airball-aero/airball-embedded/arduino/README.md

<!--
 The MIT License (MIT)

 Copyright (c) 2018, Jeremy Cole

 Permission is hereby granted, free of charge, to any person obtaining a copy
 of this software and associated documentation files (the "Software"), to deal
 in the Software without restriction, including without limitation the rights
 to use, copy, modify, merge, publish, distribute, sublicense, and/or sell
 copies of the Software, and to permit persons to whom the Software is
 furnished to do so, subject to the following conditions:

 The above copyright notice and this permission notice shall be included in
 all copies or substantial portions of the Software.

 THE SOFTWARE IS PROVIDED "AS IS", WITHOUT WARRANTY OF ANY KIND, EXPRESS OR
 IMPLIED, INCLUDING BUT NOT LIMITED TO THE WARRANTIES OF MERCHANTABILITY,
 FITNESS FOR A PARTICULAR PURPOSE AND NONINFRINGEMENT. IN NO EVENT SHALL THE
 AUTHORS OR COPYRIGHT HOLDERS BE LIABLE FOR ANY CLAIM, DAMAGES OR OTHER
 LIABILITY, WHETHER IN AN ACTION OF CONTRACT, TORT OR OTHERWISE, ARISING FROM,
 OUT OF OR IN CONNECTION WITH THE SOFTWARE OR THE USE OR OTHER DEALINGS IN
 THE SOFTWARE.
-->

Support for the SparkFun Fio v3 must be added to the Arduino IDE, by following the [installation instructions](https://github.com/sparkfun/Arduino_Boards#installation-instructions) to add the SparkFun Arduino Boards repository as an additional board manager URL. Once the SparkFun Arduino Boards are installed, "SparkFun Fio v3" should be available as a board choice (Tools → Board → Arduino AVR Boards → SparkFun Fio v3).

Additionally, the following Arduino libraries must also be installed:

* [TI\_TCA9548A](https://github.com/jeremycole/TI_TCA9548A) – Used for the TI TCA9548A I²C multiplexer.
* [AllSensors\_DLHR](https://github.com/jeremycole/AllSensors_DLHR) – Used for the AllSensors DLHR differential pressure sensors.
* [AllSensors\_DLV](https://github.com/jeremycole/AllSensors_DLV) – Used for the AllSensors DLV absolute pressure sensor.
* [Temperature\_LM75\_Derived](https://github.com/jeremycole/Temperature_LM75_Derived) – Used for the on-board TI TMP275 temperature sensor.
* [OneWire](https://github.com/PaulStoffregen/OneWire) – Used by the DallasTemperature library.
* [DallasTemperature](https://github.com/milesburton/Arduino-Temperature-Control-Library) – Used for the external Maxim DS18B20 1-Wire temperature sensor for measuring outside air temperature.
* [Maxim_DS2782](https://github.com/jeremycole/Maxim_DS2782) – Used for the on-board battery management IC.
* [TimerOne](http://playground.arduino.cc/Code/Timer1) – Used to set up an interrupt to trigger measurement at a specific interval.

The above libraries may be installed using one of the following methods:

1. Using the Arduino IDE's library manager (Sketch → Include Library → Manage Libraries...) to download the most current version and allow automatic updates with new releases.
2. Downloading a specific release (or the "master" branch) from Github as a .ZIP file and installing it using the Arduino IDE's library manager (Sketch → Include Library → Add .ZIP Library...).
3. Manually installing either the .ZIP file as above or cloning the Git repository itself into the `libraries` subdirectory in the Arduino Sketchbook directory (Settings → Sketchbook location) – or doing so here and re-setting the sketchbook directory to this directory.
