airball-aero/airball-embedded/data/2018-02-10-01/README.md

Test flight in Cessna 172 N2021L, probe mounted on strut. Two flights,
KPAO KHAF and return KHAF KPAO.

Plots discussed in the following article:
http://www.airball.aero/2018/02/yaw-bias-due-to-asymmetric-mounting.html
