airball-aero/airball-embedded/data/2018-02-02-01/README.md

This is *Airball Sensor Board V3 (2018-01-18)* with no baro sensor, in
a road test on the car mast. Traffic was busy so the peak speed,
observed near the start of the dataset, was 59mph, and the remainder
of the test was during slow-and-go traffic.
