airball-aero/airball-embedded/data/2017-12-22-01/README

Probe with possibly damaged board sitting on the desk, sending data. The
two files are for on-battery and on-USB-power operation. Lots of spikes
in the readings which are as of yet unexplained.
