airball-aero/airball-embedded/data/2017-12-10-01/README

Test run on Highway 280 with the probe on top of the car mast. Pitot
sensor only since only one pressure gage (plus temperature) installed
on the board.
