airball-aero/airball-embedded/data/2017-12-26-01/all.png

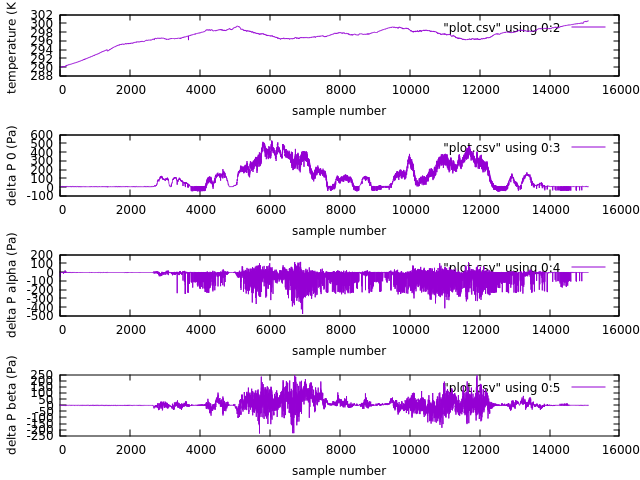
data/2017-12-26-01/all.png
