airball-aero/airball-embedded/data/2017-12-26-01/subset-showing-spikes.png

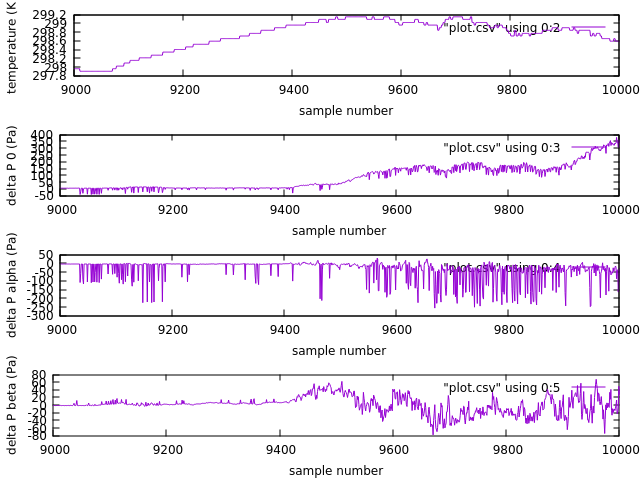
data/2017-12-26-01/subset-showing-spikes.png
