airball-aero/airball-embedded/data/2017-12-30-01/data.png

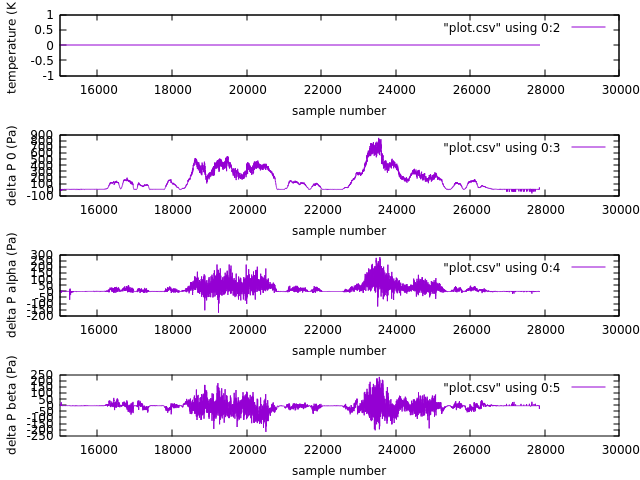
data/2017-12-30-01/data.png
