airball-aero/airball-embedded/data/2017-12-30-01/delta_p_0_75mph.png

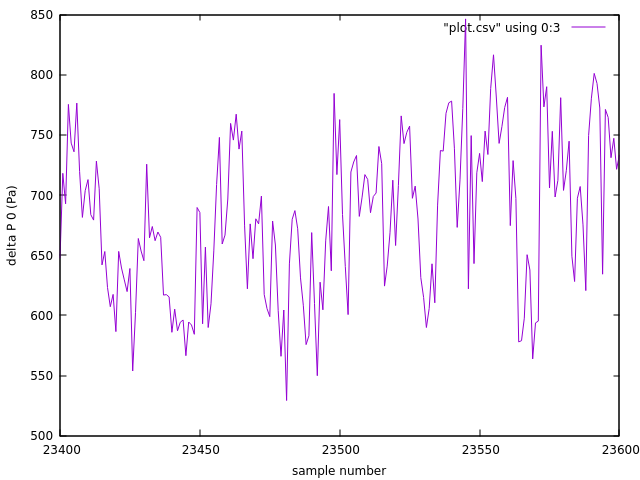
data/2017-12-30-01/delta_p_0_75mph.png
