airball-aero/airball-embedded/data/2017-12-30-01/delta_p_0_spikes.png

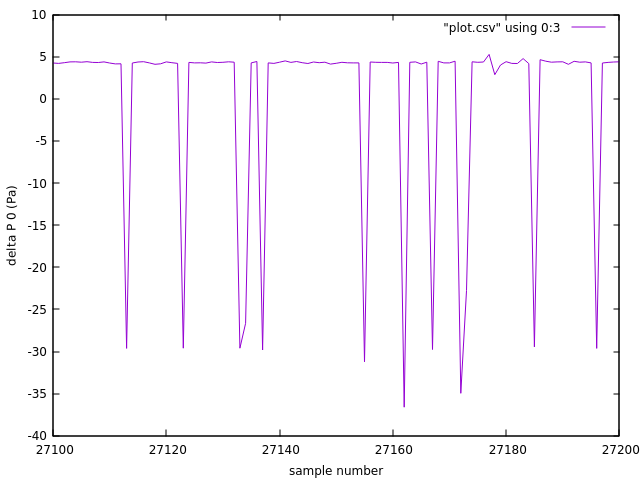
data/2017-12-30-01/delta_p_0_spikes.png
