airball-aero/airball-embedded/data/2017-12-30-01/fir-filter-airdata.png

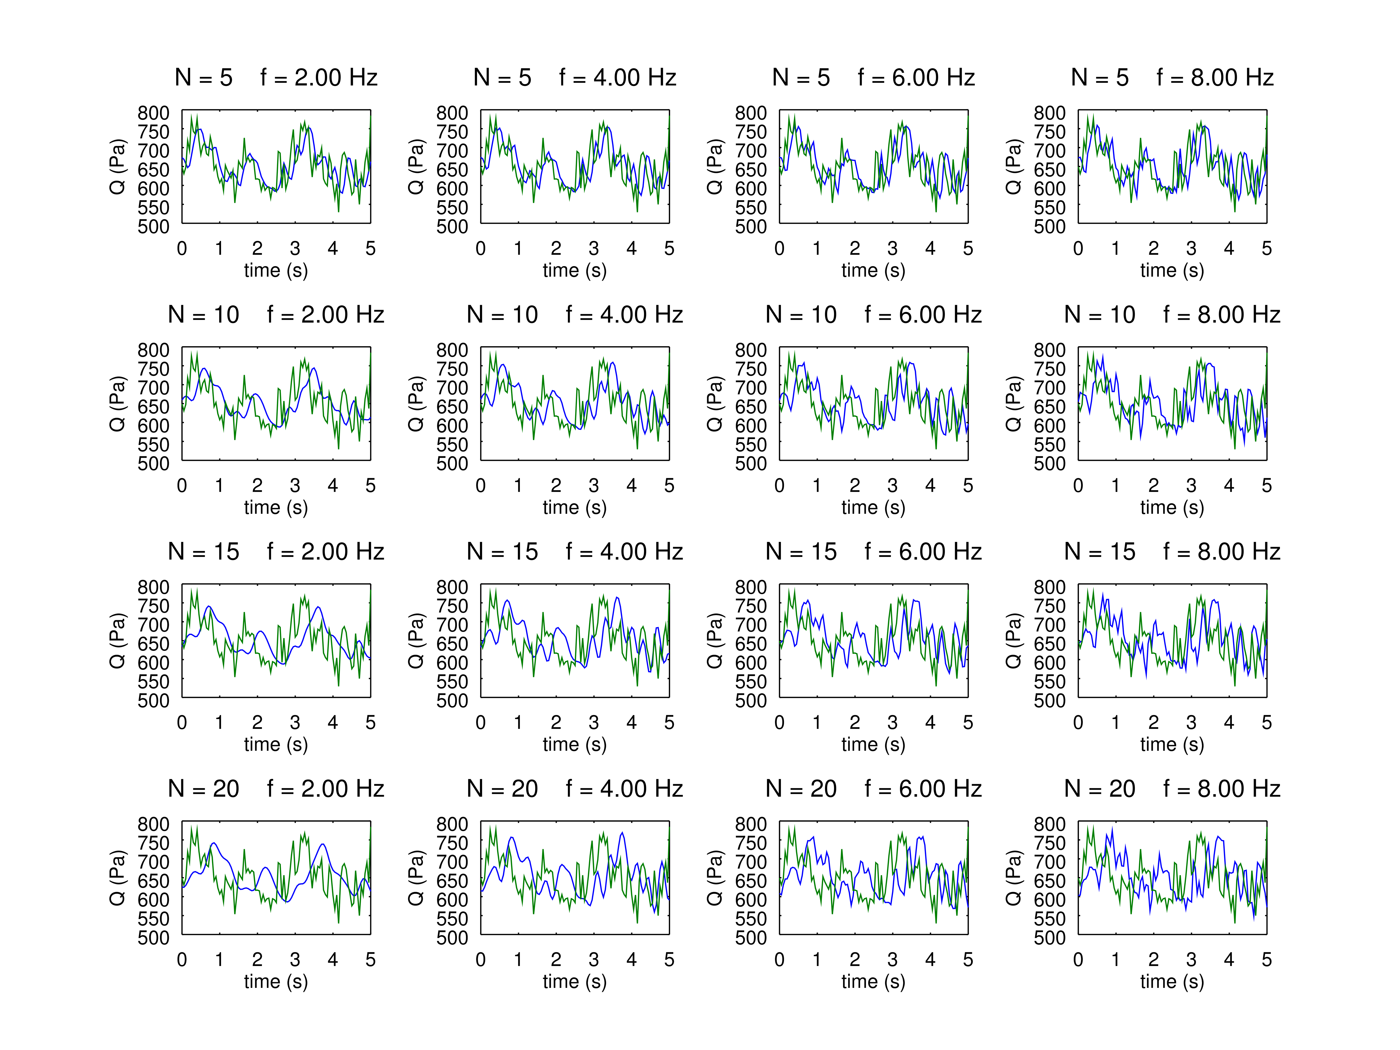
data/2017-12-30-01/fir-filter-airdata.png
