airball-aero/airball-embedded/data/2018-02-02-01/all_variables.png

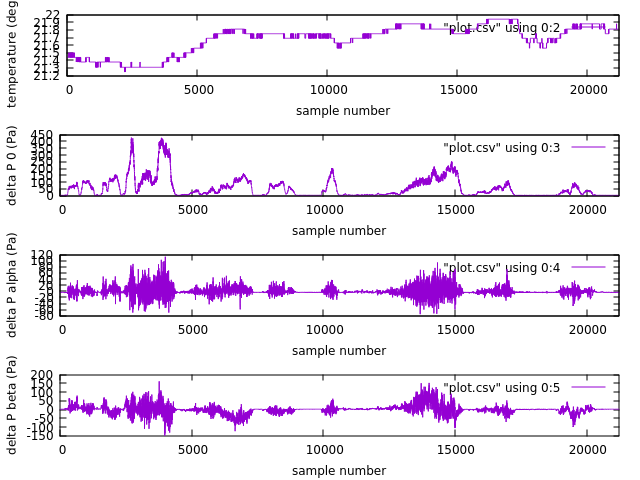
data/2018-02-02-01/all_variables.png
