airball-aero/airball-embedded/data/2018-02-02-01/high_speed_region.png

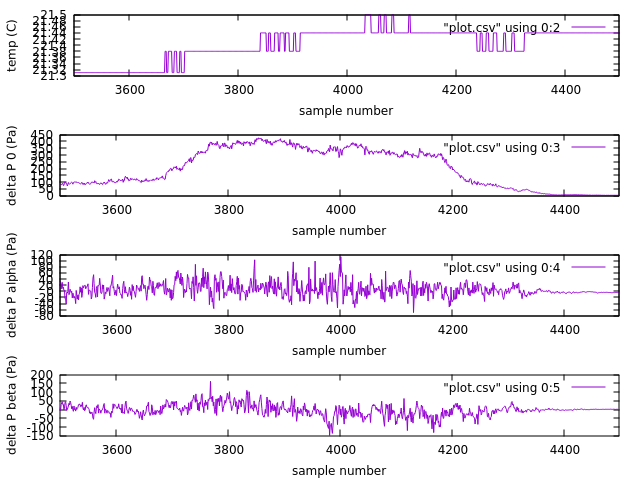
data/2018-02-02-01/high_speed_region.png
