airball-aero/airball-embedded/data/2018-02-10-01/beta_vs_dp0_slowing.png

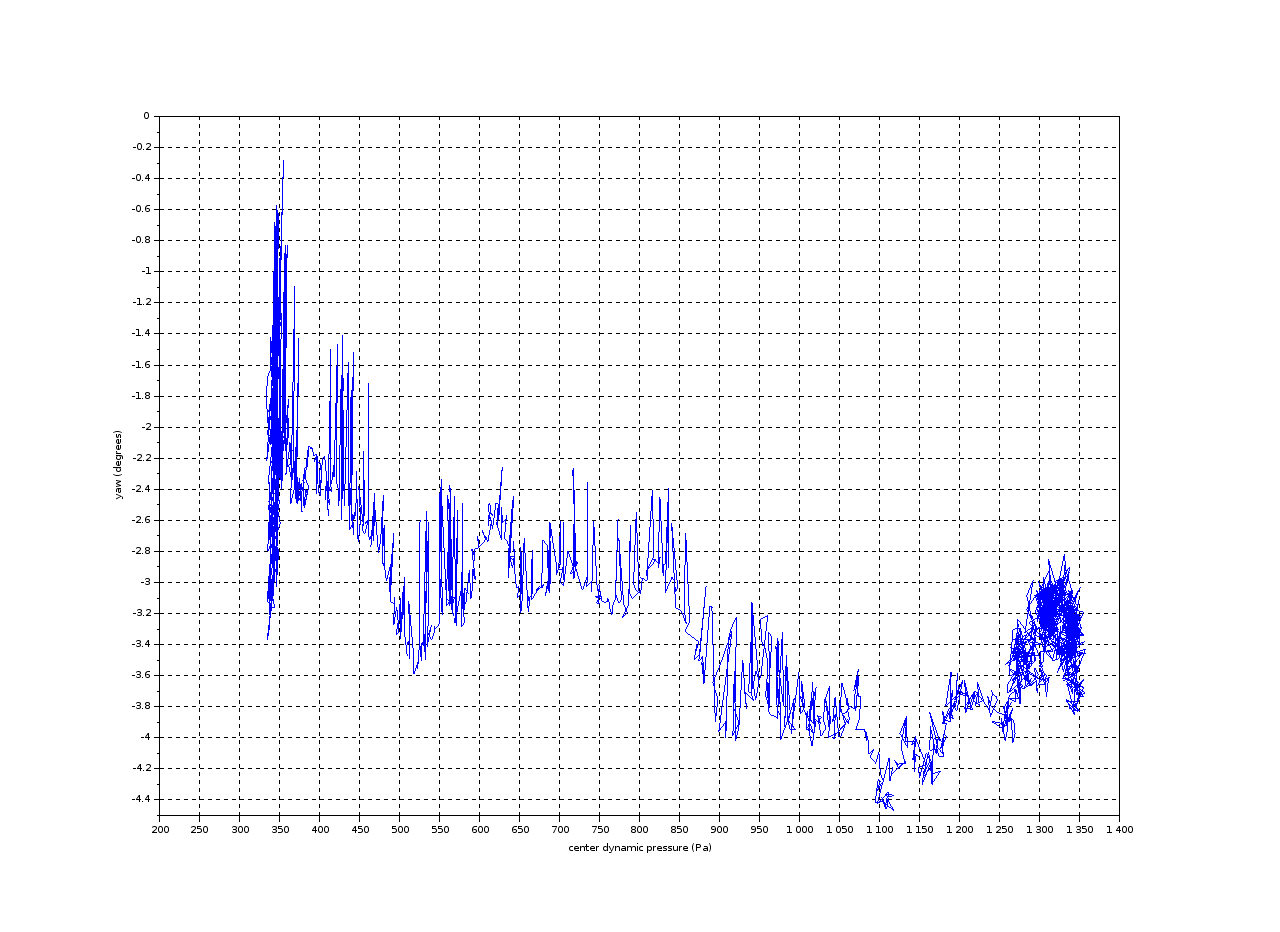
data/2018-02-10-01/beta_vs_dp0_slowing.png
