airball-aero/airball-embedded/data/2018-02-10-01/dp0_and_beta_maneuvers.png

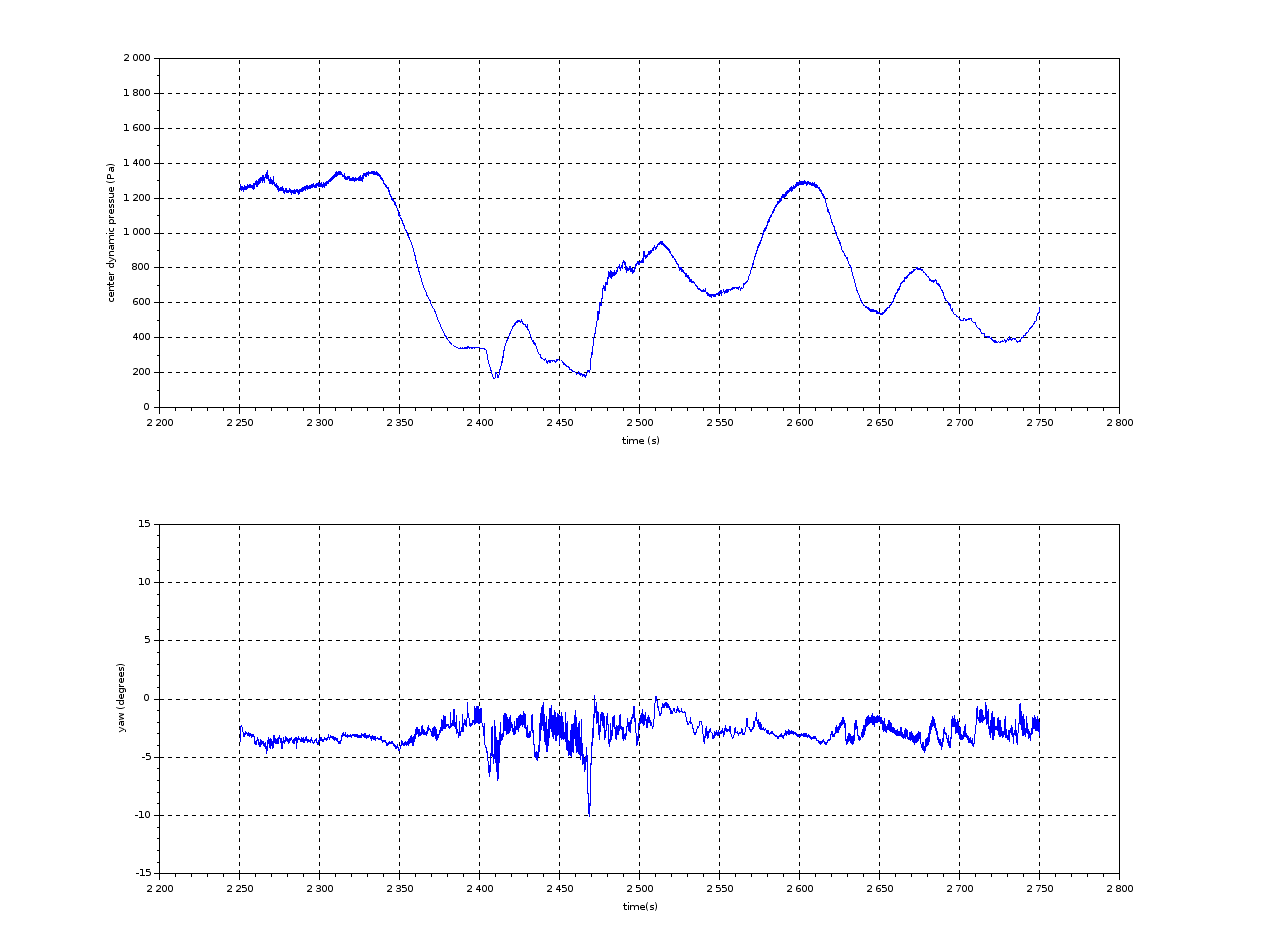
data/2018-02-10-01/dp0_and_beta_maneuvers.png
