airball-aero/airball-embedded/data/2018-03-09-01/entire_flight.png

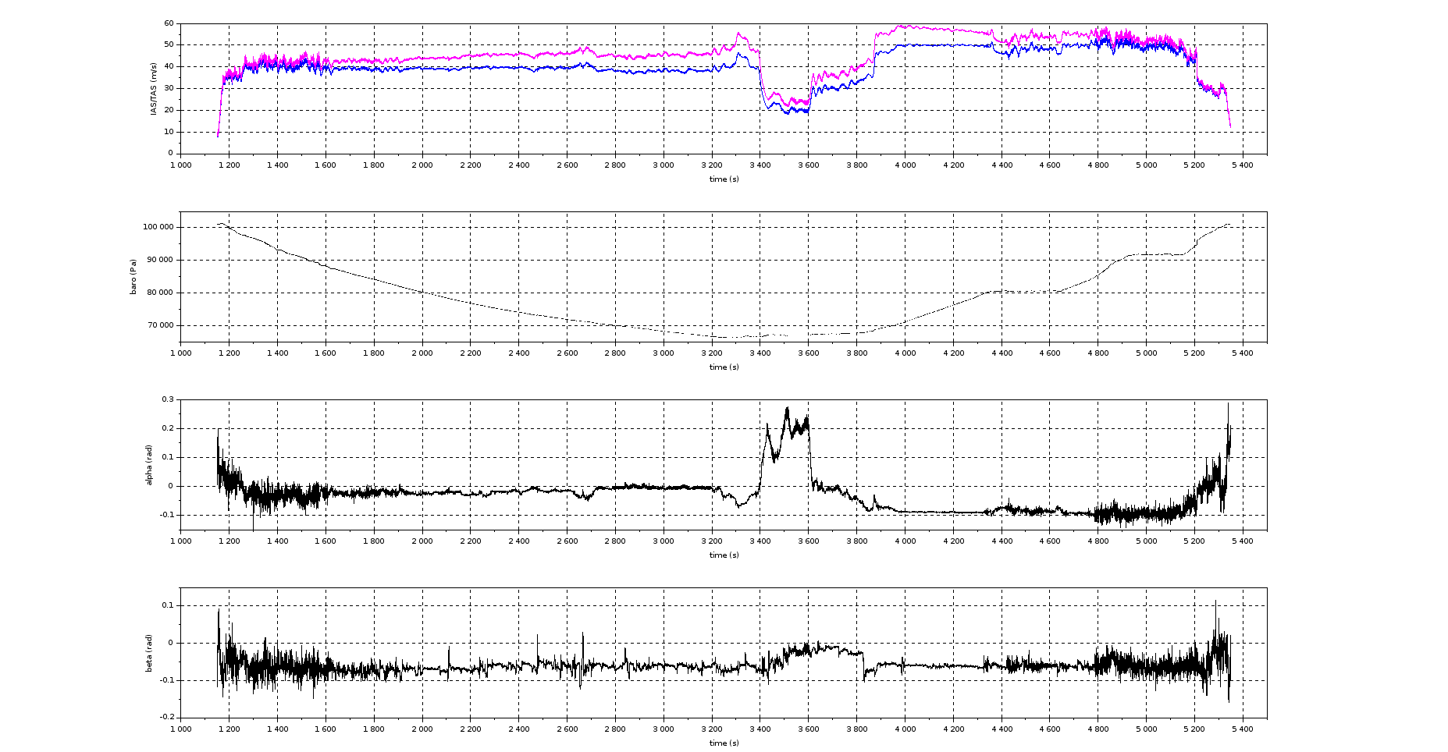
data/2018-03-09-01/entire_flight.png
