airball-aero/airball-embedded/data/2018-03-29-1/alpha_vs_ias.png

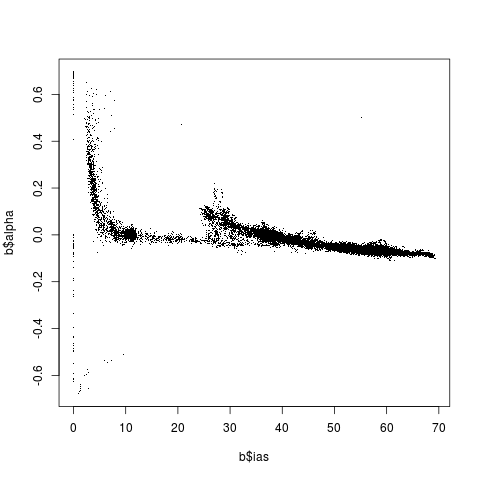
data/2018-03-29-1/alpha_vs_ias.png
