airball-aero/airball-embedded/data/2018-03-29-1/baro.png

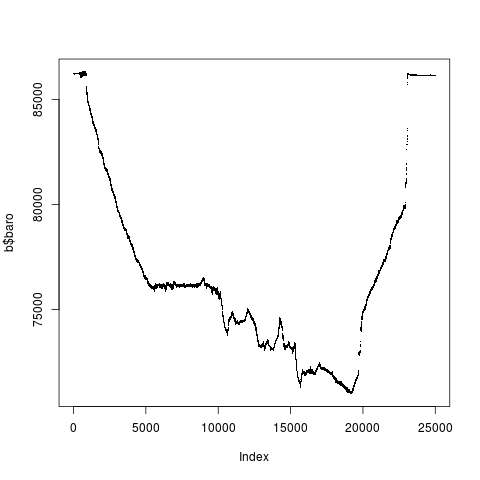
data/2018-03-29-1/baro.png
