airball-aero/airball-embedded/data/2018-03-29-1/ias_tas.png

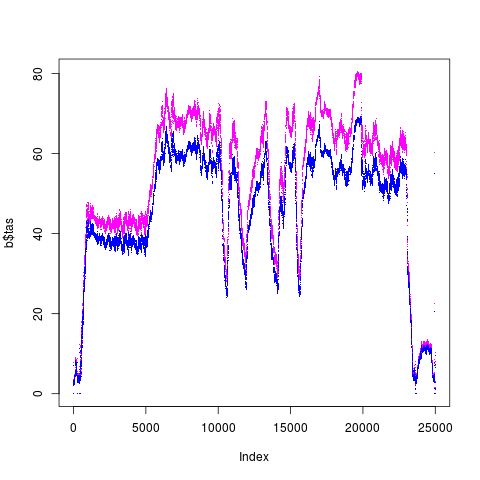
data/2018-03-29-1/ias_tas.png
