airball-aero/airball-embedded/data/2018-03-29-1/q.png

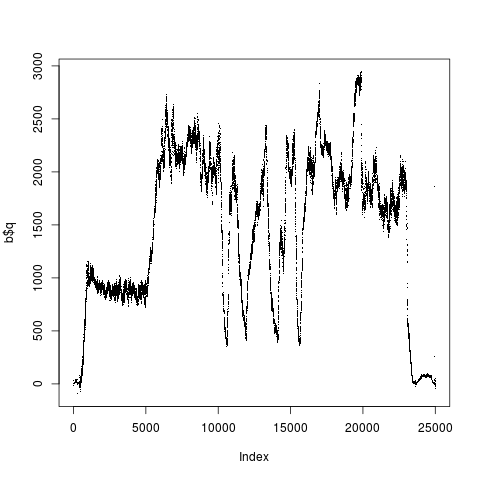
data/2018-03-29-1/q.png
