airball-aero/airball-embedded/firmware/airball_probe_esp32/alpha_beta_to_deltas_dpa.png

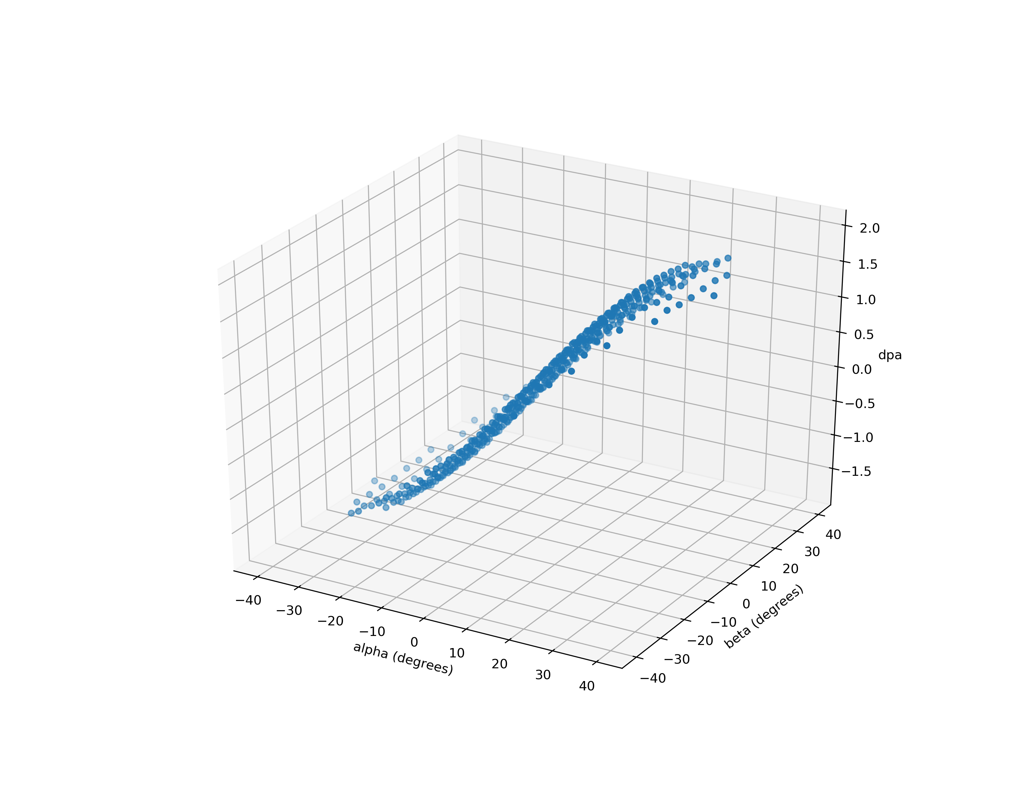
firmware/airball_probe_esp32/alpha_beta_to_deltas_dpa.png
