airball-aero/airball-embedded/firmware/airball_probe_esp32/curve_fit_1_over_dp0.png

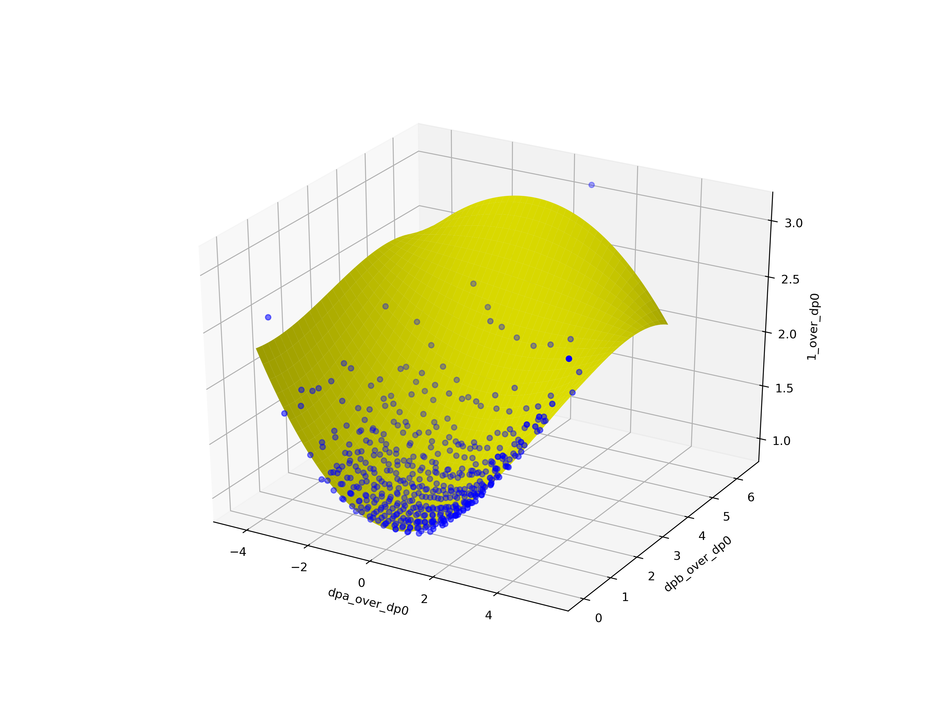
firmware/airball_probe_esp32/curve_fit_1_over_dp0.png
