airball-aero/airball-embedded/firmware/airball_probe_esp32/curve_fit_alpha.png

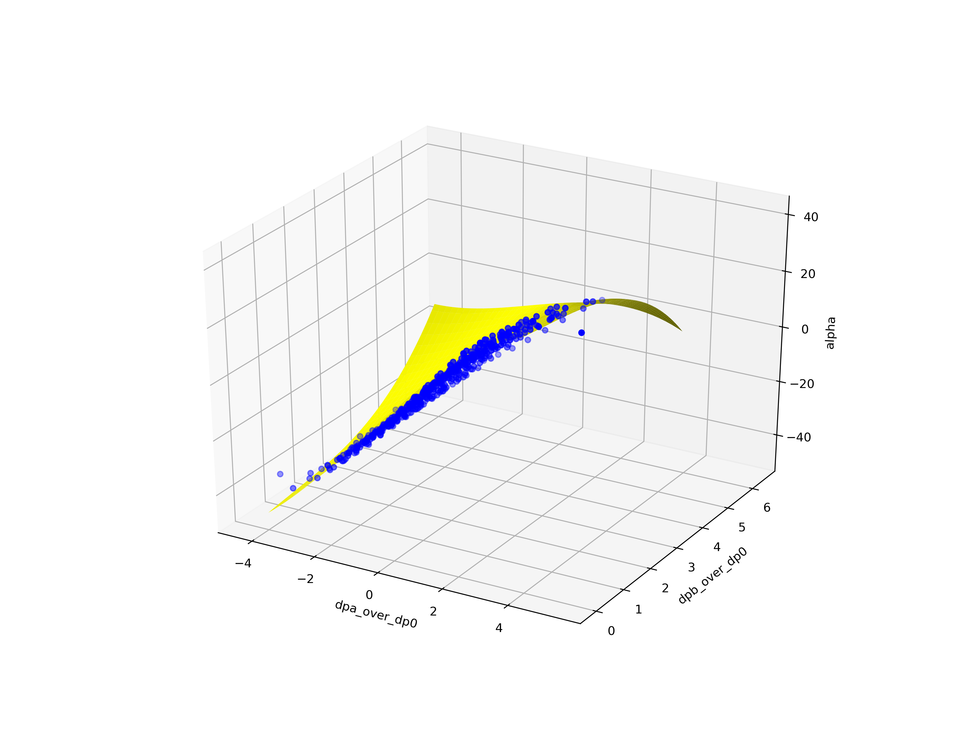
firmware/airball_probe_esp32/curve_fit_alpha.png
