airball-aero/airball-embedded/firmware/airball_probe_esp32/curve_fit_beta.png

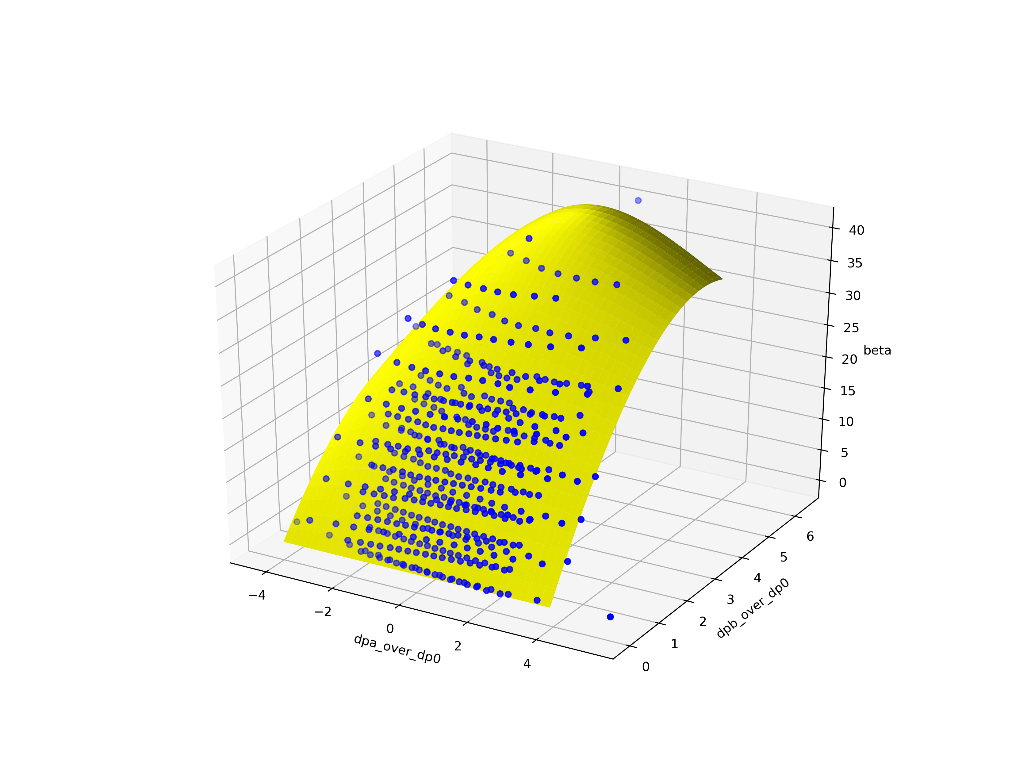
firmware/airball_probe_esp32/curve_fit_beta.png
