airball-aero/airball-embedded/hardware/DisplayBoard/airball_display_board_v1_render_top.png

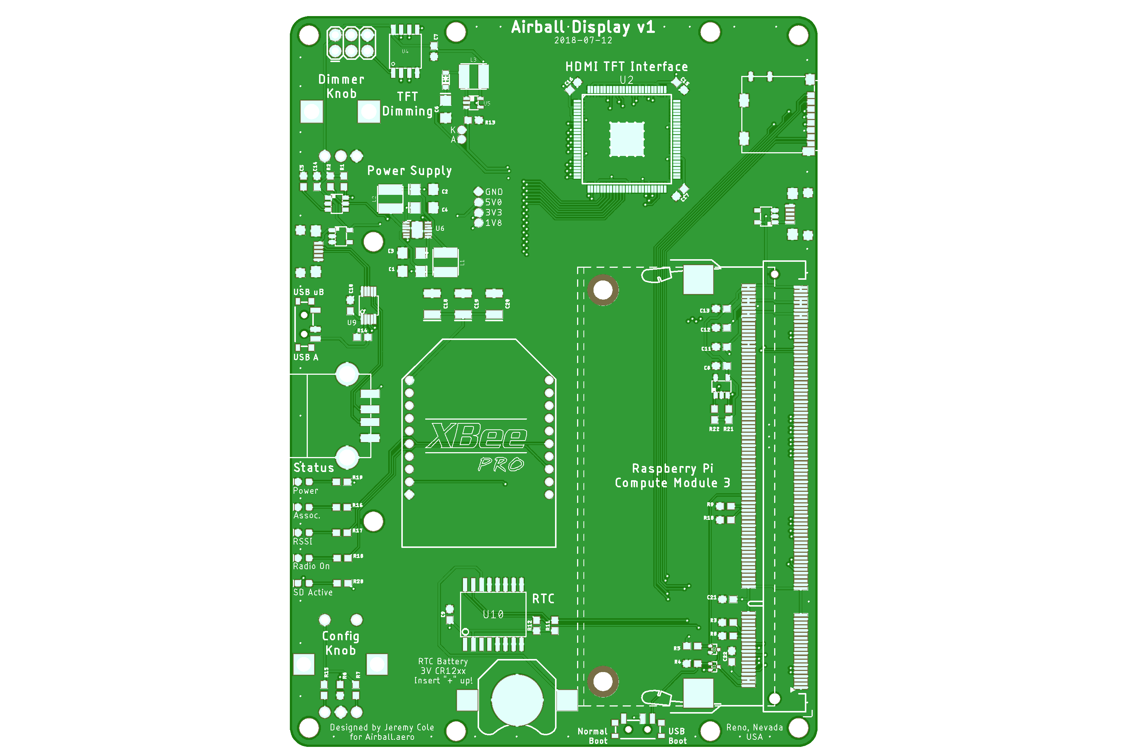
hardware/DisplayBoard/airball_display_board_v1_render_top.png
