airball-aero/airball-embedded/hardware/SensorBoard/stl/airball_sensor_board_v4_20180225_2200.stl

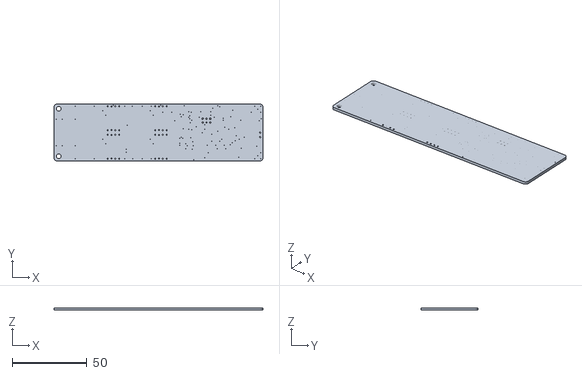
[picture p31: CAD file, 2018-03-03]
hardware/SensorBoard/stl/airball_sensor_board_v4_20180225_2200.stl
139.7 x 38.1 x 1.57
