airball-aero/airball-embedded/firmware/airball_probe_esp32/probe_calibration_1_over_dp0.png

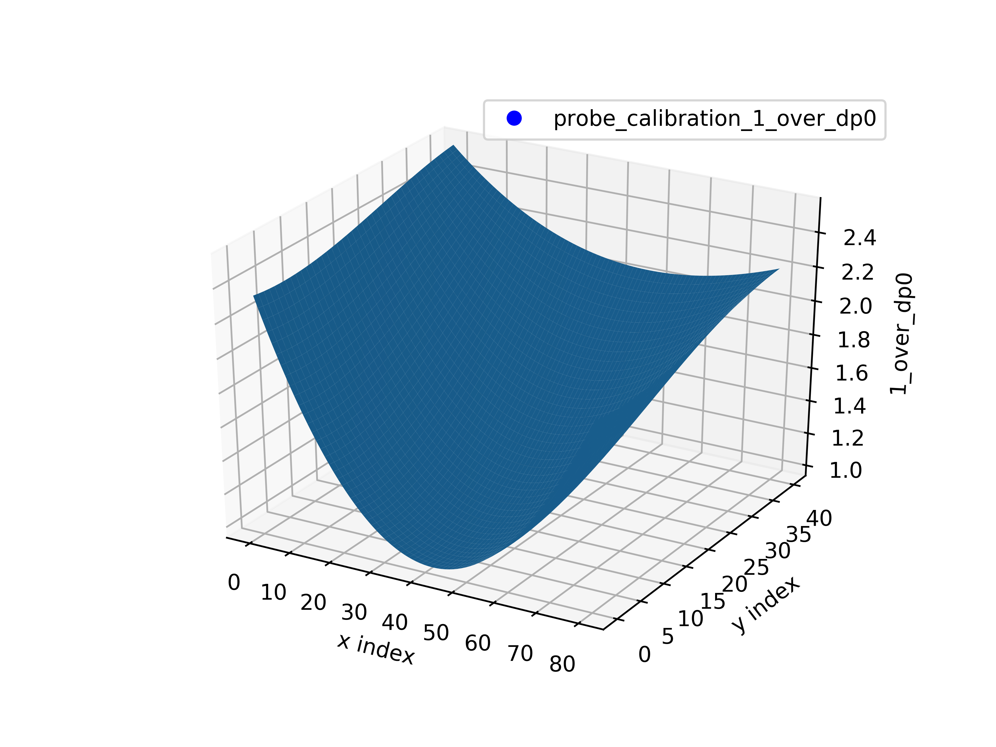
firmware/airball_probe_esp32/probe_calibration_1_over_dp0.png
