airball-aero/airball-embedded/firmware/airball_probe_esp32/probe_calibration_alpha.png

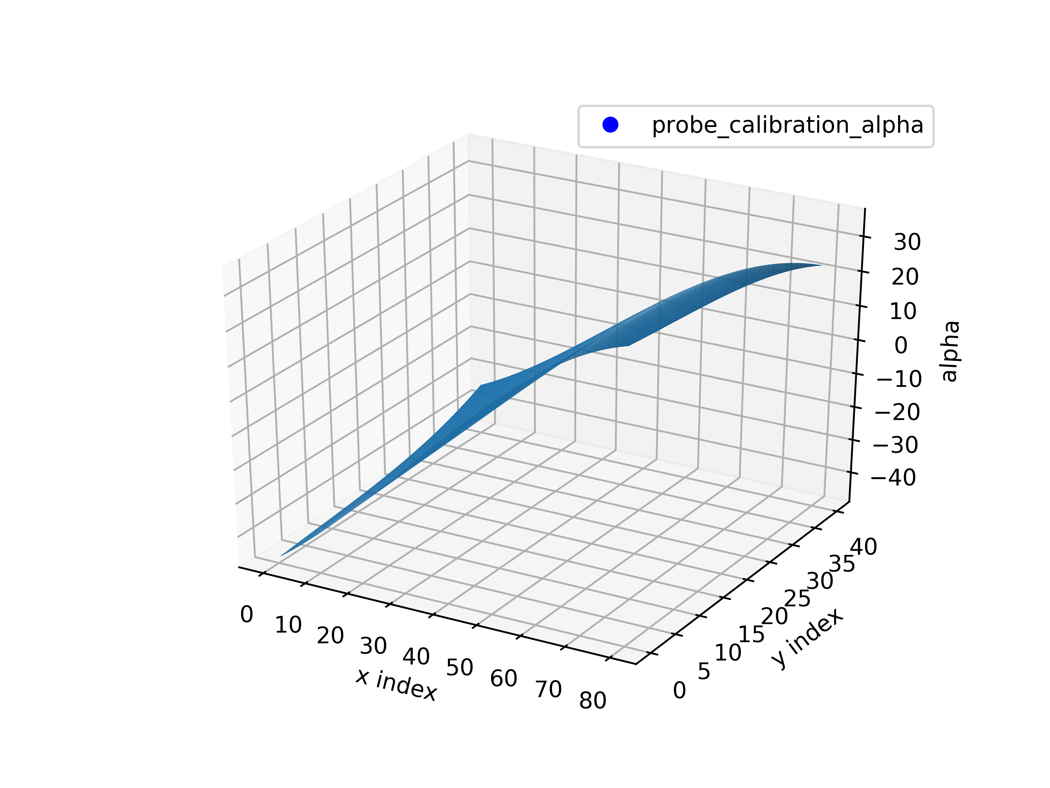
firmware/airball_probe_esp32/probe_calibration_alpha.png
