airball-aero/airball-embedded/firmware/airball_probe_esp32/probe_calibration_beta.png

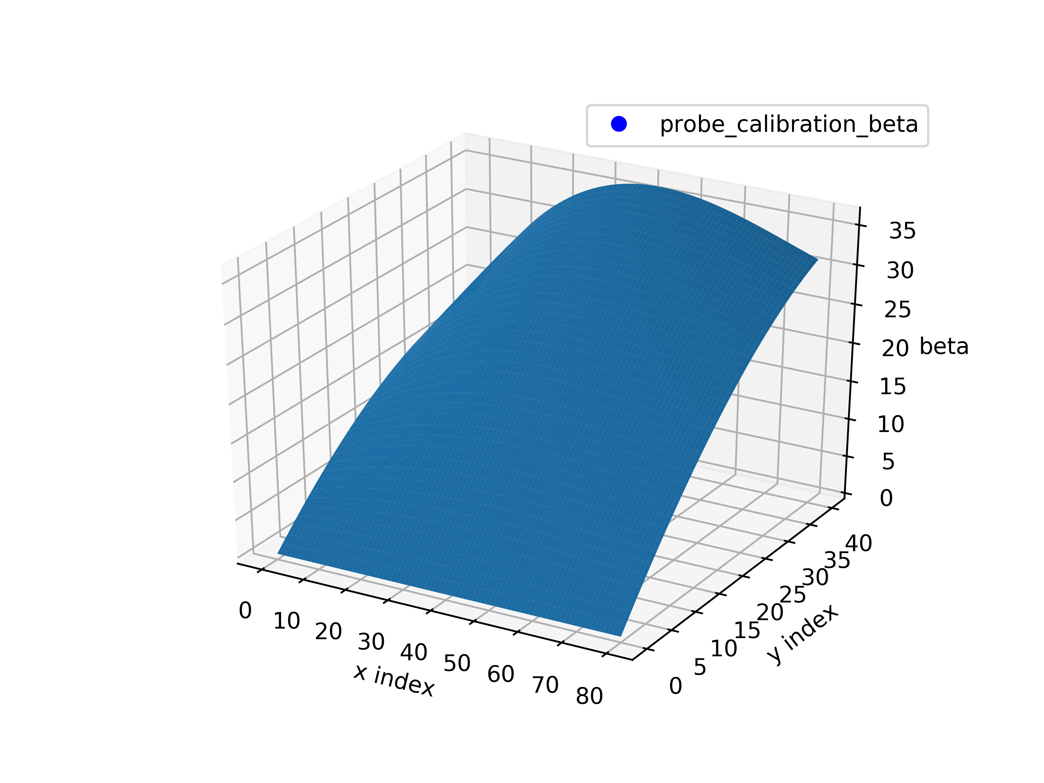
firmware/airball_probe_esp32/probe_calibration_beta.png
