airball-aero/airball-embedded/hardware/SensorBoard/airball_sensor_board_v7_all.pdf

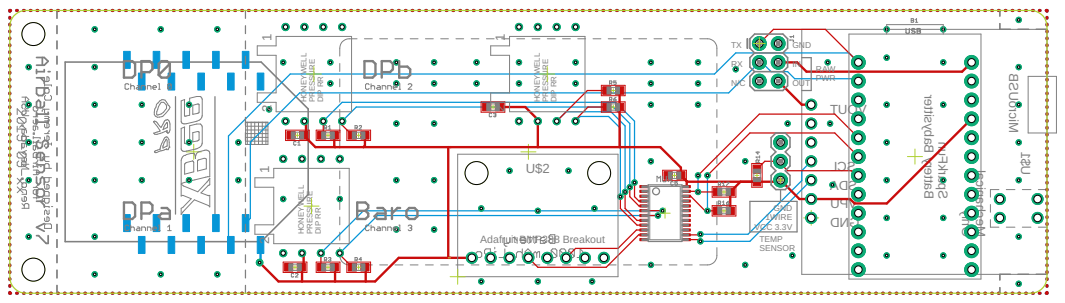
[picture p48: page 1]

U$1 DNG UPV ADS L CS TUOV SparkFun Battery Babysitter Mechanical Only MicroUSOUT B IN RAW PWR TX GND RXN/C TEMP SENSOR 1WIRE GND VCC 3.3V HONEYWELL PRESSURE DIP RR 1 2 HONEYWELL PRESSURE DIP RR 1 2 HONEYWELL PRESSURE DIP RR 1 2 Adafruit BMP388 Breakout U$2
