airball-aero/airball-embedded/hardware/SensorBoard/airball_sensor_board_v7_bottom.pdf

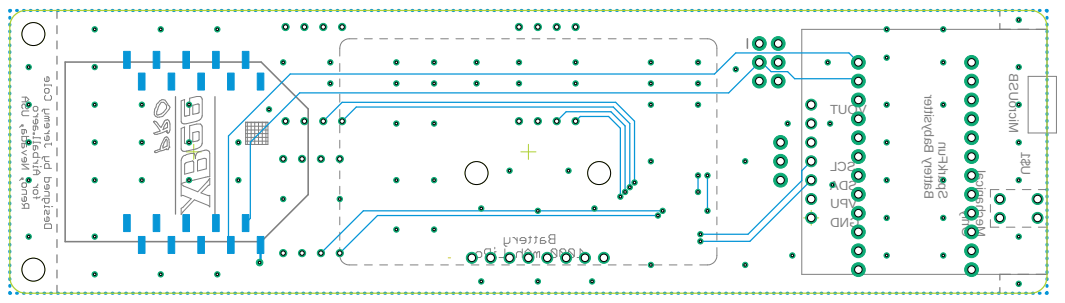
[picture p49: page 1]

U$1 DNG UPV ADS L CS TUOV SparkFun Battery Babysitter Mechanical Only MicroUSB
