airball-aero/airball-embedded/hardware/DisplayBoard/airball_display_board_v1_sch.pdf

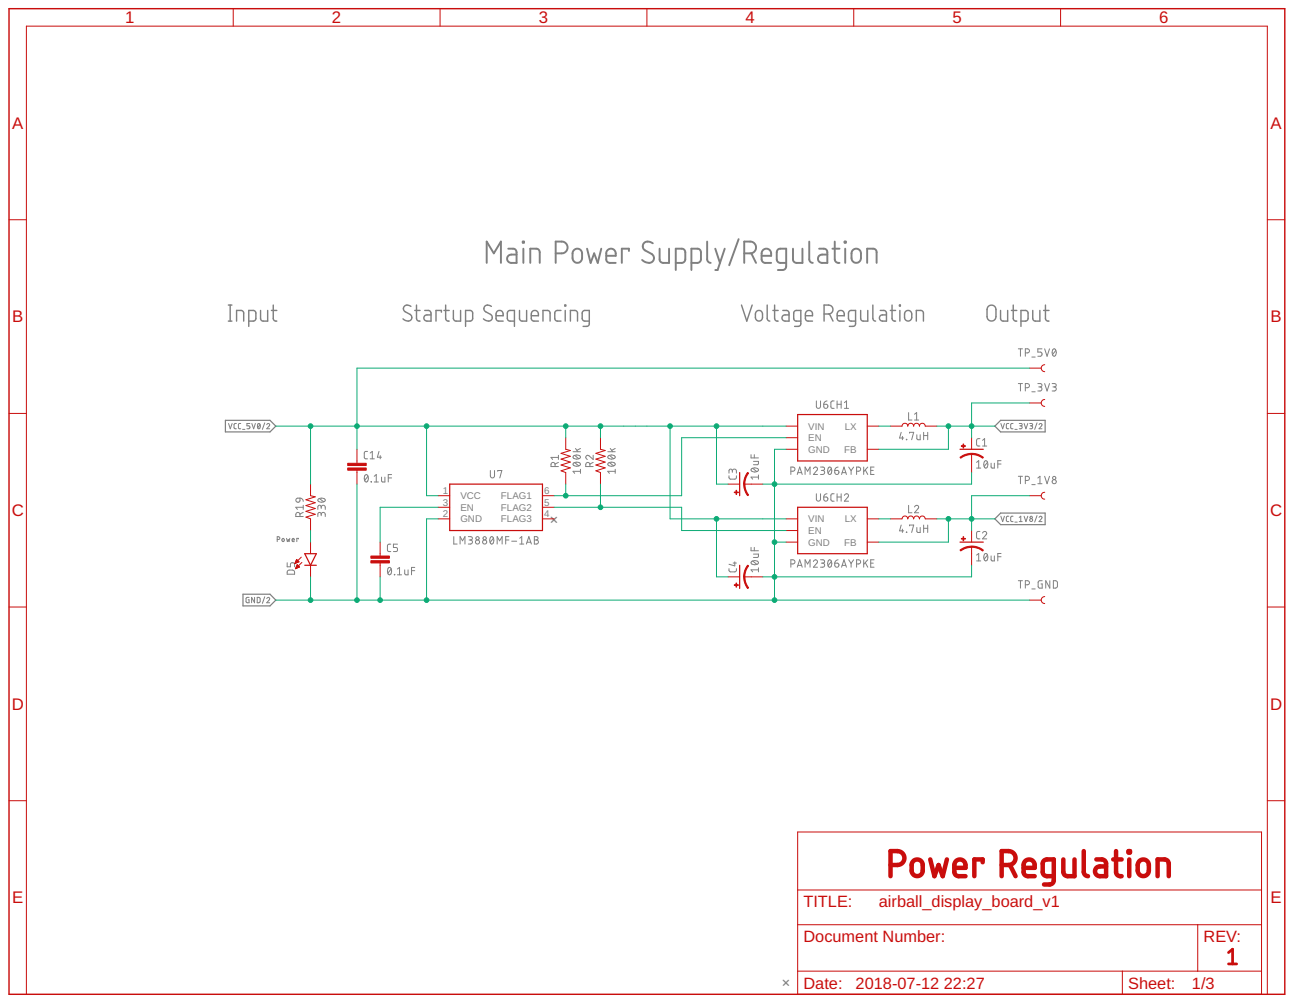
[picture p50: page 1]

Document Number: | REV:

Date: 2018-07-12 22:27 | Sheet: 1/3

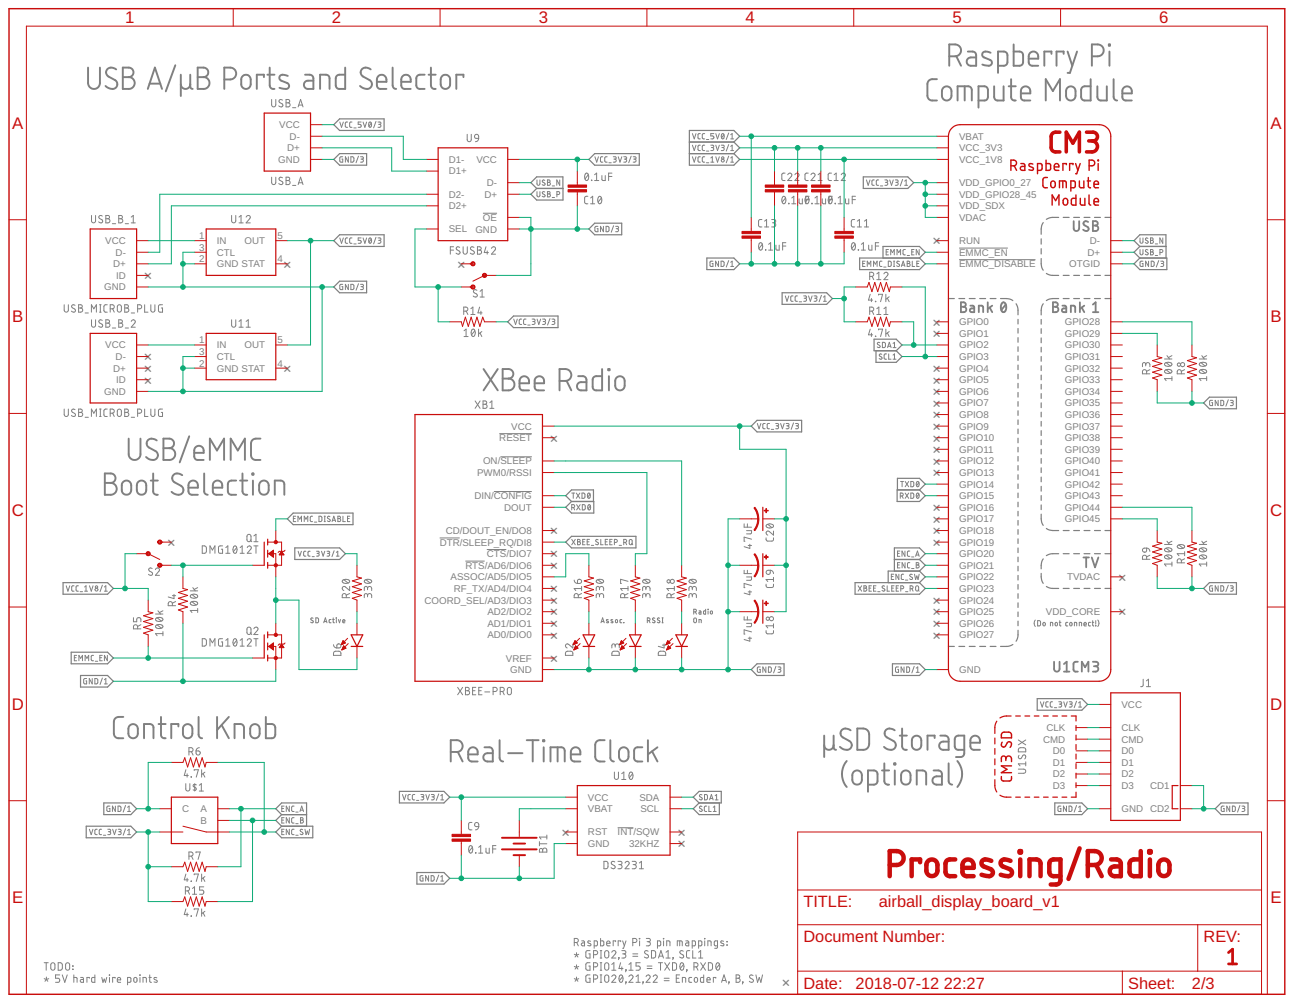
[picture p51: page 2]

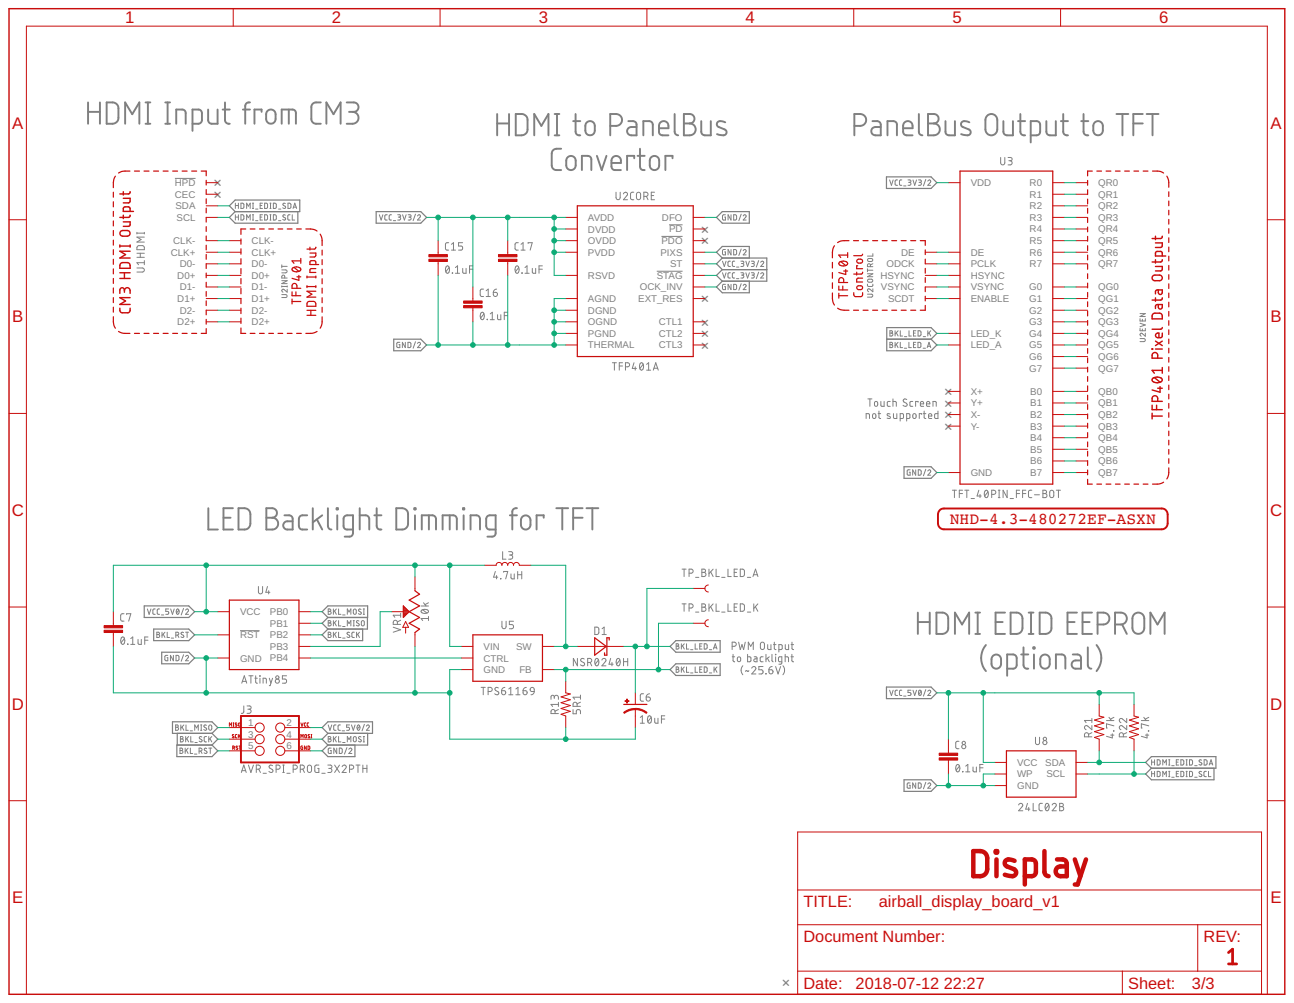
[picture p52: page 3]

CTRL RST PB3 GND PB4 VCC
