airball-aero/airball-embedded/hardware/SensorBoard/airball_sensor_board_v7.pdf

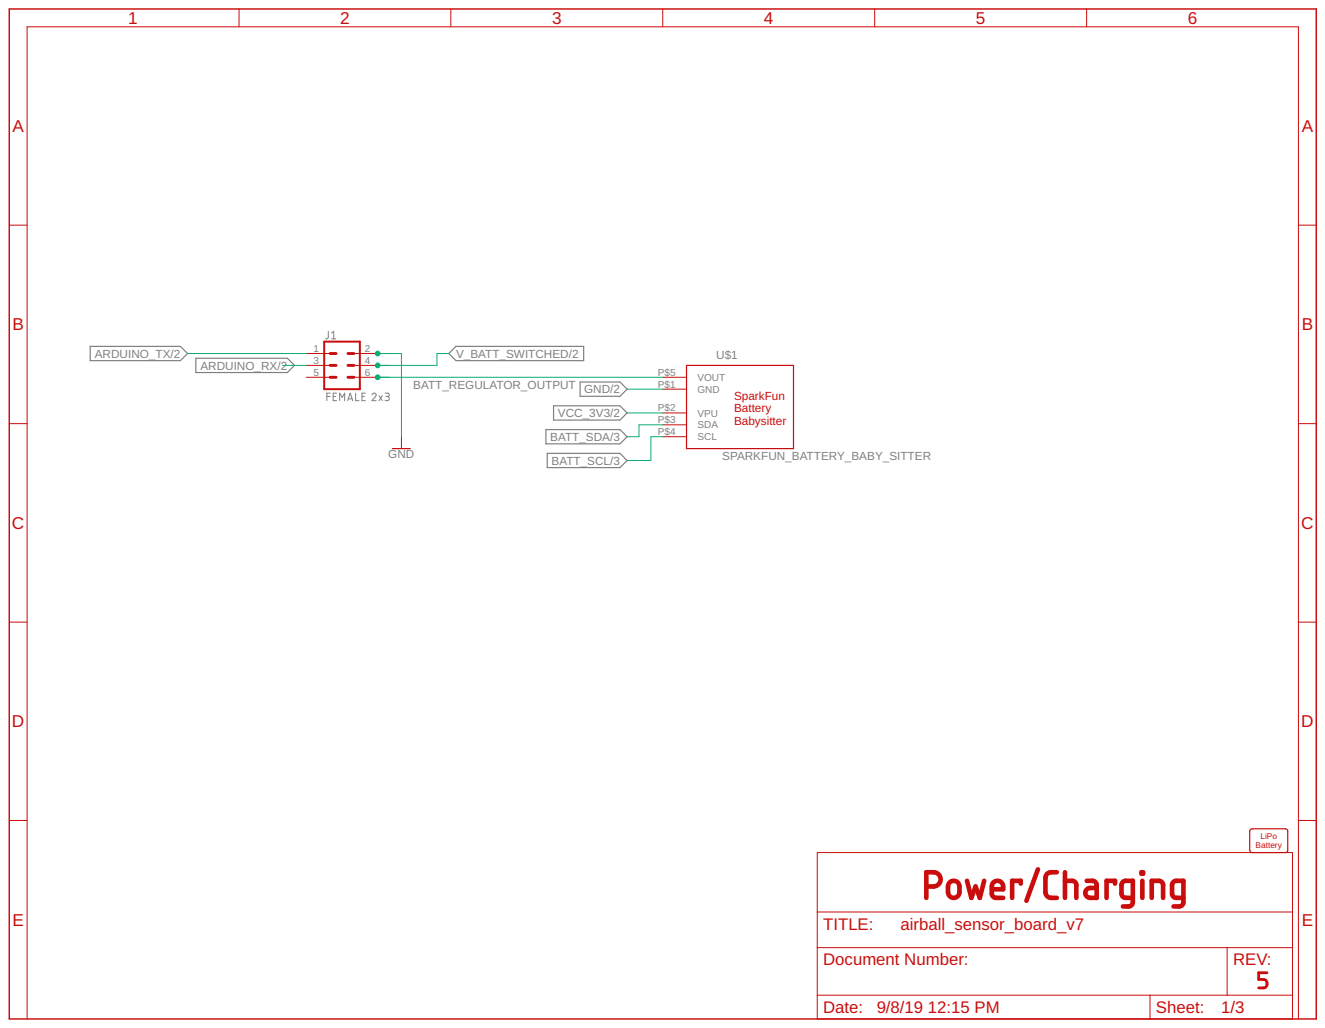
[picture p53: page 1]

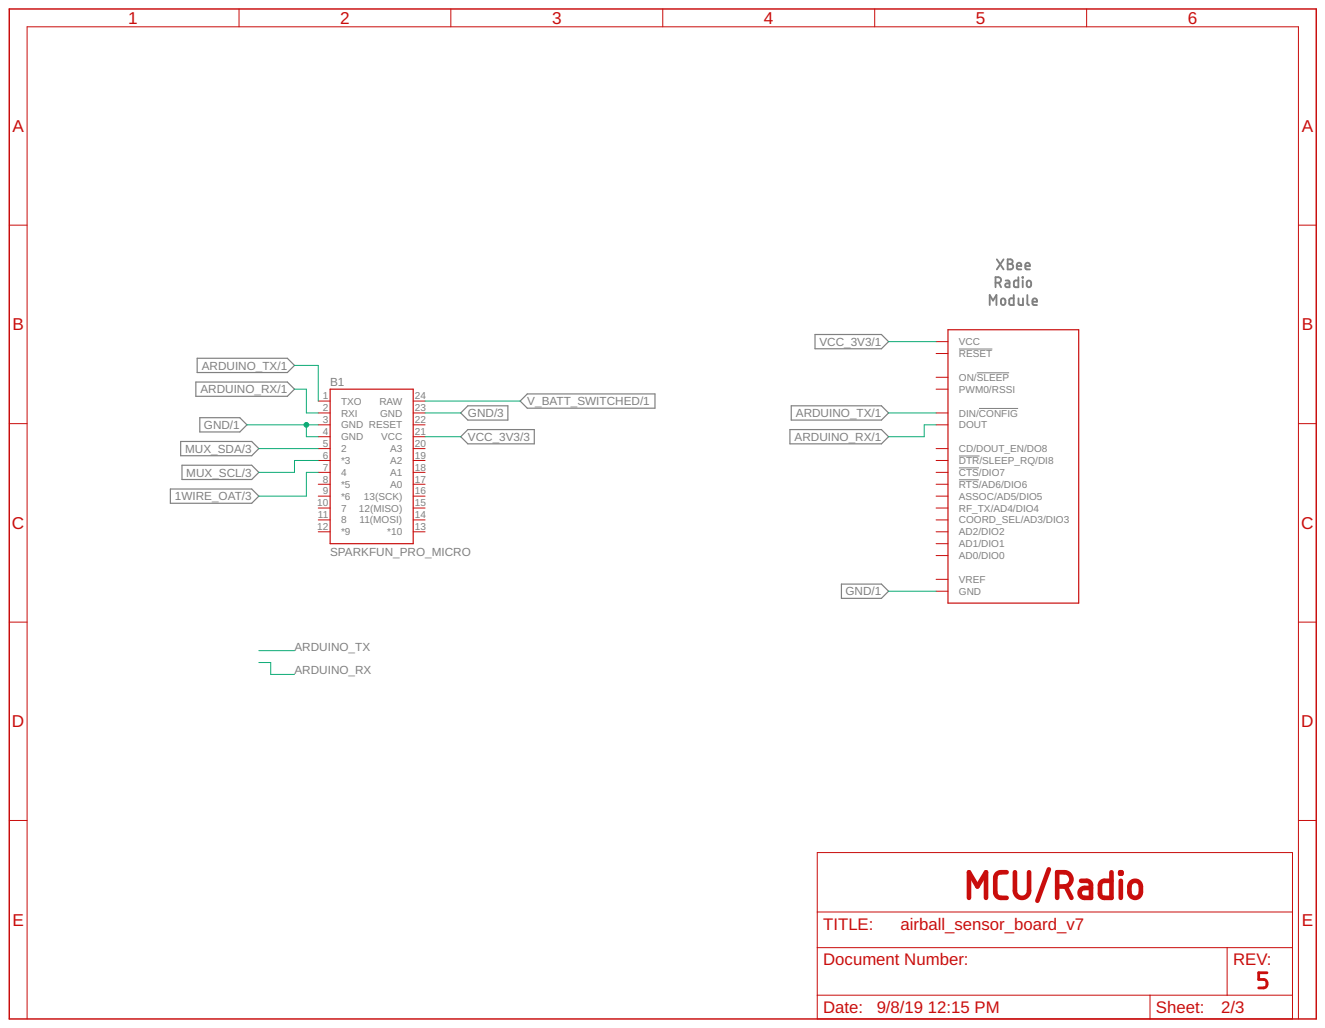
[picture p54: page 2]

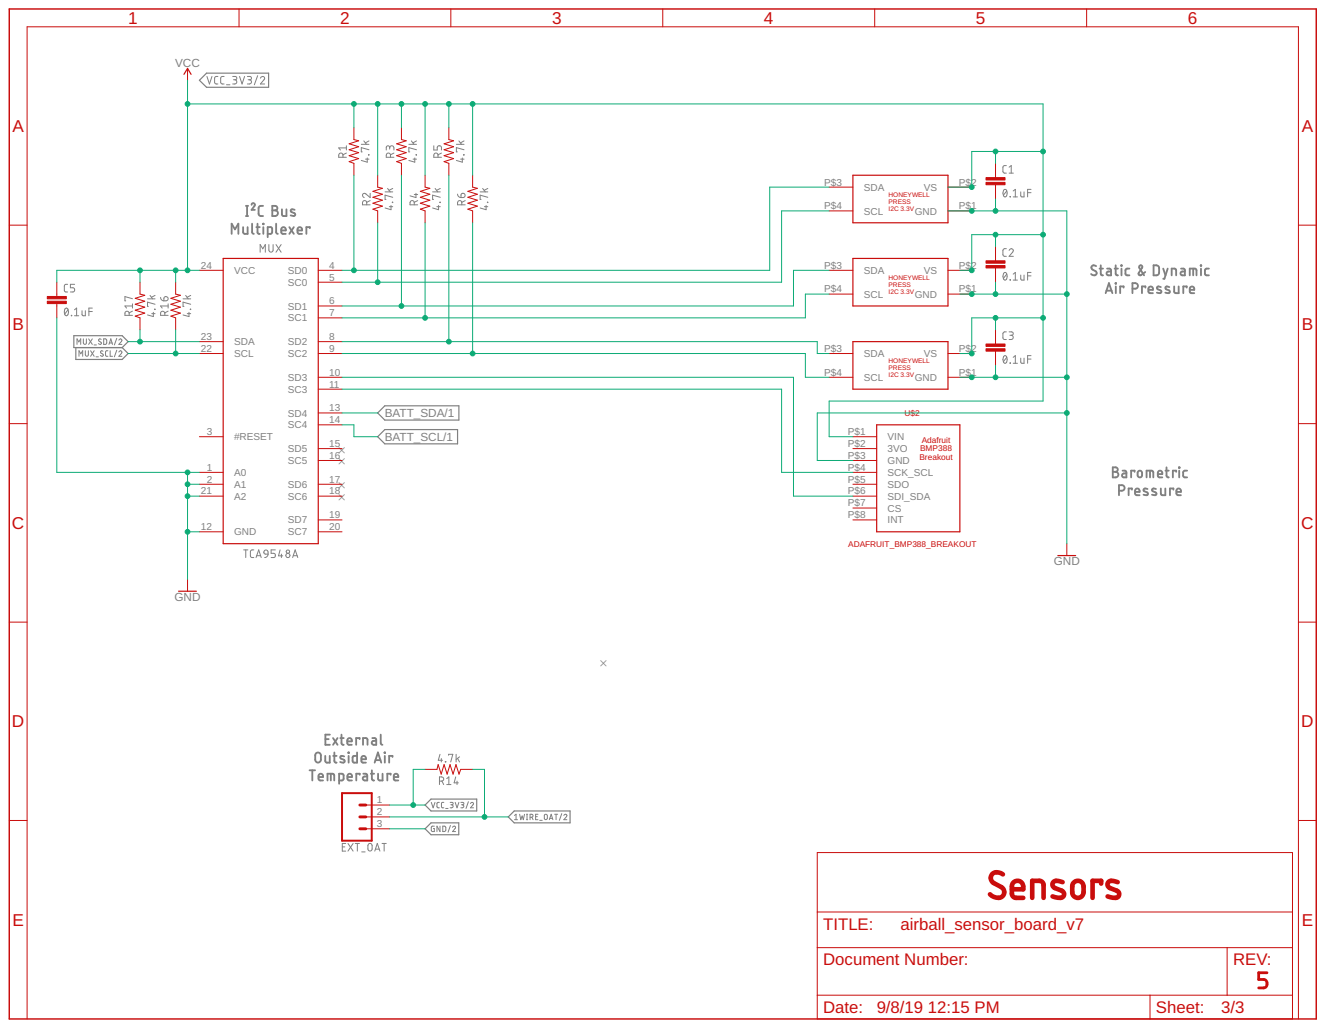
[picture p55: page 3]
