airball-aero/airball-embedded/hardware/SensorBoard/airball_sensor_board_v7_top.pdf

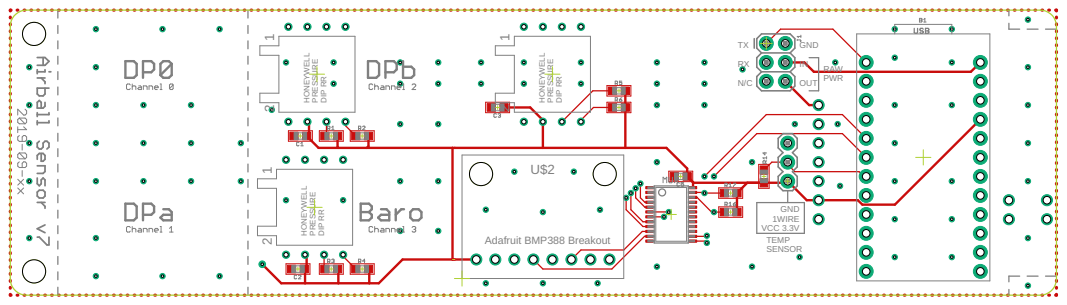
[picture p56: page 1]
