airball-aero/airball-embedded/hardware/SensorBoard/airball_sensor_board_v4.pdf

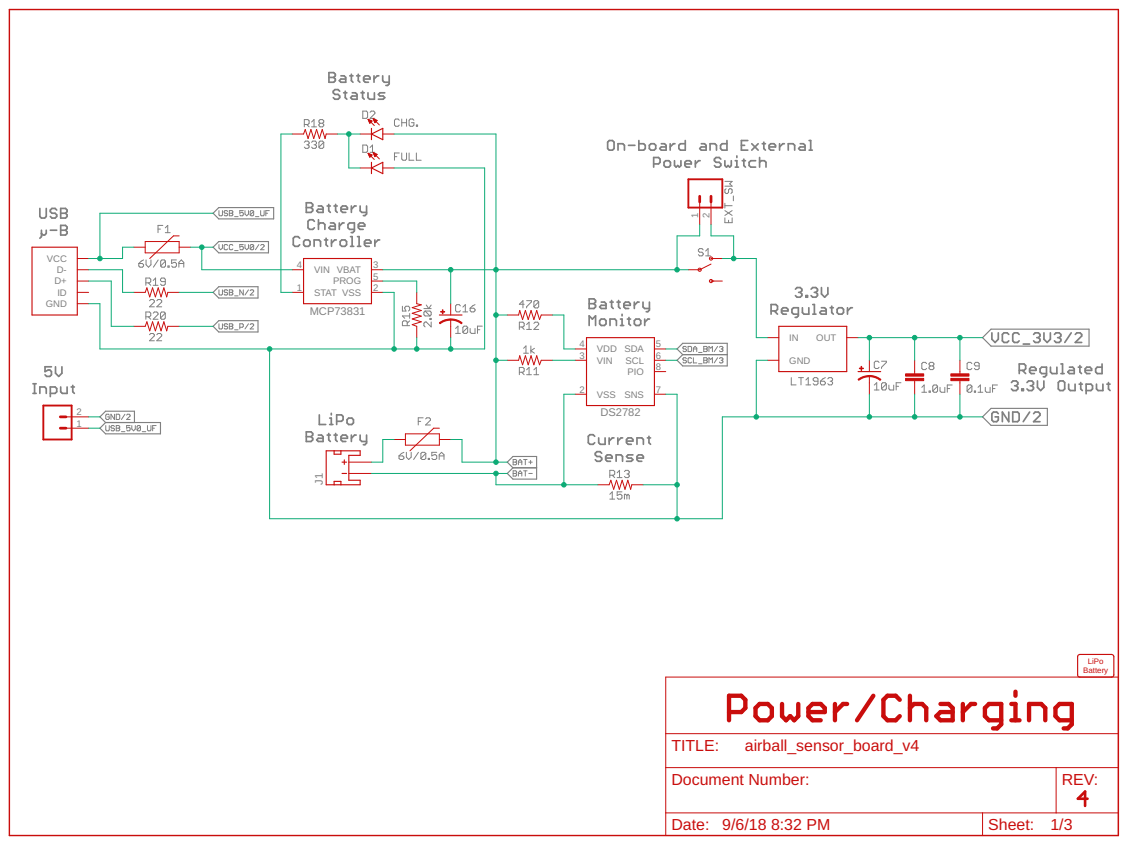
[picture p57: page 1]

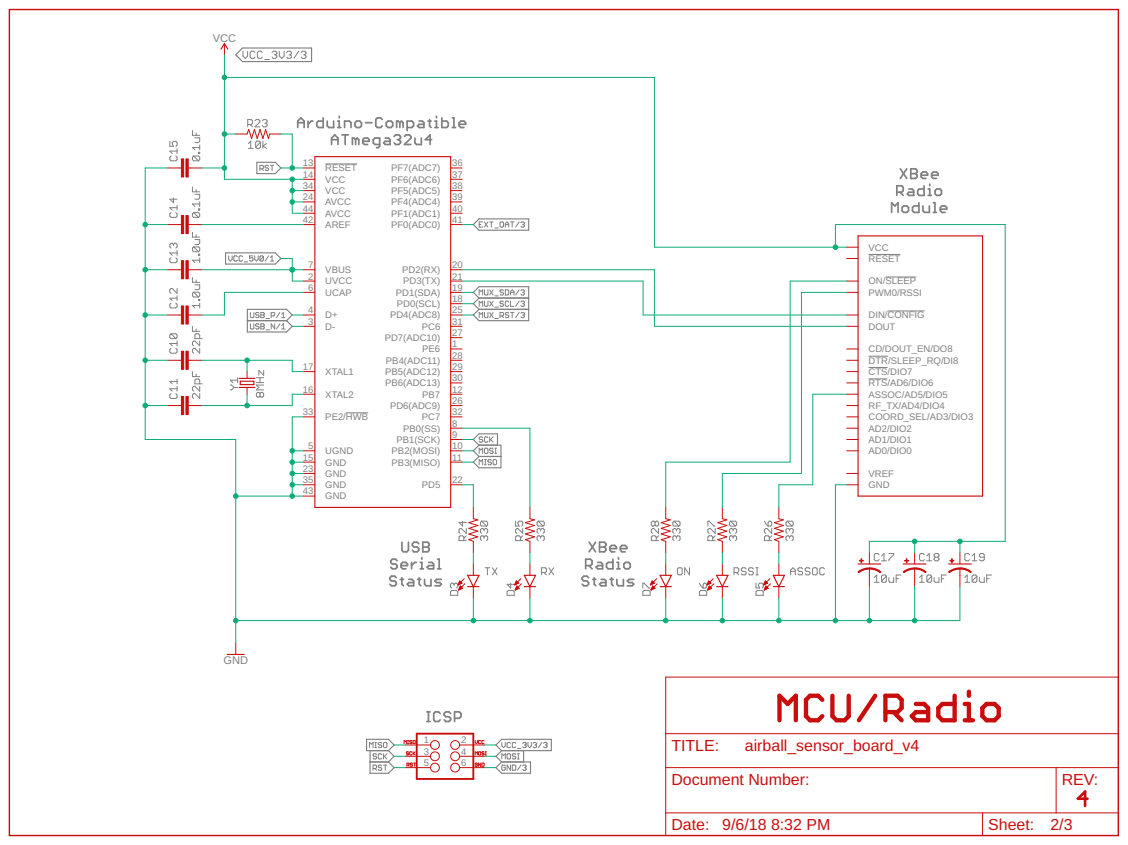
[picture p58: page 2]

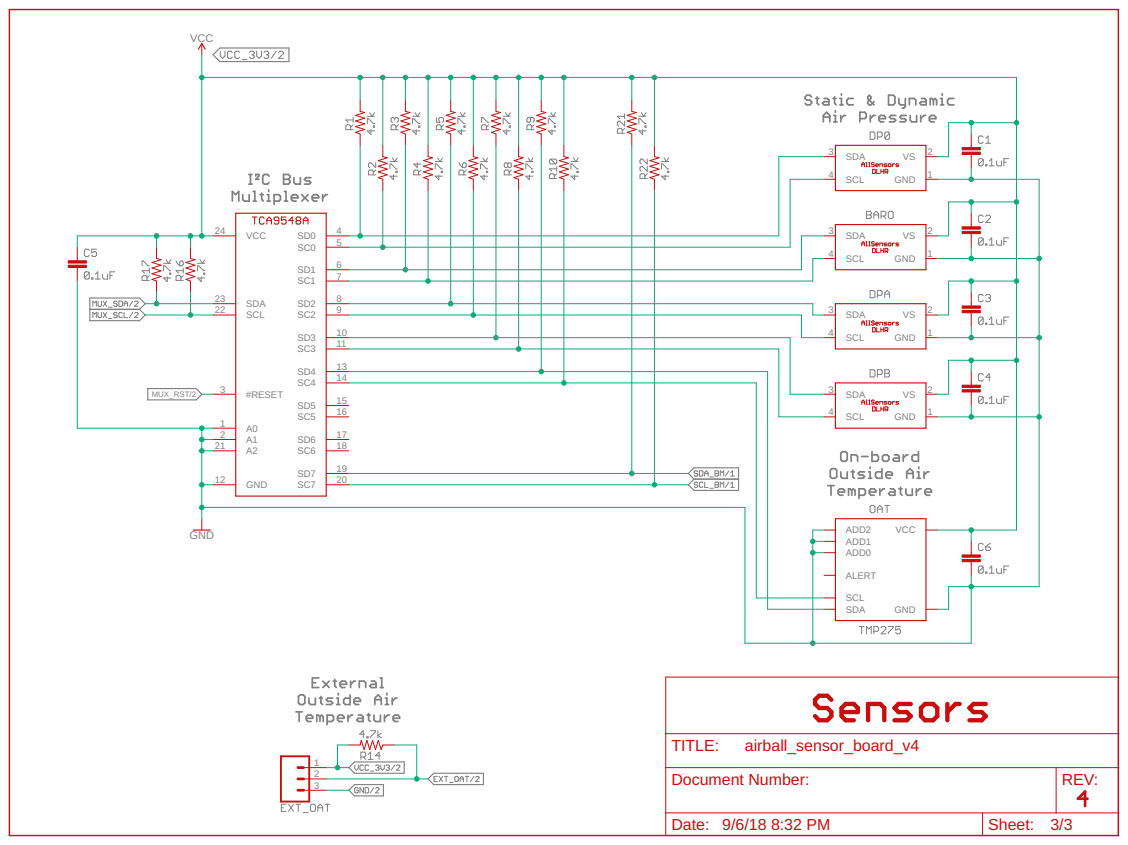
[picture p59: page 3]

Document Number: | REV:

Date: 9/6/18 8:32 PM | Sheet: 3/3
