airball-aero/airball-embedded/hardware/SensorBoard/airball_sensor_board_v4_all.pdf

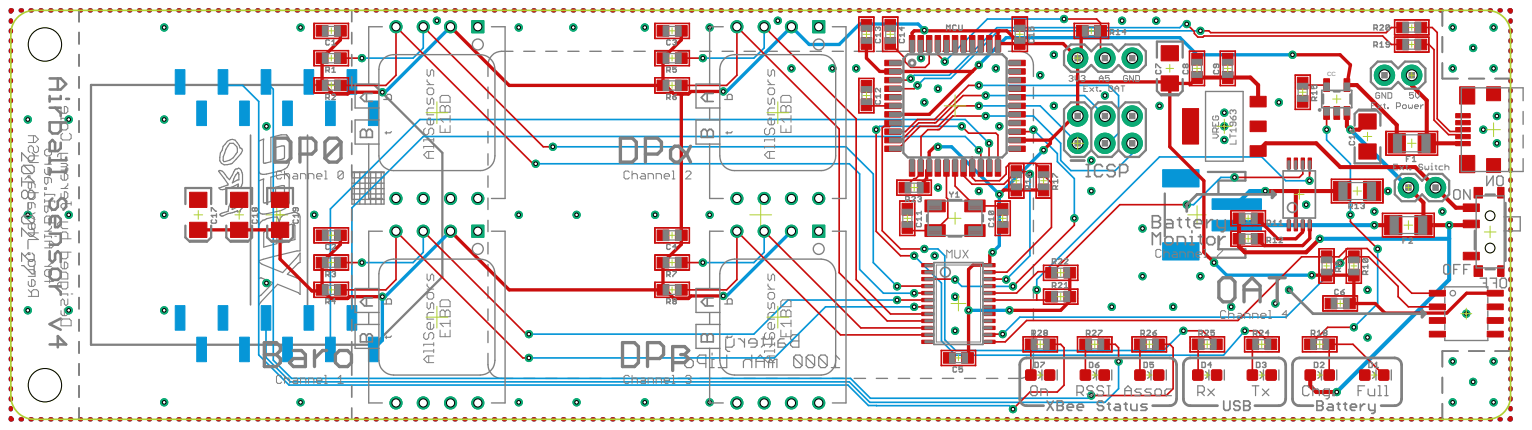
[picture p60: page 1]
