airball-aero/airball-embedded/hardware/SensorBoard/airball_sensor_board_v4_bottom.pdf

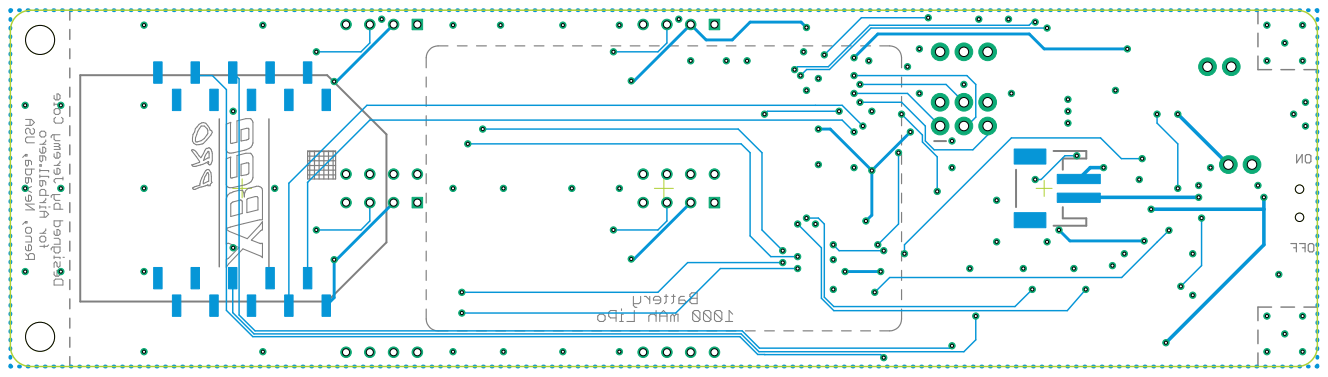
[picture p61: page 1]
