airball-aero/airball-embedded/hardware/SensorBoard/airball_sensor_board_v4_top.pdf

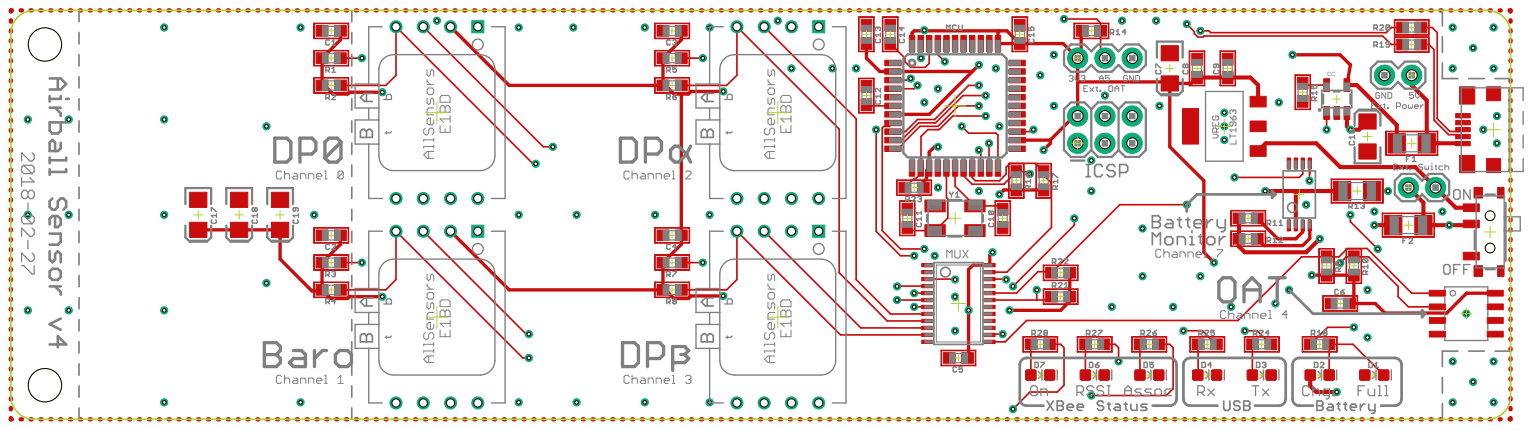
[picture p62: page 1]
