airball-aero/airball-embedded/hardware/SensorBoard/airball_sensor_board_v8_temp.brd

## EAGLE design hardware/SensorBoard/airball_sensor_board_v8_temp.brd (2021-11-21)

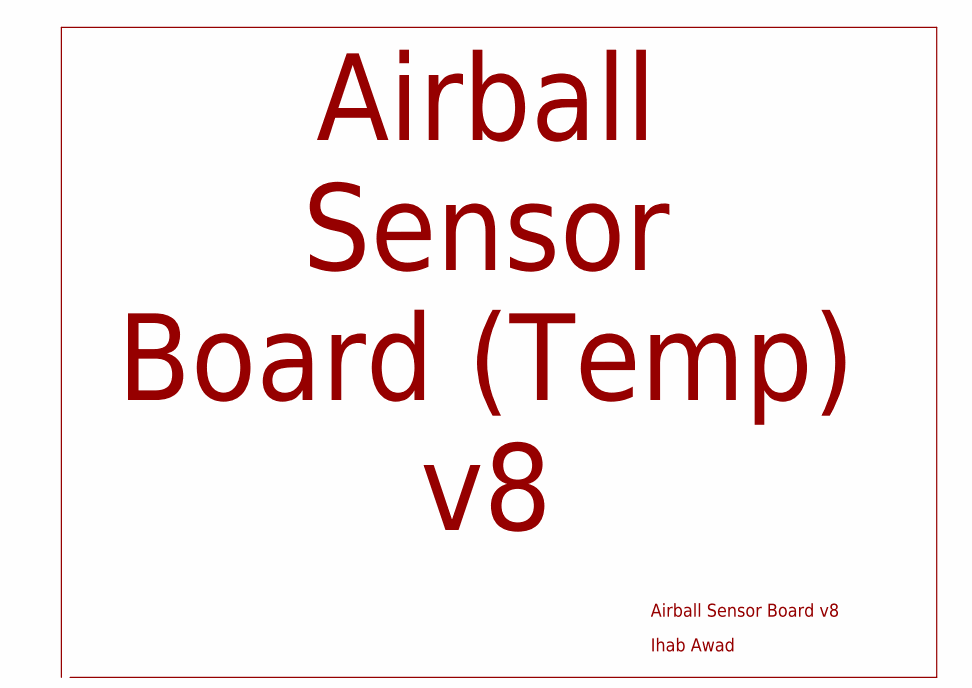
[picture p63: schematic airball_sensor_board_v8_temp.sch, sheet 1]

Notes on the sheet:
Airball Sensor Board v8
Ihab Awad
Airball Sensor Board (Temp) v8

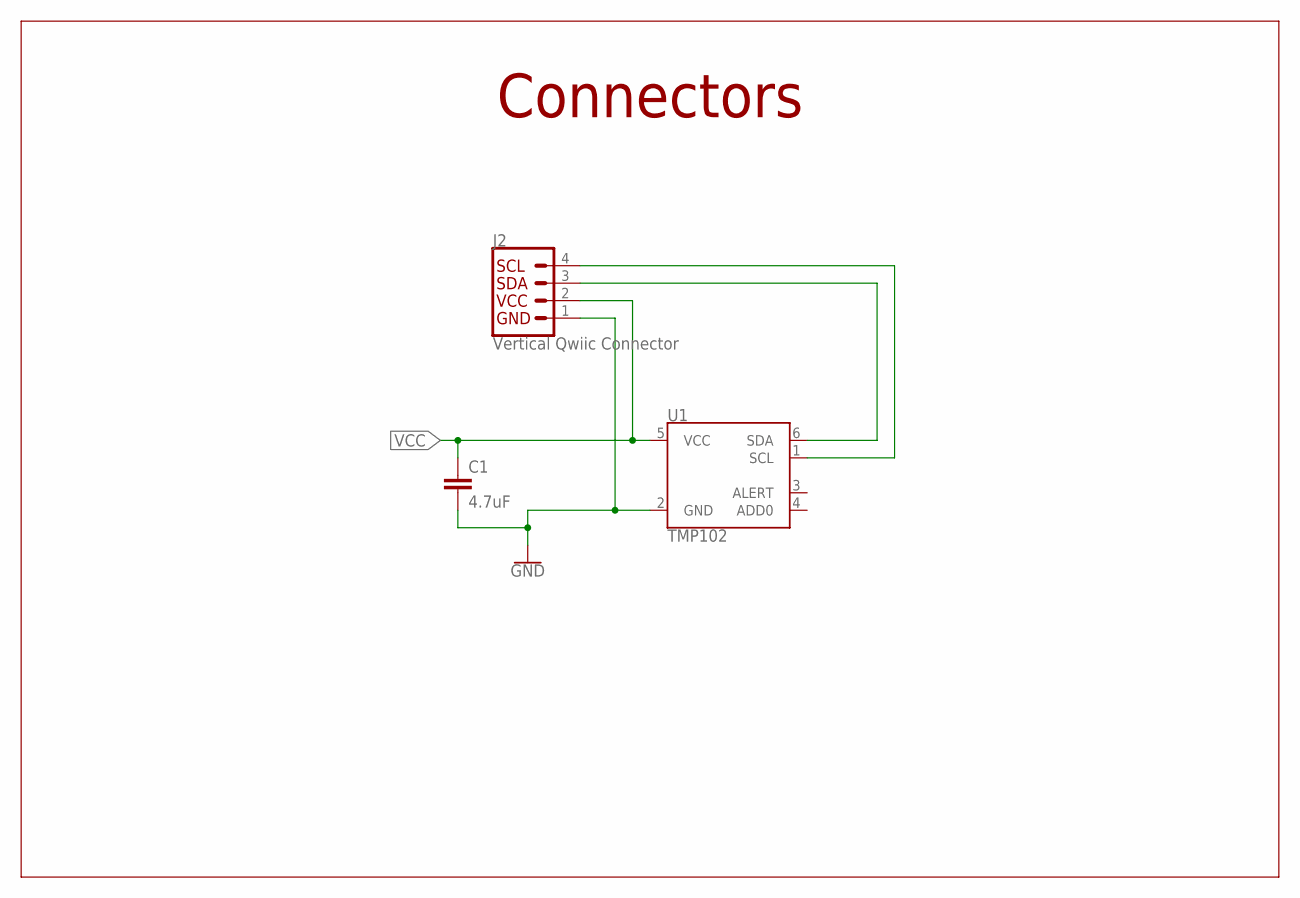
[picture p64: schematic airball_sensor_board_v8_temp.sch, sheet 2]

Parts:
C1: 4.7uF; 0603
J2: Vertical Qwiic Connector; JST04_1MM_VERT
U1: TMP102; SOT563

Connections:
GND: C1.2, J2.1, U1.2 (GND)
SCL: J2.4, U1.1 (SCL)
SDA: J2.3, U1.6 (SDA)
VCC: C1.1, J2.2, U1.5 (VCC)

Notes on the sheet:
Connectors

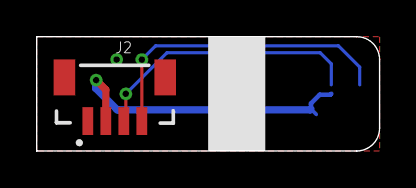
[picture p65: board airball_sensor_board_v8_temp.brd from above]

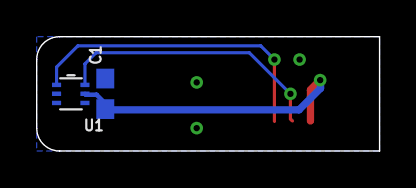
[picture p66: board airball_sensor_board_v8_temp.brd from below]

Board: 2 copper layers, 19.1 x 6.3 mm, 3 parts (2 on the bottom side), 4 nets.
