airball-aero/airball-embedded/hardware/SensorBoard/airball_sensor_board_v8.brd

## EAGLE design hardware/SensorBoard/airball_sensor_board_v8.brd (2021-11-21)

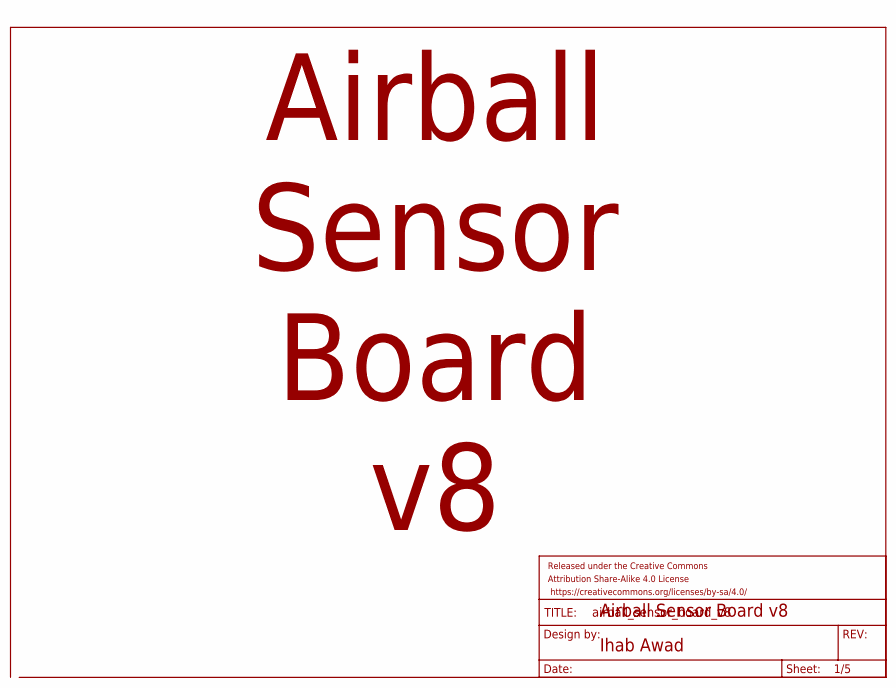
[picture p67: schematic airball_sensor_board_v8.sch, sheet 1]

Parts:
FRAME1: FRAME-LETTER; CREATIVE_COMMONS

Notes on the sheet:
Airball Sensor Board v8
Ihab Awad
Airball Sensor Board v8

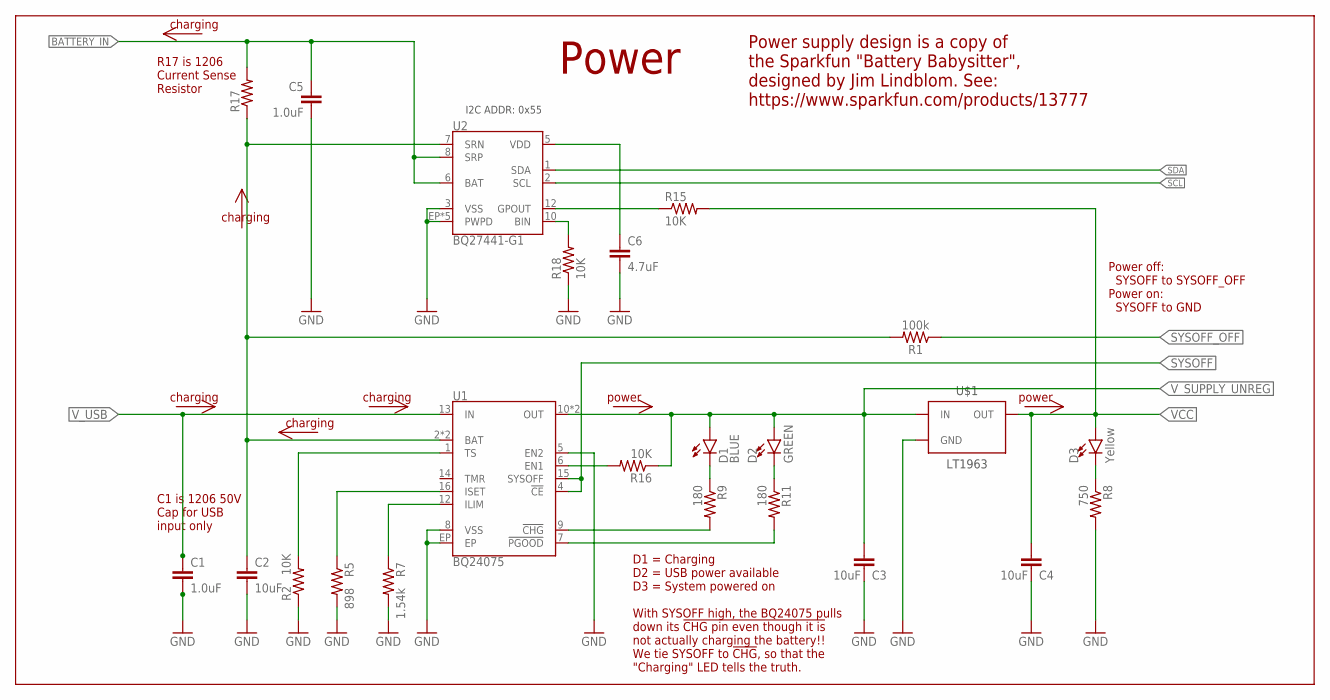
[picture p68: schematic airball_sensor_board_v8.sch, sheet 2]

Parts:
C1: 1.0uF; 1206-CAP
C2, C3, C4: 10uF; 0805-CAP
C5: 1.0uF; 0603-CAP
C6: 4.7uF; 0603
D1: BLUE; LED-0603
D2: GREEN; LED-0603
D3: Yellow; LED-0603
R1: 100k; 0603
R2, R15, R16, R18: 10K; 0603-RES
R5: 898; 0603-RES
R7: 1.54k; 0603-RES
R8: 750; 0603-RES
R9, R11: 180; 0603-RES
R17: 1206
U1: BQ24075; PVQFN-N16
U2: BQ27441-G1; PDSO-N12
U$1: LT1963; SOT223-3

Connections:
!CHG!: R9.2, U1.9 (!CHG!)
BATTERY_IN: C5.1, R17.2, U2.6 (BAT), U2.8 (SRP); also elsewhere on the board
GND: C1.2, C2.2, C3.2, C4.2, C5.2, C6.2, R2.1, R5.2, R7.2, R8.2, R18.1, U1.5 (EN2), U1.8 (VSS), U1.EP, U2.3 (VSS), U2.EP (PWPD), U2.EP1 (PWPD), U2.EP2 (PWPD), U2.EP3 (PWPD), U2.EP4 (PWPD), U$1.2 (GND), U$1.TAB (GND); also elsewhere on the board
GPOUT: R15.1, U2.12 (GPOUT)
ILIM: R7.1, U1.12 (ILIM)
ISET: R5.1, U1.16 (ISET)
unnamed: R16.2, U1.6 (EN1)
unnamed: D1.C, R9.1
unnamed: C6.1, U2.5 (VDD)
unnamed: R11.2, U1.7 (!PGOOD!)
unnamed: D2.C, R11.1
unnamed: D3.C, R8.1
unnamed: R18.2, U2.10 (BIN)
SCL: U2.2 (SCL); also elsewhere on the board
SDA: U2.1 (SDA); also elsewhere on the board
SYSOFF: U1.4 (!CE!), U1.15 (SYSOFF); also elsewhere on the board
SYSOFF_OFF: R1.1; also elsewhere on the board
TS: R2.2, U1.1 (TS)
VCC: C4.1, D3.A, R15.2, U$1.3 (OUT); also elsewhere on the board
V_BATT: C2.1, R1.2, R17.1, U1.2 (BAT), U1.3 (BAT), U2.7 (SRN)
V_SUPPLY_UNREG: C3.1, D1.A, D2.A, R16.1, U1.10 (OUT), U1.11 (OUT), U$1.1 (IN); also elsewhere on the board
V_USB: C1.1, U1.13 (IN); also elsewhere on the board

Notes on the sheet:
I2C ADDR: 0x55
Power
Power supply design is a copy of the Sparkfun "Battery Babysitter", designed by Jim Lindblom. See: https://www.sparkfun.com/products/13777
R17 is 1206 Current Sense Resistor
D1 = Charging D2 = USB power available D3 = System powered on With SYSOFF high, the BQ24075 pulls down its !CHG pin even though it is not actually charging the battery!! We tie SYSOFF to !CHG, so that the "Charging" LED tells the truth.
charging
power
C1 is 1206 50V Cap for USB input only
Power off: SYSOFF to SYSOFF_OFF Power on: SYSOFF to GND

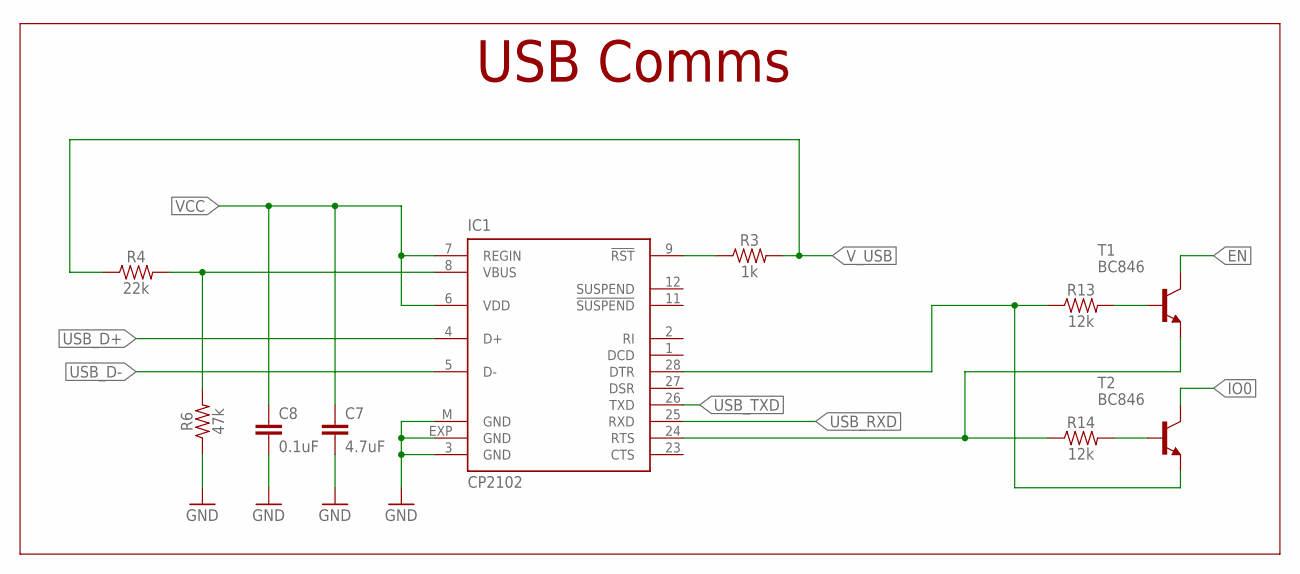
[picture p69: schematic airball_sensor_board_v8.sch, sheet 3]

Parts:
C7: 4.7uF; 0603
C8: 0.1uF; 0603
IC1: CP2102; MLP28
R3: 1k; 0603
R4: 22k; 0603
R6: 47k; 0603
R13, R14: 12k; 0603
T1, T2: BC846; SOT23

Connections:
EN: T1.3 (C); also elsewhere on the board
GND: C7.2, C8.2, IC1.3 (GND), IC1.EXP (GND), IC1.M (GND), R6.1; also elsewhere on the board
IO0: T2.3 (C); also elsewhere on the board
unnamed: IC1.9 (!RST), R3.1
unnamed: IC1.8 (VBUS), R4.2, R6.2
unnamed: R13.2, T1.1 (B)
unnamed: R14.2, T2.1 (B)
USB_D+: IC1.4 (D+); also elsewhere on the board
USB_D-: IC1.5 (D-); also elsewhere on the board
USB_DTR: IC1.28 (DTR), R13.1, T2.2 (E)
USB_RTS: IC1.24 (RTS), R14.1, T1.2 (E)
USB_RXD: IC1.25 (RXD); also elsewhere on the board
USB_TXD: IC1.26 (TXD); also elsewhere on the board
VCC: C7.1, C8.1, IC1.6 (VDD), IC1.7 (REGIN); also elsewhere on the board
V_USB: R3.2, R4.1; also elsewhere on the board

Notes on the sheet:
USB Comms

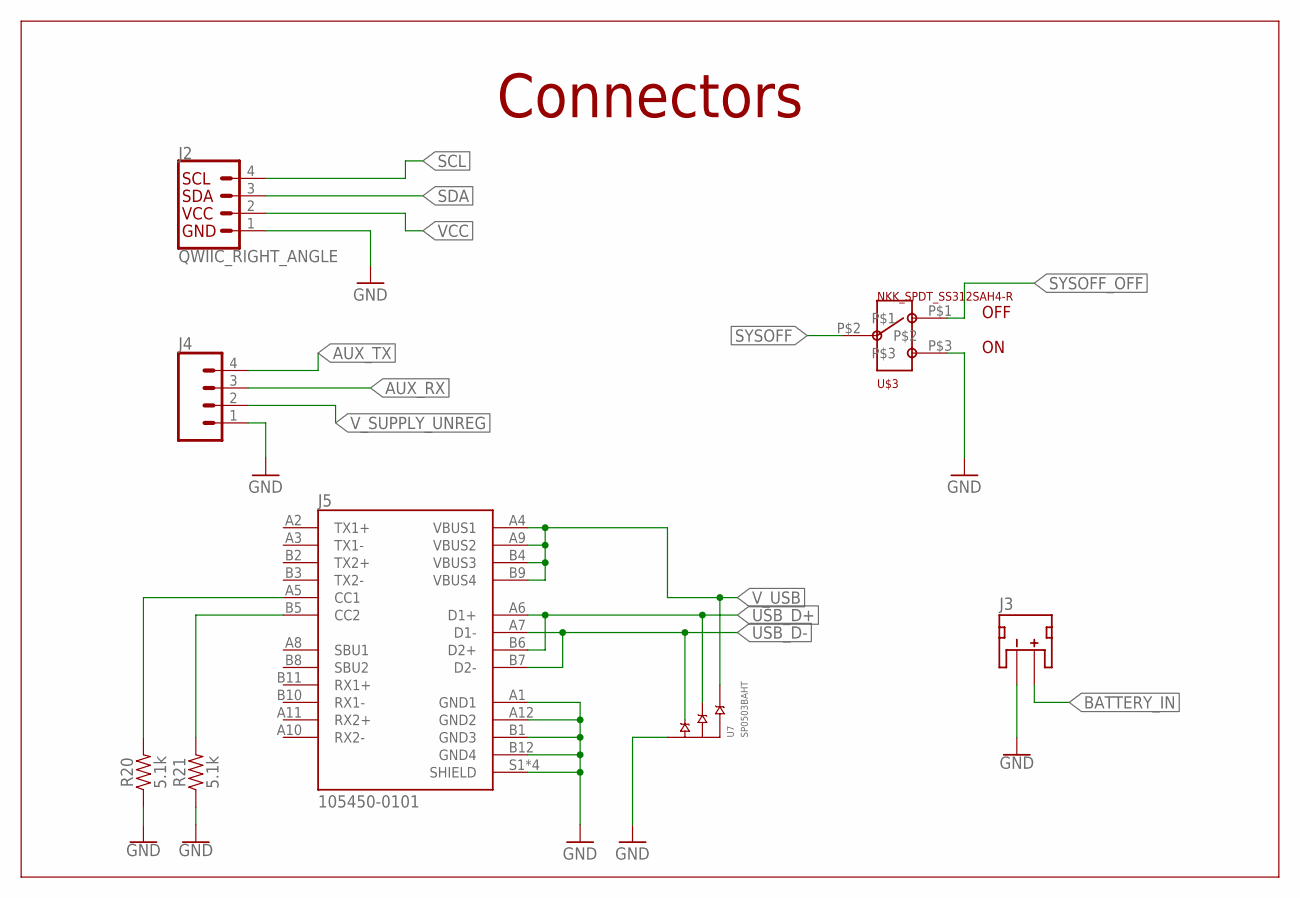
[picture p70: schematic airball_sensor_board_v8.sch, sheet 4]

Parts:
J2: QWIIC_RIGHT_ANGLE; JST04_1MM_RA
J3: JST_2MM_MALE; JST-2-SMD
J4: CONN_04PTH; 1X04
J5: 105450-0101; MOLEX_105450-0101
R20, R21: 5.1k; 0603
U7: SP0503BAHT; SOT143
U$3: NKK_SPDT_SS312SAH4-R

Connections:
AUX_RX: J4.3; also elsewhere on the board
AUX_TX: J4.4; also elsewhere on the board
BATTERY_IN: J3.2 (+); also elsewhere on the board
GND: J2.1, J3.1 (-), J4.1, J5.A1 (GND1), J5.A12 (GND2), J5.B1 (GND3), J5.B12 (GND4), J5.S1 (SHIELD), J5.S2 (SHIELD), J5.S3 (SHIELD), J5.S4 (SHIELD), R20.1, R21.1, U7.1 (GND), U$3.P$3; also elsewhere on the board
SCL: J2.4; also elsewhere on the board
SDA: J2.3; also elsewhere on the board
SYSOFF: U$3.P$2; also elsewhere on the board
SYSOFF_OFF: U$3.P$1; also elsewhere on the board
USB_CC1: J5.A5 (CC1), R20.2
USB_CC2: J5.B5 (CC2), R21.2
USB_D+: J5.A6 (D1+), J5.B6 (D2+), U7.3 (B); also elsewhere on the board
USB_D-: J5.A7 (D1-), J5.B7 (D2-), U7.2 (A); also elsewhere on the board
VCC: J2.2; also elsewhere on the board
V_SUPPLY_UNREG: J4.2; also elsewhere on the board
V_USB: J5.A4 (VBUS1), J5.A9 (VBUS2), J5.B4 (VBUS3), J5.B9 (VBUS4), U7.4 (C); also elsewhere on the board

Notes on the sheet:
Connectors
OFF

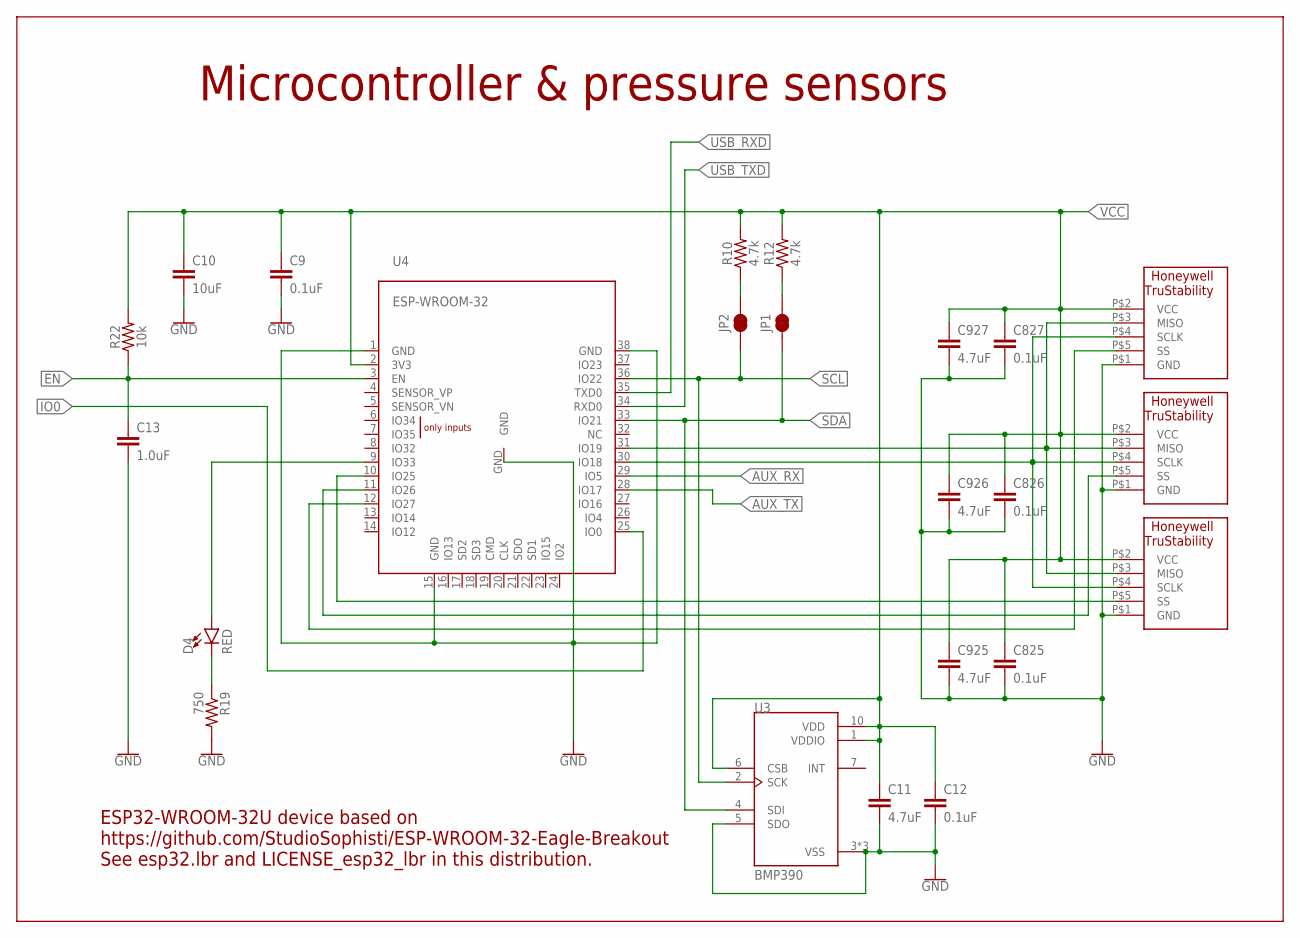
[picture p71: schematic airball_sensor_board_v8.sch, sheet 5]

Parts:
C9, C12, C825, C826, C827: 0.1uF; 0603
C10: 10uF; 0603
C11, C925, C926, C927: 4.7uF; 0603
C13: 1.0uF; 0603
D4: RED; LED-0603
JP1, JP2: JUMPER-SMT_2_NC_TRACE_SILK; SMT-JUMPER_2_NC_TRACE_SILK
R10, R12: 4.7k; 0603
R19: 750; 0603-RES
R22: 10k; 0603
U3: BMP390; PQFN50P200X200X80-10N
U4: ESP-WROOM-32
U$925, U$926, U$927: HONEYWELL_HSC_SMT

Connections:
AUX_RX: U4.29 (IO5); also elsewhere on the board
AUX_TX: U4.28 (IO17); also elsewhere on the board
EN: C13.1, R22.1, U4.3 (EN); also elsewhere on the board
GND: C9.2, C10.2, C11.2, C12.2, C13.2, C825.2, C826.2, C827.2, C925.2, C926.2, C927.2, R19.2, U3.3 (VSS), U3.5 (SDO), U3.8 (VSS), U3.9 (VSS), U4.1 (GND), U4.15 (GND), U4.38 (GND), U4.GND, U$925.P$1 (GND), U$926.P$1 (GND), U$927.P$1 (GND); also elsewhere on the board
IO0: U4.25 (IO0); also elsewhere on the board
MISO: U4.31 (IO19), U$925.P$3 (MISO), U$926.P$3 (MISO), U$927.P$3 (MISO)
unnamed: D4.A, U4.9 (IO33)
unnamed: D4.C, R19.1
unnamed: JP2.2, R10.1
unnamed: JP1.2, R12.1
SCL: JP2.1, U3.2 (SCK), U4.36 (IO22); also elsewhere on the board
SCLK: U4.30 (IO18), U$925.P$4 (SCLK), U$926.P$4 (SCLK), U$927.P$4 (SCLK)
SDA: JP1.1, U3.4 (SDI), U4.33 (IO21); also elsewhere on the board
SS_25: U4.10 (IO25), U$925.P$5 (SS)
SS_26: U4.11 (IO26), U$926.P$5 (SS)
SS_27: U4.12 (IO27), U$927.P$5 (SS)
USB_RXD: U4.35 (TXD0); also elsewhere on the board
USB_TXD: U4.34 (RXD0); also elsewhere on the board
VCC: C9.1, C10.1, C11.1, C12.1, C825.1, C826.1, C827.1, C925.1, C926.1, C927.1, R10.2, R12.2, R22.2, U3.1 (VDDIO), U3.6 (CSB), U3.10 (VDD), U4.2 (3V3), U$925.P$2 (VCC), U$926.P$2 (VCC), U$927.P$2 (VCC); also elsewhere on the board

Notes on the sheet:
Microcontroller & pressure sensors
ESP32-WROOM-32U device based on https://github.com/StudioSophisti/ESP-WROOM-32-Eagle-Breakout See esp32.lbr and LICENSE_esp32_lbr in this distribution.

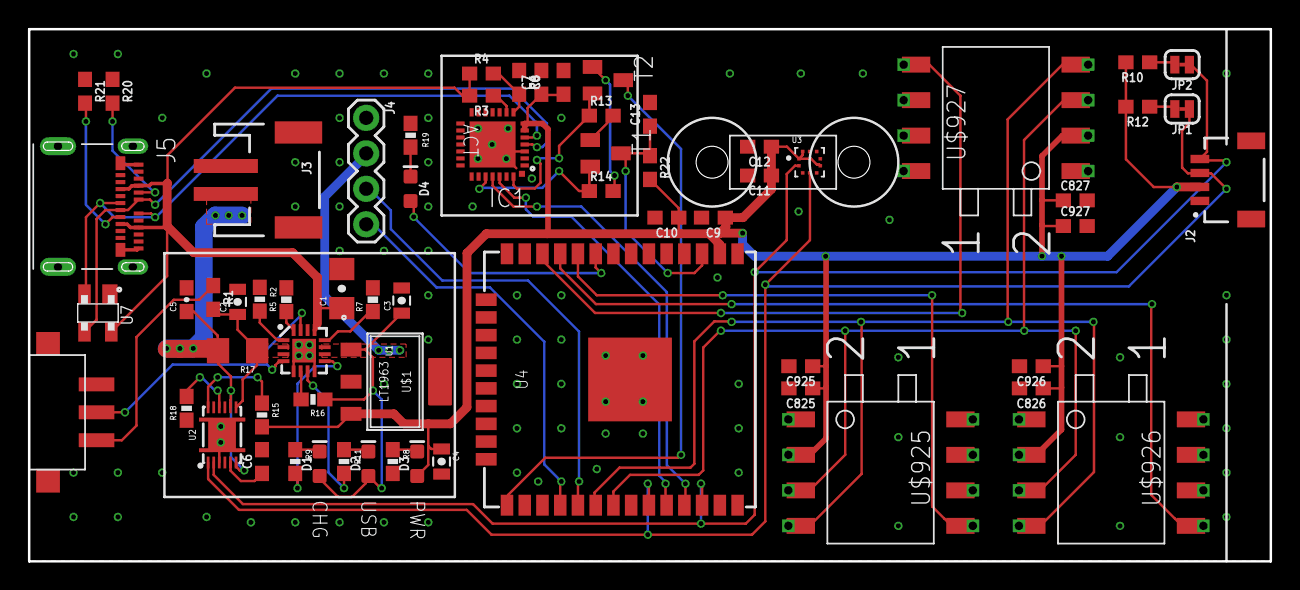
[picture p72: board airball_sensor_board_v8.brd from above]

Board: 2 copper layers, 88.9 x 38.1 mm, 65 parts (0 on the bottom side), 47 nets.
