airball-aero/airball-embedded/hardware/DisplayBoard/airball_display_board_v2.brd

## EAGLE design hardware/DisplayBoard/airball_display_board_v2.brd (2021-01-03)

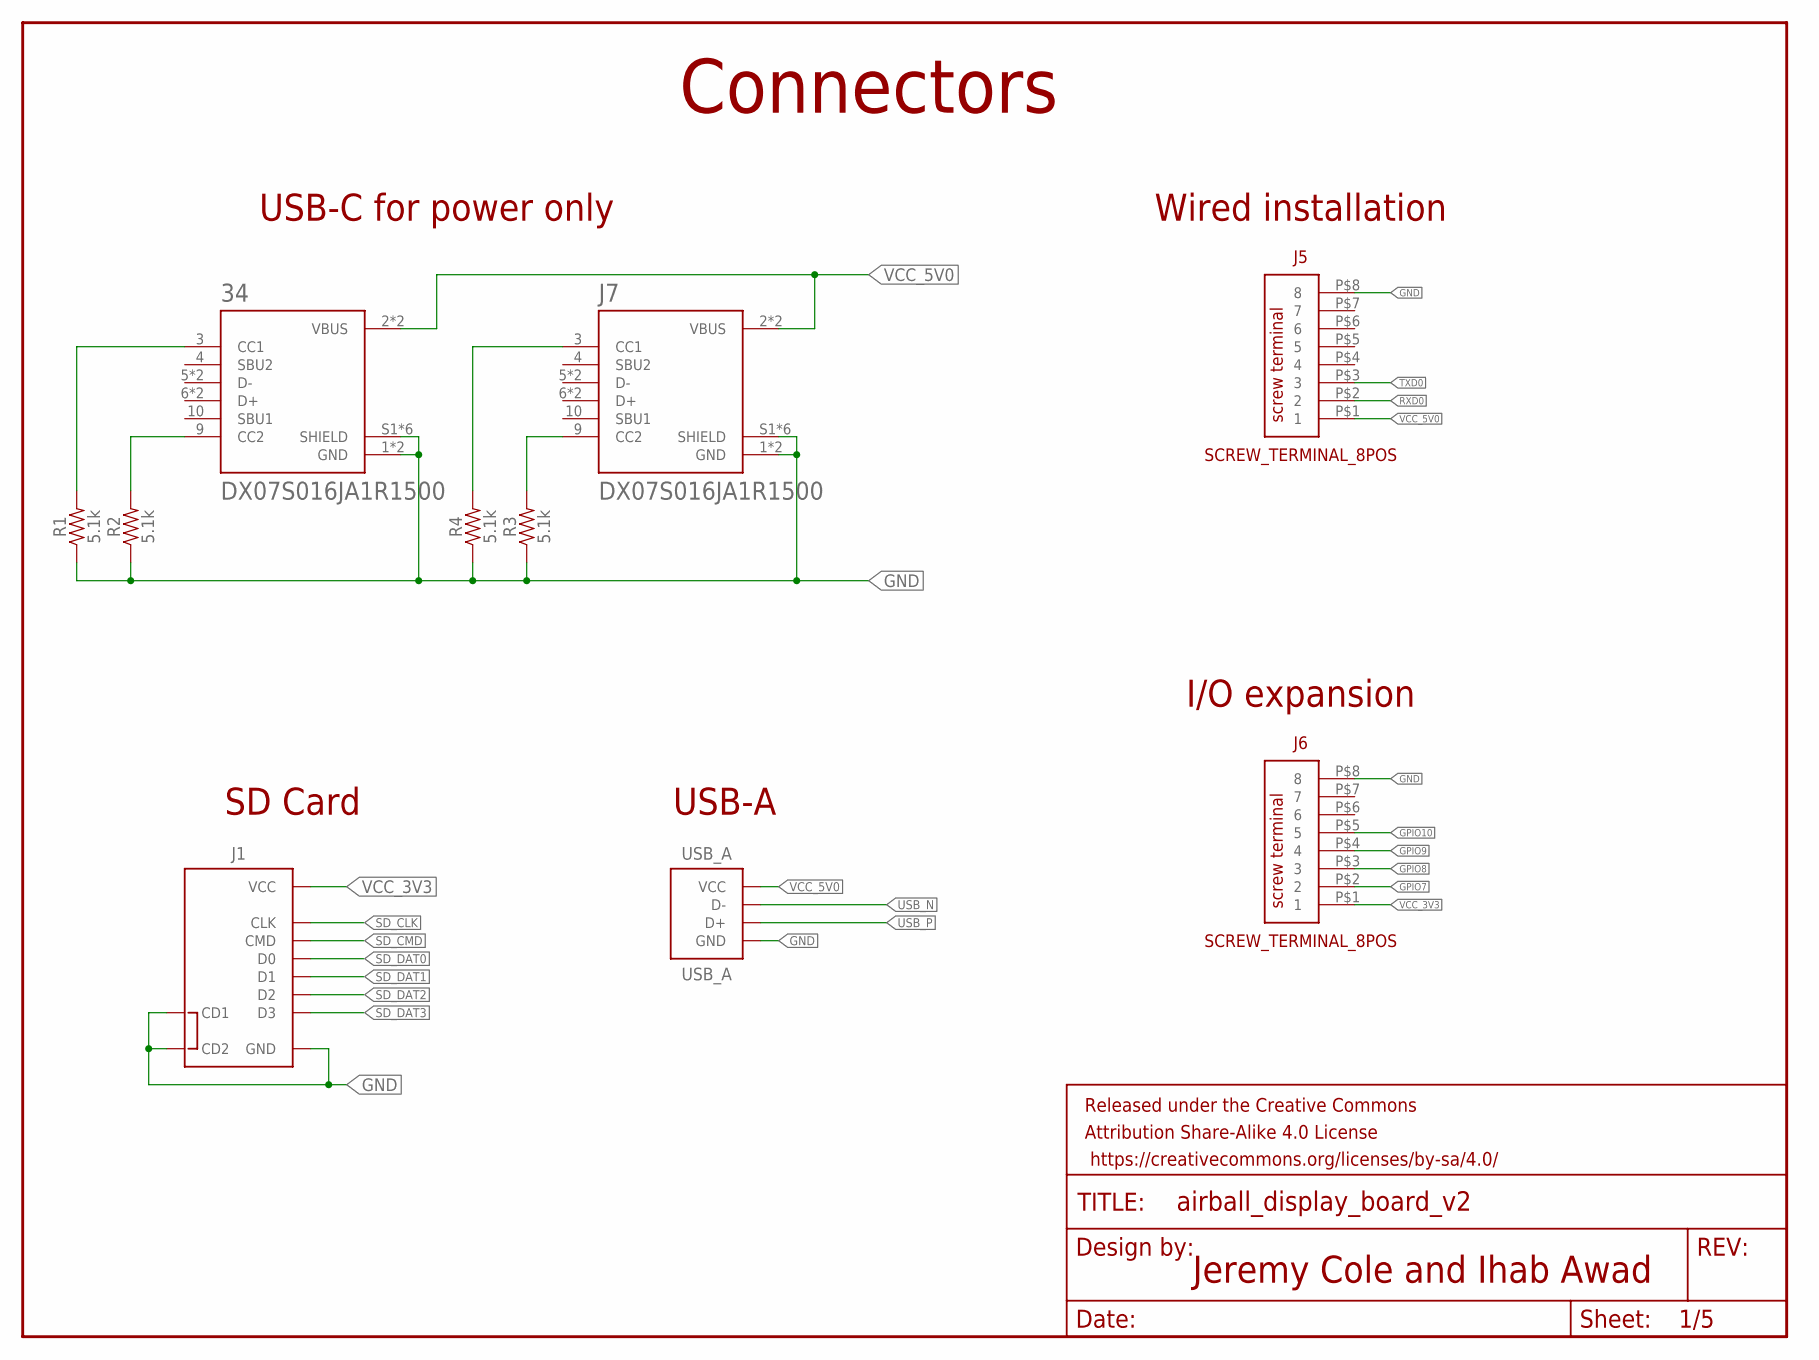
[picture p73: schematic airball_display_board_v2.sch, sheet 1]

Parts:
34: DX07S016JA1R1500; JAE_DX07S016JA1R1500
FRAME1: FRAME-LETTER; CREATIVE_COMMONS
J1: MICRO-SD-SD4-MOLEX_104031; MOLEX_MICRO_SD_104031
J5, J6: SCREW_TERMINAL_8POS
J7: DX07S016JA1R1500; JAE_DX07S016JA1R1500
R1, R2, R3, R4: 5.1k; 0603
USB_A: USB_A; FCI_USB_A_87583

Connections:
GND: 34.1 (GND), 34.12 (GND), 34.S1 (SHIELD), 34.S2 (SHIELD), 34.S3 (SHIELD), 34.S4 (SHIELD), 34.S5 (SHIELD), 34.S6 (SHIELD), J1.6 (GND), J1.CD1, J1.CD2, J1.SH@1 (GND), J1.SH@2 (GND), J1.SH@3 (GND), J1.SH@4 (GND), J5.P$8 (8), J6.P$8 (8), J7.1 (GND), J7.12 (GND), J7.S1 (SHIELD), J7.S2 (SHIELD), J7.S3 (SHIELD), J7.S4 (SHIELD), J7.S5 (SHIELD), J7.S6 (SHIELD), R1.1, R2.1, R3.1, R4.1, USB_A.GND, USB_A.SH@1 (GND), USB_A.SH@2 (GND); also elsewhere on the board
GPIO7: J6.P$2 (2); also elsewhere on the board
GPIO8: J6.P$3 (3); also elsewhere on the board
GPIO9: J6.P$4 (4); also elsewhere on the board
GPIO10: J6.P$5 (5); also elsewhere on the board
unnamed: 34.9 (CC2), R2.2
unnamed: 34.3 (CC1), R1.2
unnamed: J7.9 (CC2), R3.2
unnamed: J7.3 (CC1), R4.2
RXD0: J5.P$2 (2); also elsewhere on the board
SD_CLK: J1.5 (CLK); also elsewhere on the board
SD_CMD: J1.3 (CMD); also elsewhere on the board
SD_DAT0: J1.7 (D0); also elsewhere on the board
SD_DAT1: J1.8 (D1); also elsewhere on the board
SD_DAT2: J1.1 (D2); also elsewhere on the board
SD_DAT3: J1.2 (D3); also elsewhere on the board
TXD0: J5.P$3 (3); also elsewhere on the board
USB_N: USB_A.D-; also elsewhere on the board
USB_P: USB_A.D+; also elsewhere on the board
VCC_3V3: J1.4 (VCC), J6.P$1 (1); also elsewhere on the board
VCC_5V0: 34.2 (VBUS), 34.11 (VBUS), J5.P$1 (1), J7.2 (VBUS), J7.11 (VBUS), USB_A.VBUS (VCC); also elsewhere on the board

Notes on the sheet:
Jeremy Cole and Ihab Awad
Connectors
USB-C for power only
SD Card
USB-A
Wired installation
I/O expansion

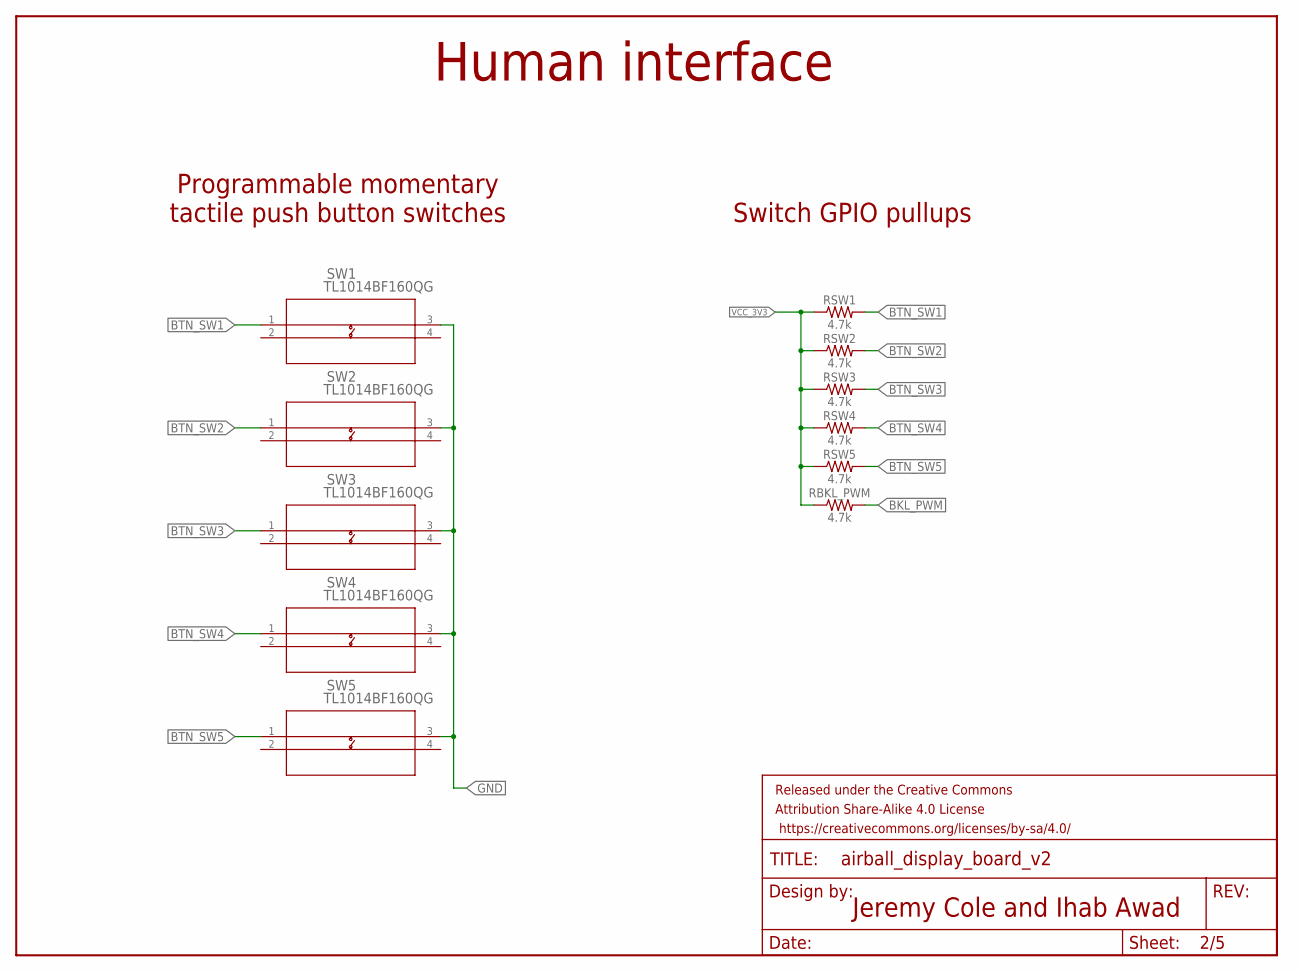
[picture p74: schematic airball_display_board_v2.sch, sheet 2]

Parts:
FRAME4: FRAME-LETTER; CREATIVE_COMMONS
RBKL_PWM: 4.7k; 0603
RSW1, RSW2, RSW3, RSW4, RSW5: 4.7k; 0603
SW1, SW2, SW3, SW4, SW5: TL1014BF160QG; TL1014BF160QG_EWI

Connections:
BKL_PWM: RBKL_PWM.2; also elsewhere on the board
BTN_SW1: RSW1.2, SW1.1; also elsewhere on the board
BTN_SW2: RSW2.2, SW2.1; also elsewhere on the board
BTN_SW3: RSW3.2, SW3.1; also elsewhere on the board
BTN_SW4: RSW4.2, SW4.1; also elsewhere on the board
BTN_SW5: RSW5.2, SW5.1; also elsewhere on the board
GND: SW1.3, SW2.3, SW3.3, SW4.3, SW5.3; also elsewhere on the board
VCC_3V3: RBKL_PWM.1, RSW1.1, RSW2.1, RSW3.1, RSW4.1, RSW5.1; also elsewhere on the board

Notes on the sheet:
Jeremy Cole and Ihab Awad
Human interface
Programmable momentary tactile push button switches
Switch GPIO pullups

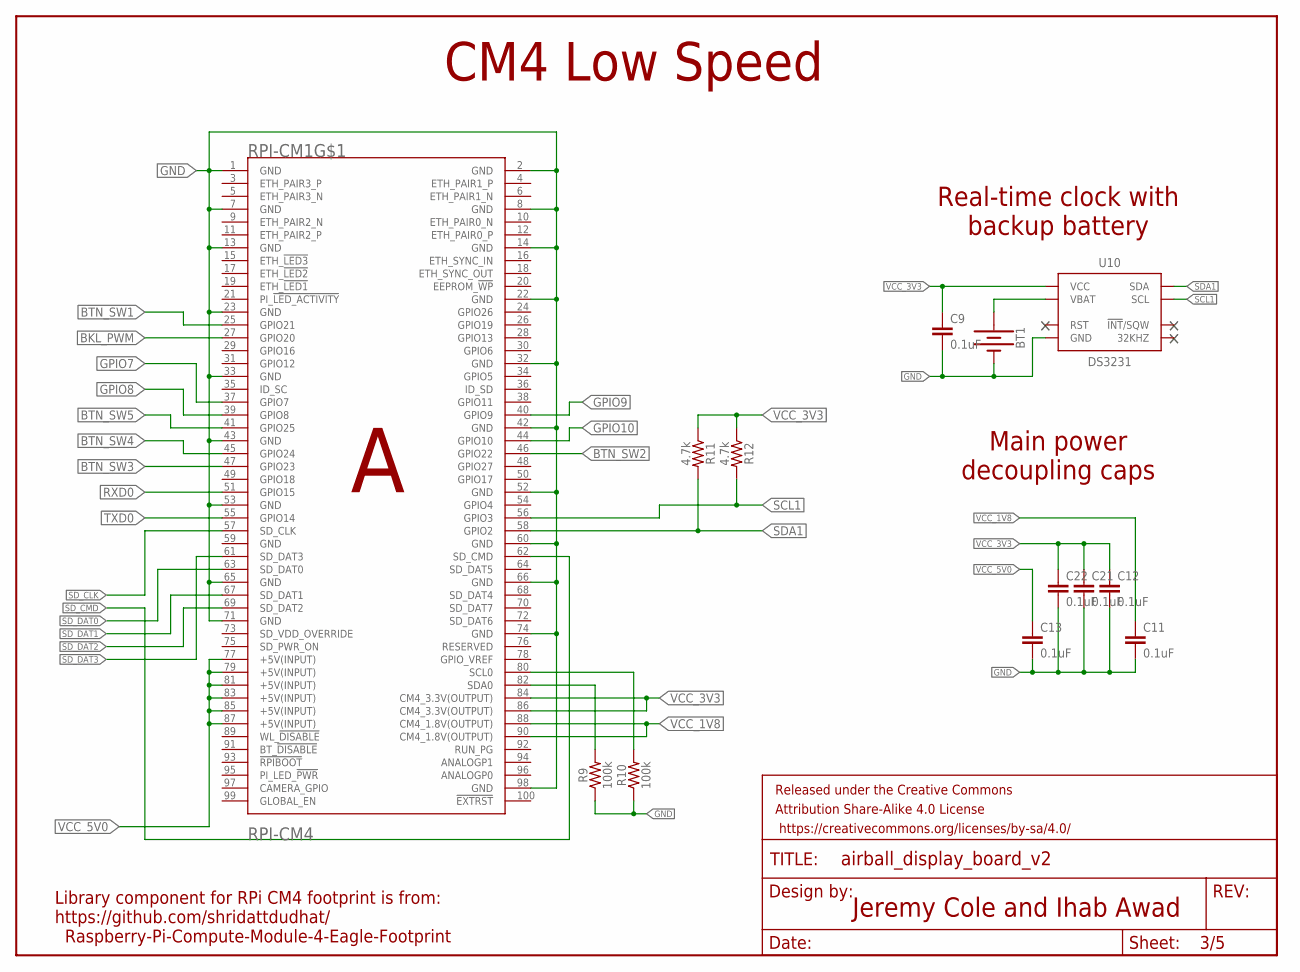
[picture p75: schematic airball_display_board_v2.sch, sheet 3]

Parts:
BT1: BATTERY-12MM_SMD; BATTCON_12MM
C9, C11, C12, C13, C21, C22: 0.1uF; 0603
FRAME2: FRAME-LETTER; CREATIVE_COMMONS
R9, R10: 100k; 0603
R11, R12: 4.7k; 0603
RPI-CM1: RPI-CM4
U10: DS3231; SOIC16W

Connections:
BKL_PWM: RPI-CM1.27 (GPIO20); also elsewhere on the board
BTN_SW1: RPI-CM1.25 (GPIO21); also elsewhere on the board
BTN_SW2: RPI-CM1.46 (GPIO22); also elsewhere on the board
BTN_SW3: RPI-CM1.47 (GPIO23); also elsewhere on the board
BTN_SW4: RPI-CM1.45 (GPIO24); also elsewhere on the board
BTN_SW5: RPI-CM1.41 (GPIO25); also elsewhere on the board
GND: BT1.GND (-), C9.2, C11.2, C12.2, C13.2, C21.2, C22.2, R9.1, R10.1, RPI-CM1.1 (GND), RPI-CM1.2 (GND), RPI-CM1.7 (GND), RPI-CM1.8 (GND), RPI-CM1.13 (GND), RPI-CM1.14 (GND), RPI-CM1.22 (GND), RPI-CM1.23 (GND), RPI-CM1.32 (GND), RPI-CM1.33 (GND), RPI-CM1.42 (GND), RPI-CM1.43 (GND), RPI-CM1.52 (GND), RPI-CM1.53 (GND), RPI-CM1.60 (GND), RPI-CM1.65 (GND), RPI-CM1.66 (GND), RPI-CM1.71 (GND), RPI-CM1.74 (GND), RPI-CM1.98 (GND), U10.5 (GND), U10.6 (GND), U10.7 (GND), U10.8 (GND), U10.9 (GND), U10.10 (GND), U10.11 (GND), U10.12 (GND), U10.13 (GND); also elsewhere on the board
GPIO7: RPI-CM1.37 (GPIO7); also elsewhere on the board
GPIO8: RPI-CM1.39 (GPIO8); also elsewhere on the board
GPIO9: RPI-CM1.40 (GPIO9); also elsewhere on the board
GPIO10: RPI-CM1.44 (GPIO10); also elsewhere on the board
RTC_VBAT: BT1.PWR@1 (+), U10.14 (VBAT)
RXD0: RPI-CM1.51 (GPIO15); also elsewhere on the board
SCL0: R10.2, RPI-CM1.80 (SCL0)
SCL1: R12.2, RPI-CM1.56 (GPIO3), U10.16 (SCL)
SDA0: R9.2, RPI-CM1.82 (SDA0)
SDA1: R11.2, RPI-CM1.58 (GPIO2), U10.15 (SDA)
SD_CLK: RPI-CM1.57 (SD_CLK); also elsewhere on the board
SD_CMD: RPI-CM1.62 (SD_CMD); also elsewhere on the board
SD_DAT0: RPI-CM1.63 (SD_DAT0); also elsewhere on the board
SD_DAT1: RPI-CM1.67 (SD_DAT1); also elsewhere on the board
SD_DAT2: RPI-CM1.69 (SD_DAT2); also elsewhere on the board
SD_DAT3: RPI-CM1.61 (SD_DAT3); also elsewhere on the board
TXD0: RPI-CM1.55 (GPIO14); also elsewhere on the board
VCC_1V8: C11.1, RPI-CM1.88 (CM4_1.8V(OUTPUT)), RPI-CM1.90 (CM4_1.8V(OUTPUT))
VCC_3V3: C9.1, C12.1, C21.1, C22.1, R11.1, R12.1, RPI-CM1.84 (CM4_3.3V(OUTPUT)), RPI-CM1.86 (CM4_3.3V(OUTPUT)), U10.2 (VCC); also elsewhere on the board
VCC_5V0: C13.1, RPI-CM1.77 (+5V(INPUT)), RPI-CM1.79 (+5V(INPUT)), RPI-CM1.81 (+5V(INPUT)), RPI-CM1.83 (+5V(INPUT)), RPI-CM1.85 (+5V(INPUT)), RPI-CM1.87 (+5V(INPUT)); also elsewhere on the board

Notes on the sheet:
Library component for RPi CM4 footprint is from: https://github.com/shridattdudhat/ Raspberry-Pi-Compute-Module-4-Eagle-Footprint
CM4 Low Speed
Jeremy Cole and Ihab Awad
Real-time clock with backup battery
Main power decoupling caps

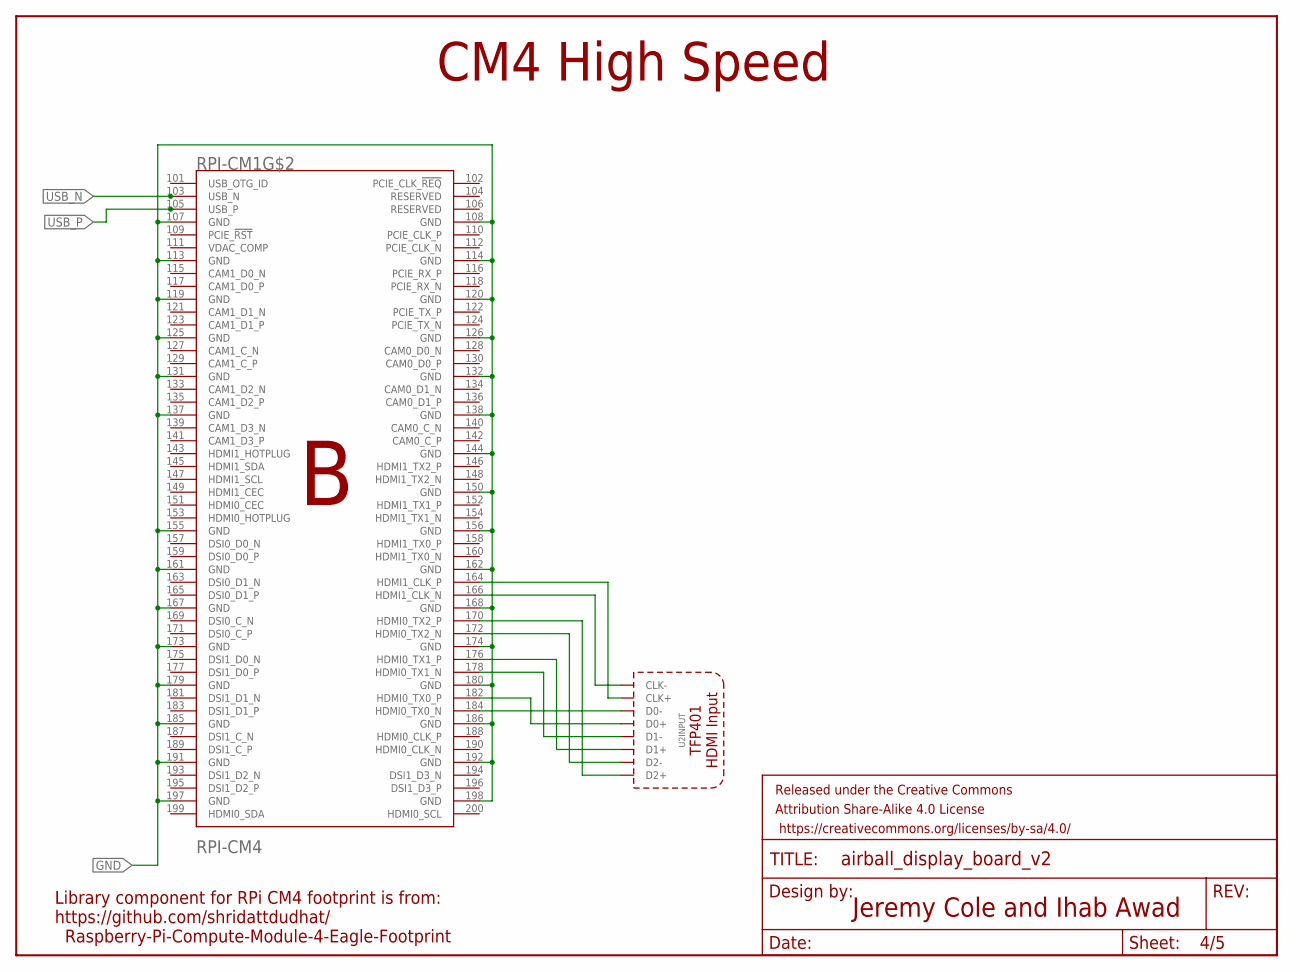
[picture p76: schematic airball_display_board_v2.sch, sheet 4]

Parts:
FRAME3: FRAME-LETTER; CREATIVE_COMMONS
RPI-CM1: RPI-CM4
U2: TFP401A; TQFP100_POWER_LITE

Connections:
GND: RPI-CM1.107 (GND), RPI-CM1.108 (GND), RPI-CM1.113 (GND), RPI-CM1.114 (GND), RPI-CM1.119 (GND), RPI-CM1.120 (GND), RPI-CM1.125 (GND), RPI-CM1.126 (GND), RPI-CM1.131 (GND), RPI-CM1.132 (GND), RPI-CM1.137 (GND), RPI-CM1.138 (GND), RPI-CM1.144 (GND), RPI-CM1.150 (GND), RPI-CM1.155 (GND), RPI-CM1.156 (GND), RPI-CM1.161 (GND), RPI-CM1.162 (GND), RPI-CM1.167 (GND), RPI-CM1.168 (GND), RPI-CM1.173 (GND), RPI-CM1.174 (GND), RPI-CM1.179 (GND), RPI-CM1.180 (GND), RPI-CM1.185 (GND), RPI-CM1.186 (GND), RPI-CM1.191 (GND), RPI-CM1.192 (GND), RPI-CM1.197 (GND), RPI-CM1.198 (GND); also elsewhere on the board
unnamed: RPI-CM1.184 (HDMI0_TX0_N), U2.91 (D0-)
unnamed: RPI-CM1.182 (HDMI0_TX0_P), U2.90 (D0+)
unnamed: RPI-CM1.178 (HDMI0_TX1_N), U2.86 (D1-)
unnamed: RPI-CM1.176 (HDMI0_TX1_P), U2.85 (D1+)
unnamed: RPI-CM1.172 (HDMI0_TX2_N), U2.81 (D2-)
unnamed: RPI-CM1.170 (HDMI0_TX2_P), U2.80 (D2+)
unnamed: RPI-CM1.166 (HDMI1_CLK_N), U2.94 (CLK-)
unnamed: RPI-CM1.164 (HDMI1_CLK_P), U2.93 (CLK+)
USB_N: RPI-CM1.103 (USB_N); also elsewhere on the board
USB_P: RPI-CM1.105 (USB_P); also elsewhere on the board

Notes on the sheet:
Library component for RPi CM4 footprint is from: https://github.com/shridattdudhat/ Raspberry-Pi-Compute-Module-4-Eagle-Footprint
CM4 High Speed
Jeremy Cole and Ihab Awad
