airball-aero/airball-embedded/hardware/DisplayBoard/airball_display_board_v2.brd

## EAGLE design hardware/DisplayBoard/airball_display_board_v2.brd (continued)

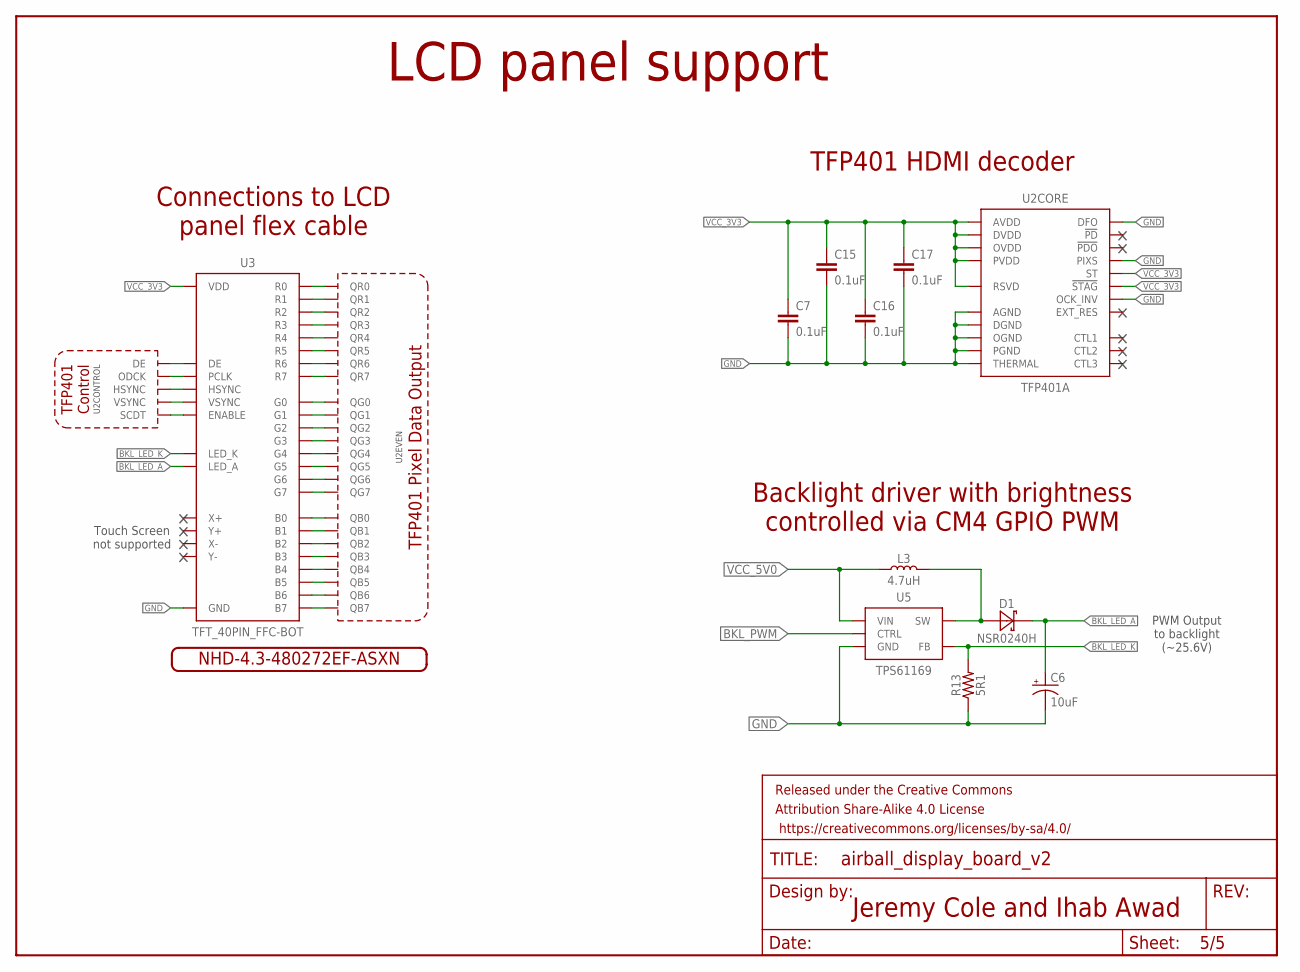
[picture p77: schematic airball_display_board_v2.sch, sheet 5]

Parts:
C6: 10uF; EIA3216
C7, C15, C16, C17: 0.1uF; 0603
D1: NSR0240H; SOD323
FRAME5: FRAME-LETTER; CREATIVE_COMMONS
L3: 4.7uH; INDUCTOR_SMD_4X4MM
R13: 5R1; 0603
U2: TFP401A; TQFP100_POWER_LITE
U3: TFT_40PIN_FFC-BOT; HIROSE_FFC40_FH12-40S-0.5SH
U5: TPS61169; SOT353-5
U$4: NHD-4.3-480272EF-ASXN

Connections:
B0: U2.10 (QB0), U3.21 (B0)
B1: U2.11 (QB1), U3.22 (B1)
B2: U2.12 (QB2), U3.23 (B2)
B3: U2.13 (QB3), U3.24 (B3)
B4: U2.14 (QB4), U3.25 (B4)
B5: U2.15 (QB5), U3.26 (B5)
B6: U2.16 (QB6), U3.27 (B6)
B7: U2.17 (QB7), U3.28 (B7)
BKL_LED_A: C6.+, D1.K (C), U3.2 (LED_A)
BKL_LED_K: R13.2, U3.1 (LED_K), U5.3 (FB)
BKL_PWM: U5.4 (CTRL); also elsewhere on the board
DE: U2.46 (DE), U3.34 (DE)
G0: U2.20 (QG0), U3.13 (G0)
G1: U2.21 (QG1), U3.14 (G1)
G2: U2.22 (QG2), U3.15 (G2)
G3: U2.23 (QG3), U3.16 (G3)
G4: U2.24 (QG4), U3.17 (G4)
G5: U2.25 (QG5), U3.18 (G5)
G6: U2.26 (QG6), U3.19 (G6)
G7: U2.27 (QG7), U3.20 (G7)
GND: C6.-, C7.2, C15.2, C16.2, C17.2, R13.1, U2.1 (DFO), U2.4 (PIXS), U2.5 (DGND), U2.19 (OGND), U2.28 (OGND), U2.39 (DGND), U2.45 (OGND), U2.58 (OGND), U2.68 (DGND), U2.76 (OGND), U2.79 (AGND), U2.83 (AGND), U2.87 (AGND), U2.89 (AGND), U2.92 (AGND), U2.98 (PGND), U2.100 (OCK_INV), U2.TH21 (THERMAL), U2.TH22 (THERMAL), U2.TH23 (THERMAL), U2.TH24 (THERMAL), U2.TH25 (THERMAL), U2.TH30 (THERMAL), U2.TH34 (THERMAL), U2.TH39 (THERMAL), U2.TH43 (THERMAL), U2.TH48 (THERMAL), U2.TH52 (THERMAL), U2.TH57 (THERMAL), U2.TH58 (THERMAL), U2.TH59 (THERMAL), U2.TH60 (THERMAL), U2.TH61 (THERMAL), U2.THA (THERMAL), U2.THB (THERMAL), U3.3 (GND), U3.29 (GND), U3.36 (GND), U5.2 (GND); also elsewhere on the board
HSYNC: U2.48 (HSYNC), U3.32 (HSYNC)
L_BKL: D1.A, L3.2, U5.1 (SW)
PCLK: U2.44 (ODCK), U3.30 (PCLK)
R0: U2.30 (QR0), U3.5 (R0)
R1: U2.31 (QR1), U3.6 (R1)
R2: U2.32 (QR2), U3.7 (R2)
R3: U2.33 (QR3), U3.8 (R3)
R4: U2.34 (QR4), U3.9 (R4)
R5: U2.35 (QR5), U3.10 (R5)
R6: U2.36 (QR6), U3.11 (R6)
R7: U2.37 (QR7), U3.12 (R7)
SCDT: U2.8 (SCDT), U3.31 (ENABLE)
VCC_3V3: C7.1, C15.1, C16.1, C17.1, U2.3 (ST), U2.6 (DVDD), U2.7 (!STAG), U2.18 (OVDD), U2.29 (OVDD), U2.38 (DVDD), U2.43 (OVDD), U2.57 (OVDD), U2.67 (DVDD), U2.78 (OVDD), U2.82 (AVDD), U2.84 (AVDD), U2.88 (AVDD), U2.95 (AVDD), U2.97 (PVDD), U2.99 (RSVD), U3.4 (VDD); also elsewhere on the board
VCC_5V0: L3.1, U5.5 (VIN); also elsewhere on the board
VSYNC: U2.47 (VSYNC), U3.33 (VSYNC)

Notes on the sheet:
Jeremy Cole and Ihab Awad
Touch Screen not supported
PWM Output to backlight (~25.6V)
LCD panel support
Connections to LCD panel flex cable
Backlight driver with brightness controlled via CM4 GPIO PWM
TFP401 HDMI decoder

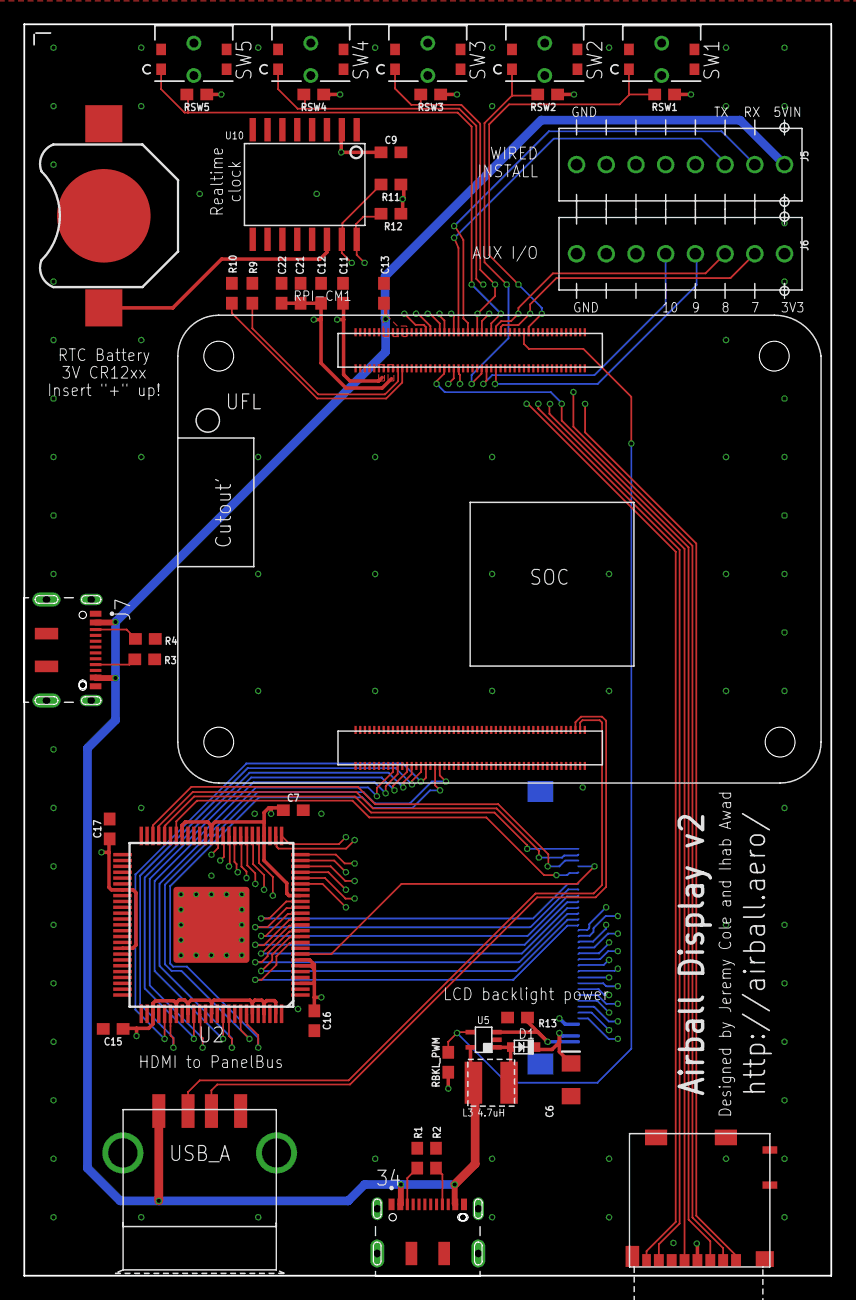
[picture p78: board airball_display_board_v2.brd from above]

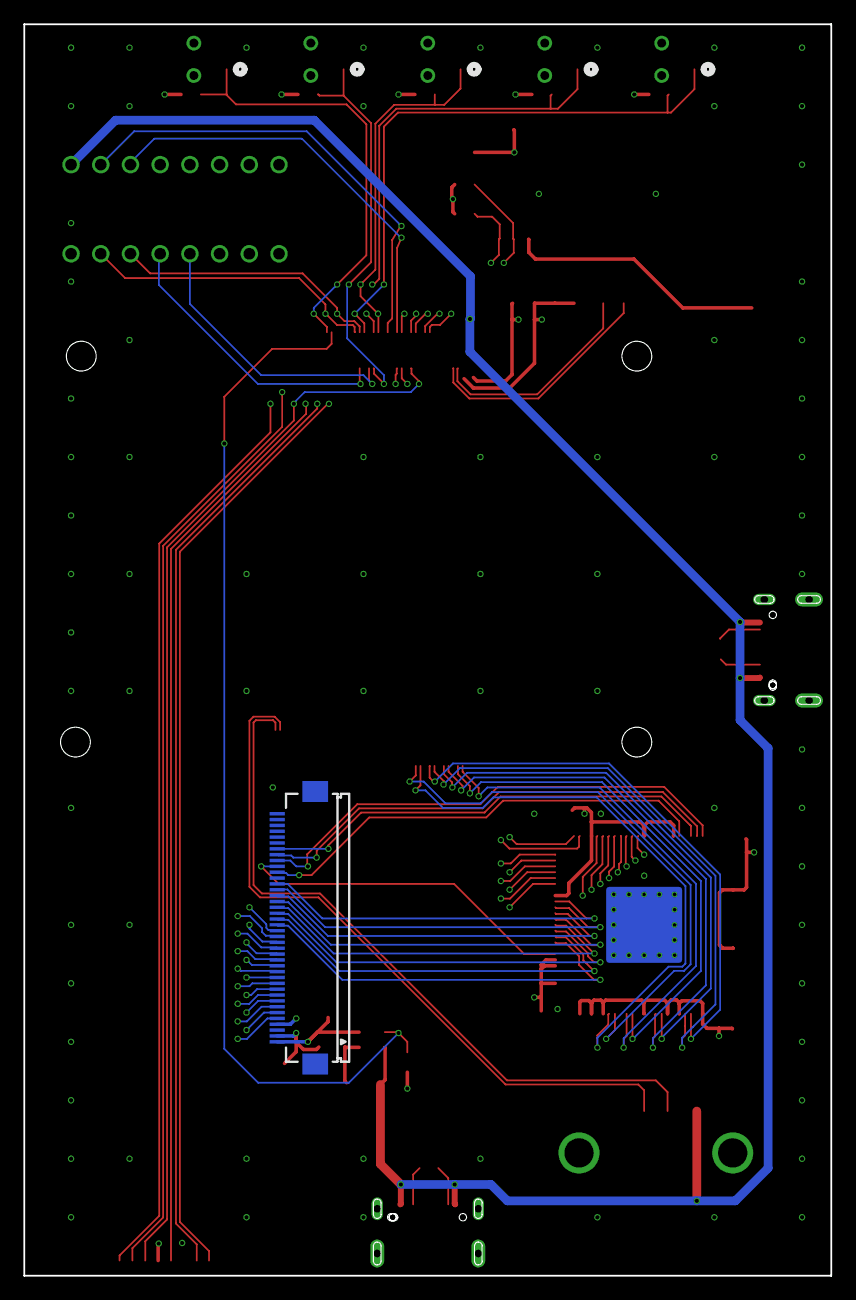
[picture p79: board airball_display_board_v2.brd from below]

Board: 4 copper layers, 69.0 x 107.0 mm, 51 parts (2 on the bottom side), 73 nets.
