airball-aero/airball-embedded/hardware/SensorBoard/airball_sensor_board_v7.brd

## EAGLE design hardware/SensorBoard/airball_sensor_board_v7.brd (2020-02-26, an earlier design)

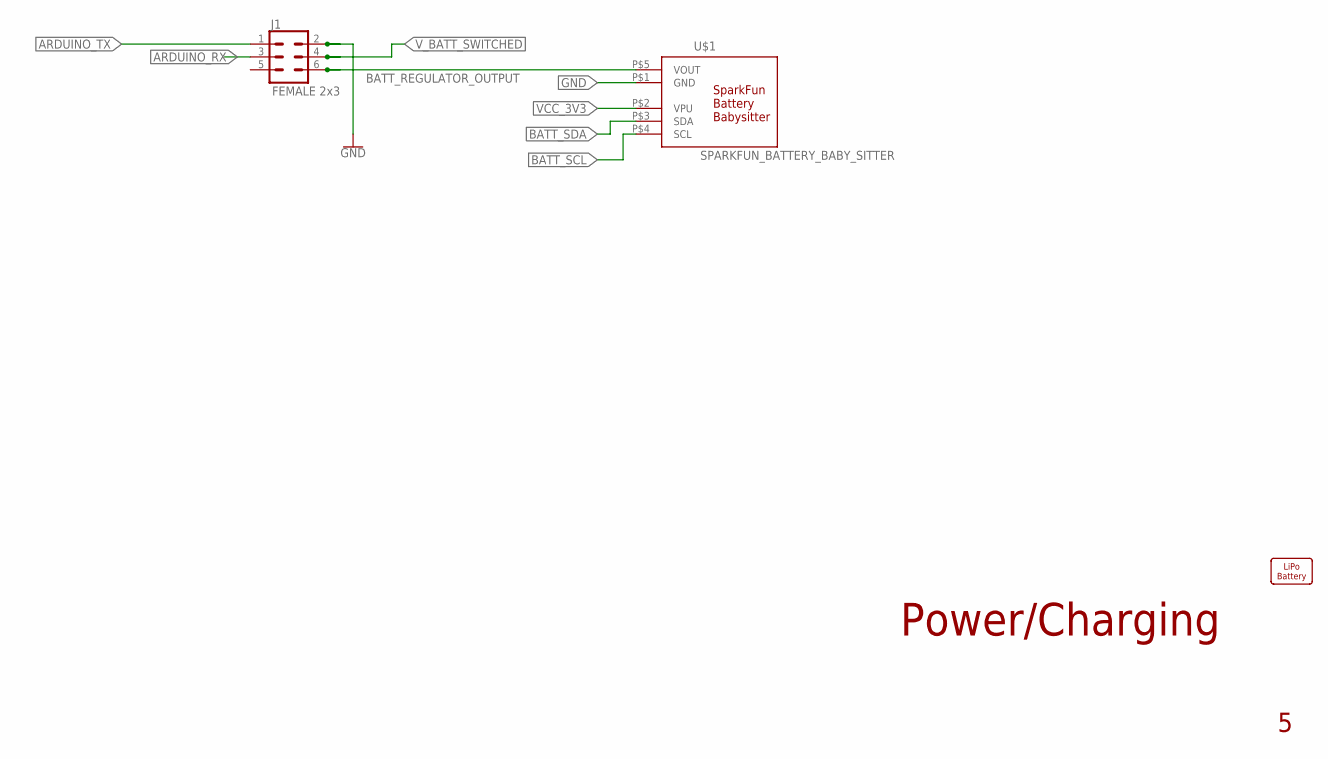
[picture p80: schematic airball_sensor_board_v7.sch, sheet 1]

Parts:
J1: FEMALE 2x3; 2X3
U$1: SPARKFUN_BATTERY_BABY_SITTER
U$3: LIPO_BATTERY_OUTLINE-1000MAH; SPARKFUN_LIPO_1000MAH

Connections:
ARDUINO_RX: J1.3; also elsewhere on the board
ARDUINO_TX: J1.1; also elsewhere on the board
BATT_REGULATOR_OUTPUT: J1.6, U$1.P$5 (VOUT)
BATT_SCL: U$1.P$4 (SCL); also elsewhere on the board
BATT_SDA: U$1.P$3 (SDA); also elsewhere on the board
GND: J1.2, U$1.P$1 (GND); also elsewhere on the board
VCC_3V3: U$1.P$2 (VPU); also elsewhere on the board
V_BATT_SWITCHED: J1.4; also elsewhere on the board

Notes on the sheet:
Power/Charging

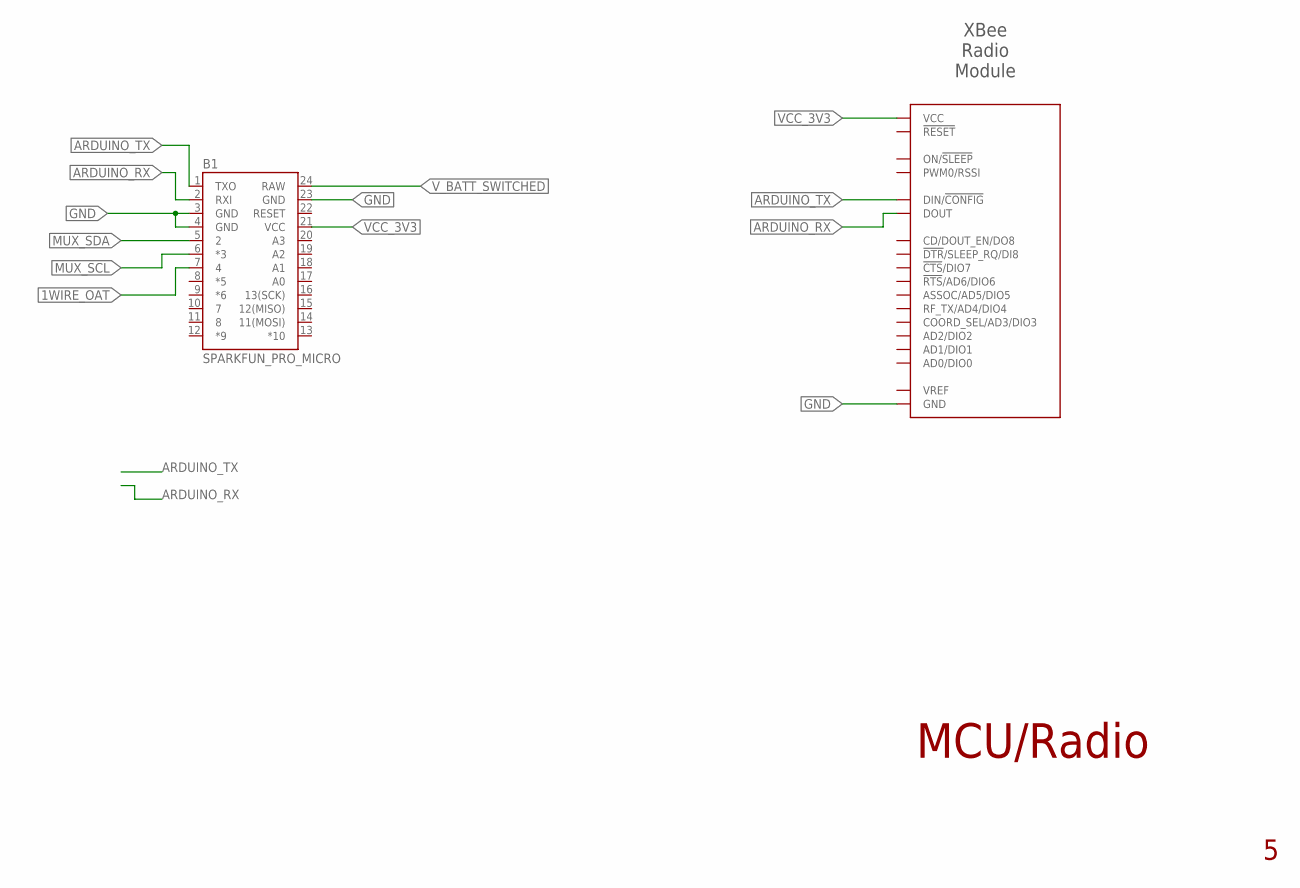
[picture p81: schematic airball_sensor_board_v7.sch, sheet 2]

Parts:
B1: SPARKFUN_PRO_MICRO
XBEE: XBEE-PRO-SMD

Connections:
1WIRE_OAT: B1.7 (4); also elsewhere on the board
ARDUINO_RX: B1.2 (RXI), XBEE.2 (DOUT); also elsewhere on the board
ARDUINO_TX: B1.1 (TXO), XBEE.3 (DIN/!CONFIG); also elsewhere on the board
GND: B1.3 (GND), B1.4 (GND), B1.23 (GND), XBEE.10 (GND); also elsewhere on the board
MUX_SCL: B1.6 (*3); also elsewhere on the board
MUX_SDA: B1.5 (2); also elsewhere on the board
VCC_3V3: B1.21 (VCC), XBEE.1 (VCC); also elsewhere on the board
V_BATT_SWITCHED: B1.24 (RAW); also elsewhere on the board

Notes on the sheet:
XBee Radio Module
MCU/Radio

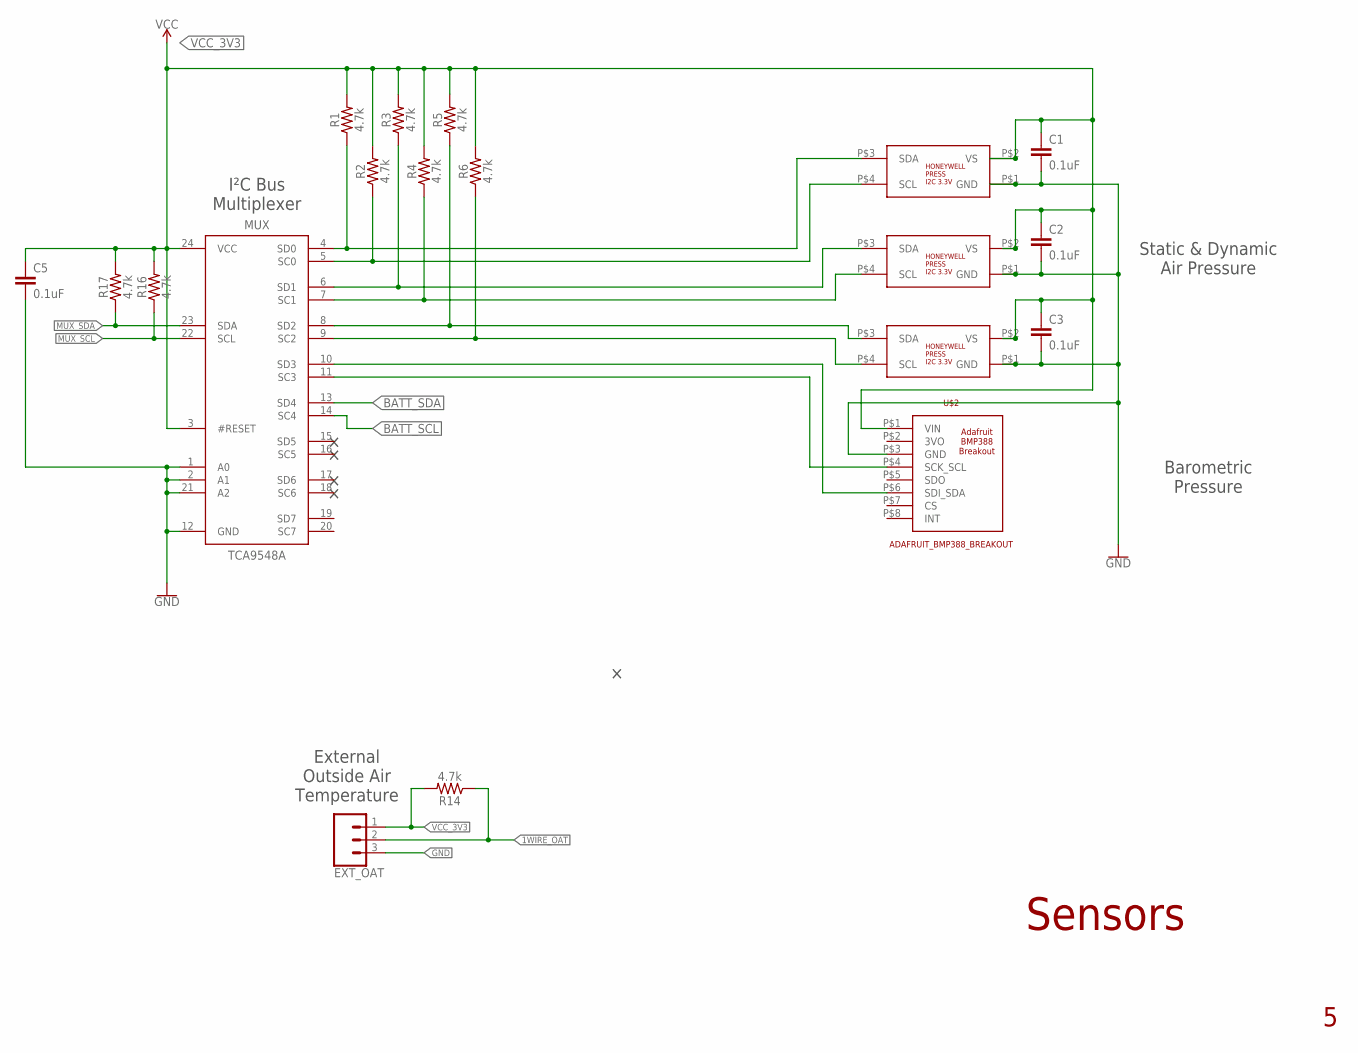
[picture p82: schematic airball_sensor_board_v7.sch, sheet 3]

Parts:
C1, C2, C3, C5: 0.1uF; 0603
DP0: HONEYWELL_TRUSTABILITY_I2C_3.3V; HONEYWELL_TRUSTABILITY_DIP_RR
DPA: HONEYWELL_TRUSTABILITY_I2C_3.3V; HONEYWELL_TRUSTABILITY_DIP_RR
DPB: HONEYWELL_TRUSTABILITY_I2C_3.3V; HONEYWELL_TRUSTABILITY_DIP_RR
EXT_OAT: CONN_03; 1X03
MUX: TCA9548A; TSSOP24
R1, R2, R3, R4, R5, R6, R14, R16, R17: 4.7k; 0603
U$2: ADAFRUIT_BMP388_BREAKOUT

Connections:
1WIRE_OAT: EXT_OAT.2, R14.1; also elsewhere on the board
BATT_SCL: MUX.14 (SC4); also elsewhere on the board
BATT_SDA: MUX.13 (SD4); also elsewhere on the board
GND: C1.2, C2.2, C3.2, C5.2, DP0.P$1 (GND), DPA.P$1 (GND), DPB.P$1 (GND), EXT_OAT.3, MUX.1 (A0), MUX.2 (A1), MUX.12 (GND), MUX.21 (A2), U$2.P$3 (GND); also elsewhere on the board
MUX_SCL: MUX.22 (SCL), R16.1; also elsewhere on the board
MUX_SDA: MUX.23 (SDA), R17.1; also elsewhere on the board
SCL_BMP_BARO: MUX.11 (SC3), U$2.P$4 (SCK_SCL)
SCL_DP0: DP0.P$4 (SCL), MUX.5 (SC0), R2.1
SCL_DPA: DPA.P$4 (SCL), MUX.7 (SC1), R4.1
SCL_DPB: DPB.P$4 (SCL), MUX.9 (SC2), R6.1
SDA_BMP_BARO: MUX.10 (SD3), U$2.P$6 (SDI_SDA)
SDA_DP0: DP0.P$3 (SDA), MUX.4 (SD0), R1.1
SDA_DPA: DPA.P$3 (SDA), MUX.6 (SD1), R3.1
SDA_DPB: DPB.P$3 (SDA), MUX.8 (SD2), R5.1
VCC_3V3: C1.1, C2.1, C3.1, C5.1, DP0.P$2 (VS), DPA.P$2 (VS), DPB.P$2 (VS), EXT_OAT.1, MUX.3 (#RESET), MUX.24 (VCC), R1.2, R2.2, R3.2, R4.2, R5.2, R6.2, R14.2, R16.2, R17.2, U$2.P$1 (VIN); also elsewhere on the board

Notes on the sheet:
Sensors
I²C Bus Multiplexer
Static & Dynamic Air Pressure
External Outside Air Temperature
Barometric Pressure

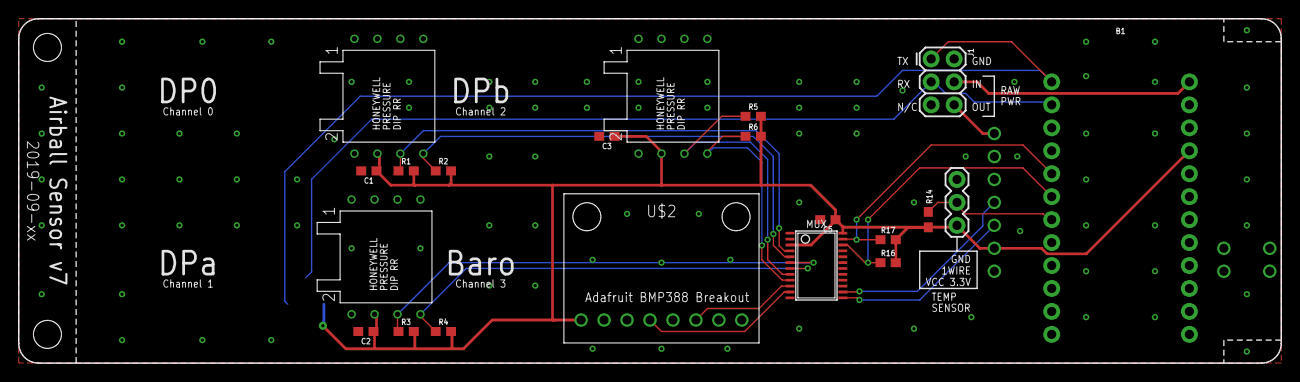
[picture p83: board airball_sensor_board_v7.brd from above]

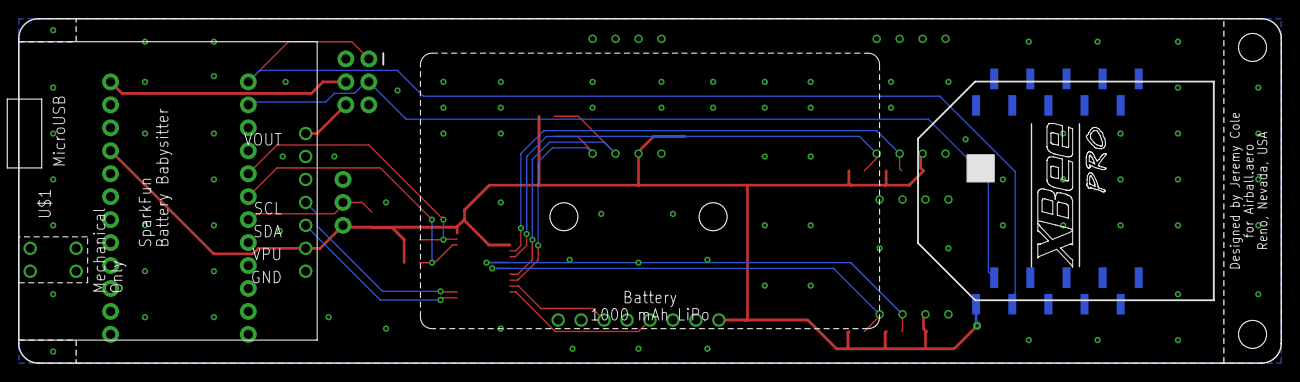
[picture p84: board airball_sensor_board_v7.brd from below]

Board: 2 copper layers, 139.7 x 38.1 mm, 24 parts (3 on the bottom side), 19 nets.
