airball-aero/airball-embedded/hardware/SensorBoard/airball_sensor_board_v6.brd

## EAGLE design hardware/SensorBoard/airball_sensor_board_v6.brd (2019-08-05, an earlier design)

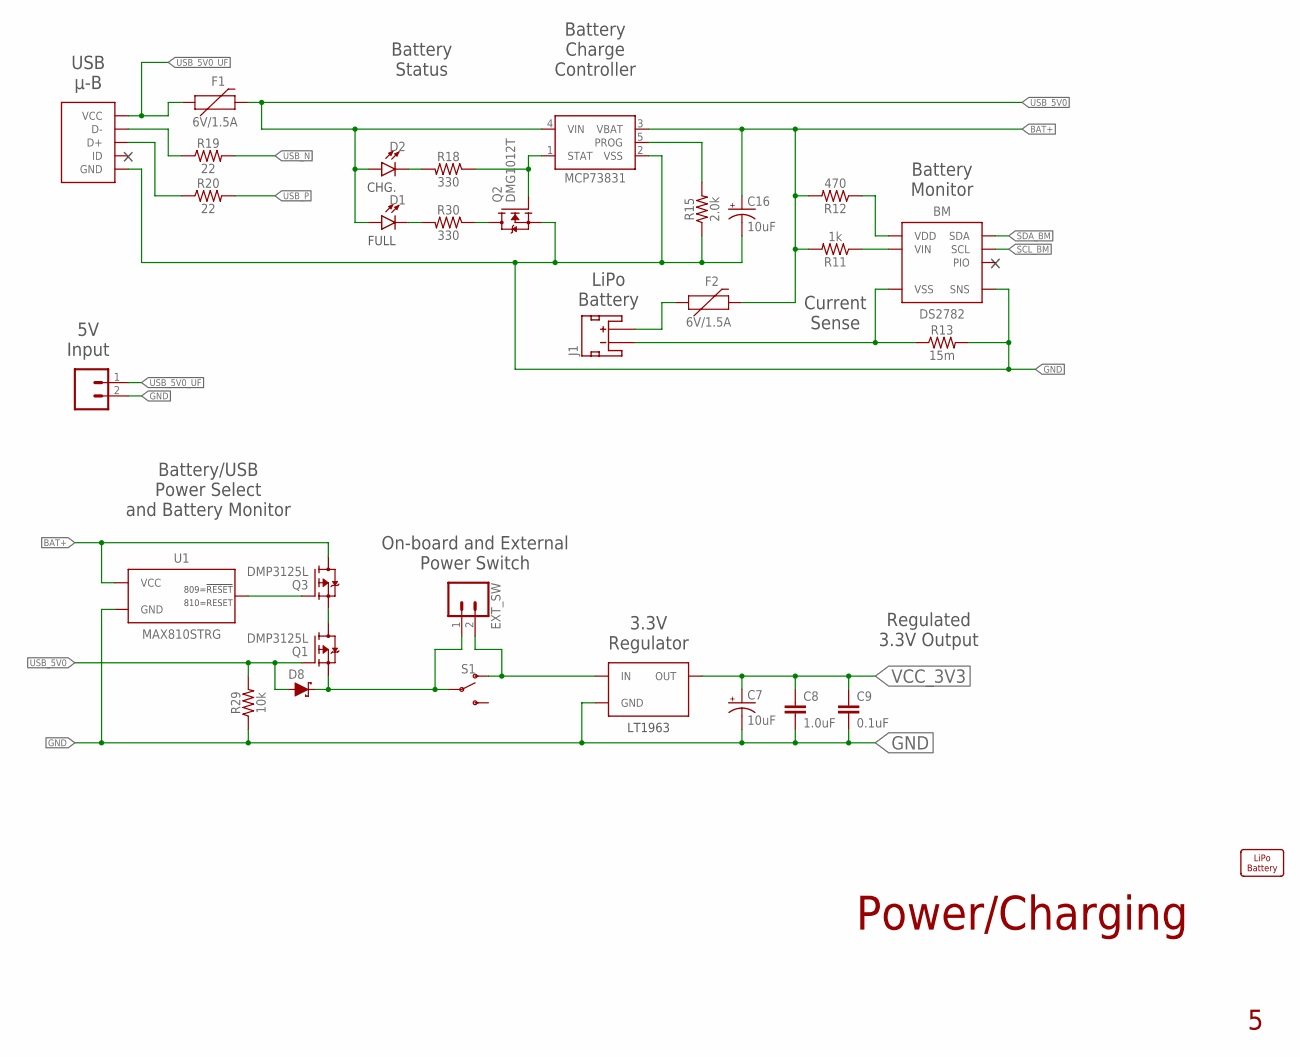
[picture p85: schematic airball_sensor_board_v6.sch, sheet 1]

Parts:
BM: DS2782; TSSOP8
C7, C16: 10uF; EIA3216
C8: 1.0uF; 0603
C9: 0.1uF; 0603
CC: MCP73831; SOT23-5
D1, D2: LED0603; LED-0603
D8: DIODE-SCHOTTKY-BAT20J; SOD-323
EXT_POWER: CONN_02; 1X02
EXT_SW: CONN_02; 1X02
F1, F2: 6V/1.5A; 1206
J1: JST_2MM_MALE; JST-2-SMD
JP1: USB_MICROB_PLUG; USB_MICRO_B_TYCO
Q1, Q3: DMP3125L; SOT23-3
Q2: DMG1012T; SOT523-3
R11: 1k; 0603
R12: 470; 0603
R13: 15m; 1206
R15: 2.0k; 0603
R18, R30: 330; 0603
R19, R20: 22; 0603
R29: 10k; 0603
S1: SWITCH-SPDT-SMD-RIGHT-ANGLE; SWITCH_SPST_SMD_A
U1: MAX810STRG; SOT23-3
U$3: LIPO_BATTERY_OUTLINE-1000MAH; SPARKFUN_LIPO_1000MAH
VREG: LT1963; SOT223-3

Connections:
BAT+: C16.+, CC.3 (VBAT), F2.2, Q3.3 (D), R11.2, R12.2, U1.3 (VCC)
BAT+_UF: F2.1, J1.2 (+)
BAT-: BM.2 (VSS), J1.1 (-), R13.1
BAT_LOW: Q3.1 (G), U1.2 (RESET)
BM_VDD: BM.4 (VDD), R12.1
BM_VIN: BM.3 (VIN), R11.1
CC_PROG: CC.5 (PROG), R15.2
GND: BM.7 (SNS), C7.-, C8.2, C9.2, C16.-, CC.2 (VSS), EXT_POWER.2, JP1.5 (GND), JP1.SH@1 (GND), JP1.SH@2 (GND), JP1.SH@3 (GND), JP1.SH@4 (GND), Q2.3 (S), R13.2, R15.1, R29.1, U1.1 (GND), VREG.2 (GND), VREG.TAB (GND); also elsewhere on the board
unnamed: D2.C, R18.2
unnamed: CC.1 (STAT), Q2.1 (G), R18.1
unnamed: Q1.3 (D), Q3.2 (S)
unnamed: D1.C, R30.2
unnamed: Q2.2 (D), R30.1
SCL_BM: BM.6 (SCL); also elsewhere on the board
SDA_BM: BM.5 (SDA); also elsewhere on the board
USB_5V0: CC.4 (VIN), D1.A, D2.A, D8.A, F1.2, Q1.1 (G), R29.2
USB_5V0_UF: EXT_POWER.1, F1.1, JP1.1 (VCC)
USB_N: R19.2; also elsewhere on the board
USB_P: R20.2; also elsewhere on the board
USB_X_N: JP1.2 (D-), R19.1
USB_X_P: JP1.3 (D+), R20.1
VCC_3V3: C7.+, C8.1, C9.1, VREG.3 (OUT); also elsewhere on the board
VIN: D8.C, EXT_SW.1, Q1.2 (S), S1.2
VIN_SW: EXT_SW.2, S1.1 (O), VREG.1 (IN)

Notes on the sheet:
LiPo Battery
USB µ-B
Battery Monitor
3.3V Regulator
Battery Charge Controller
On-board and External Power Switch
Regulated 3.3V Output
Battery Status
Current Sense
Power/Charging
5V Input
CHG.
FULL
Battery/USB Power Select and Battery Monitor

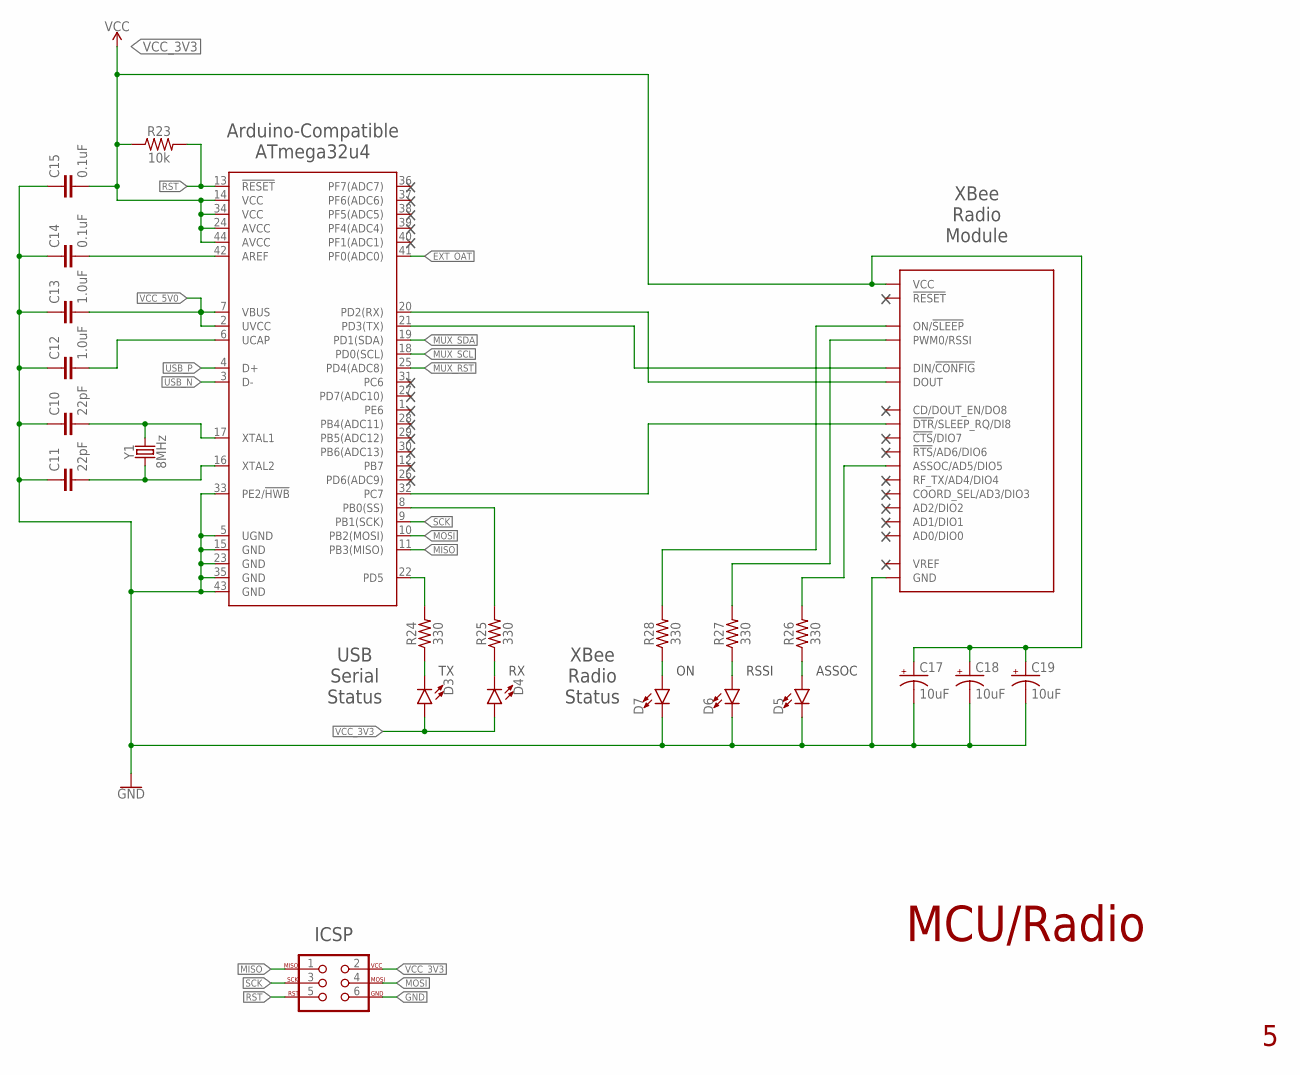
[picture p86: schematic airball_sensor_board_v6.sch, sheet 2]

Parts:
C10, C11: 22pF; 0603
C12, C13: 1.0uF; 0603
C14, C15: 0.1uF; 0603
C17, C18, C19: 10uF; EIA3216
D3, D4, D5, D6, D7: LED0603; LED-0603
ICSP: AVR_SPI_PROG_3X2PTH; 2X3
MCU: 32U4; TQFP44
R23: 10k; 0603
R24, R25, R26, R27, R28: 330; 0603
XBEE: XBEE-PRO-SMD
Y1: 8MHz; CRYSTAL-SMD-5X3.2-4PAD

Connections:
ASSOC_LED: R26.2, XBEE.15 (ASSOC/AD5/DIO5)
EXT_OAT: MCU.41 (PF0(ADC0)); also elsewhere on the board
GND: C10.1, C11.1, C12.1, C13.1, C14.1, C15.1, C17.-, C18.-, C19.-, D5.C, D6.C, D7.C, ICSP.6, MCU.5 (UGND), MCU.15 (GND), MCU.23 (GND), MCU.33 (PE2/!HWB), MCU.35 (GND), MCU.43 (GND), XBEE.10 (GND); also elsewhere on the board
MISO: ICSP.1, MCU.11 (PB3(MISO))
MOSI: ICSP.4, MCU.10 (PB2(MOSI))
MUX_RST: MCU.25 (PD4(ADC8)); also elsewhere on the board
MUX_SCL: MCU.18 (PD0(SCL)); also elsewhere on the board
MUX_SDA: MCU.19 (PD1(SDA)); also elsewhere on the board
unnamed: D3.C, R24.1
unnamed: D4.C, R25.1
unnamed: C10.2, MCU.17 (XTAL1), Y1.3 (2)
unnamed: C11.2, MCU.16 (XTAL2), Y1.1
unnamed: C14.2, MCU.42 (AREF)
unnamed: C12.2, MCU.6 (UCAP)
unnamed: D5.A, R26.1
unnamed: D6.A, R27.1
unnamed: D7.A, R28.1
ON_LED: R28.2, XBEE.13 (ON/!SLEEP)
RSSI_LED: R27.2, XBEE.6 (PWM0/RSSI)
RST: ICSP.5, MCU.13 (!RESET), R23.2
RXD: MCU.20 (PD2(RX)), XBEE.2 (DOUT)
RX_LED: MCU.8 (PB0(SS)), R25.2
SCK: ICSP.3, MCU.9 (PB1(SCK))
SLEEP_RQ: MCU.32 (PC7), XBEE.9 (!DTR!/SLEEP_RQ/DI8)
TXD: MCU.21 (PD3(TX)), XBEE.3 (DIN/!CONFIG)
TX_LED: MCU.22 (PD5), R24.2
USB_N: MCU.3 (D-); also elsewhere on the board
USB_P: MCU.4 (D+); also elsewhere on the board
VCC_3V3: C15.2, C17.+, C18.+, C19.+, D3.A, D4.A, ICSP.2, MCU.14 (VCC), MCU.24 (AVCC), MCU.34 (VCC), MCU.44 (AVCC), R23.1, XBEE.1 (VCC); also elsewhere on the board
VCC_5V0: C13.2, MCU.2 (UVCC), MCU.7 (VBUS)

Notes on the sheet:
RSSI
ASSOC
XBee Radio Module
Arduino-Compatible ATmega32u4
ICSP
USB Serial Status
XBee Radio Status
MCU/Radio

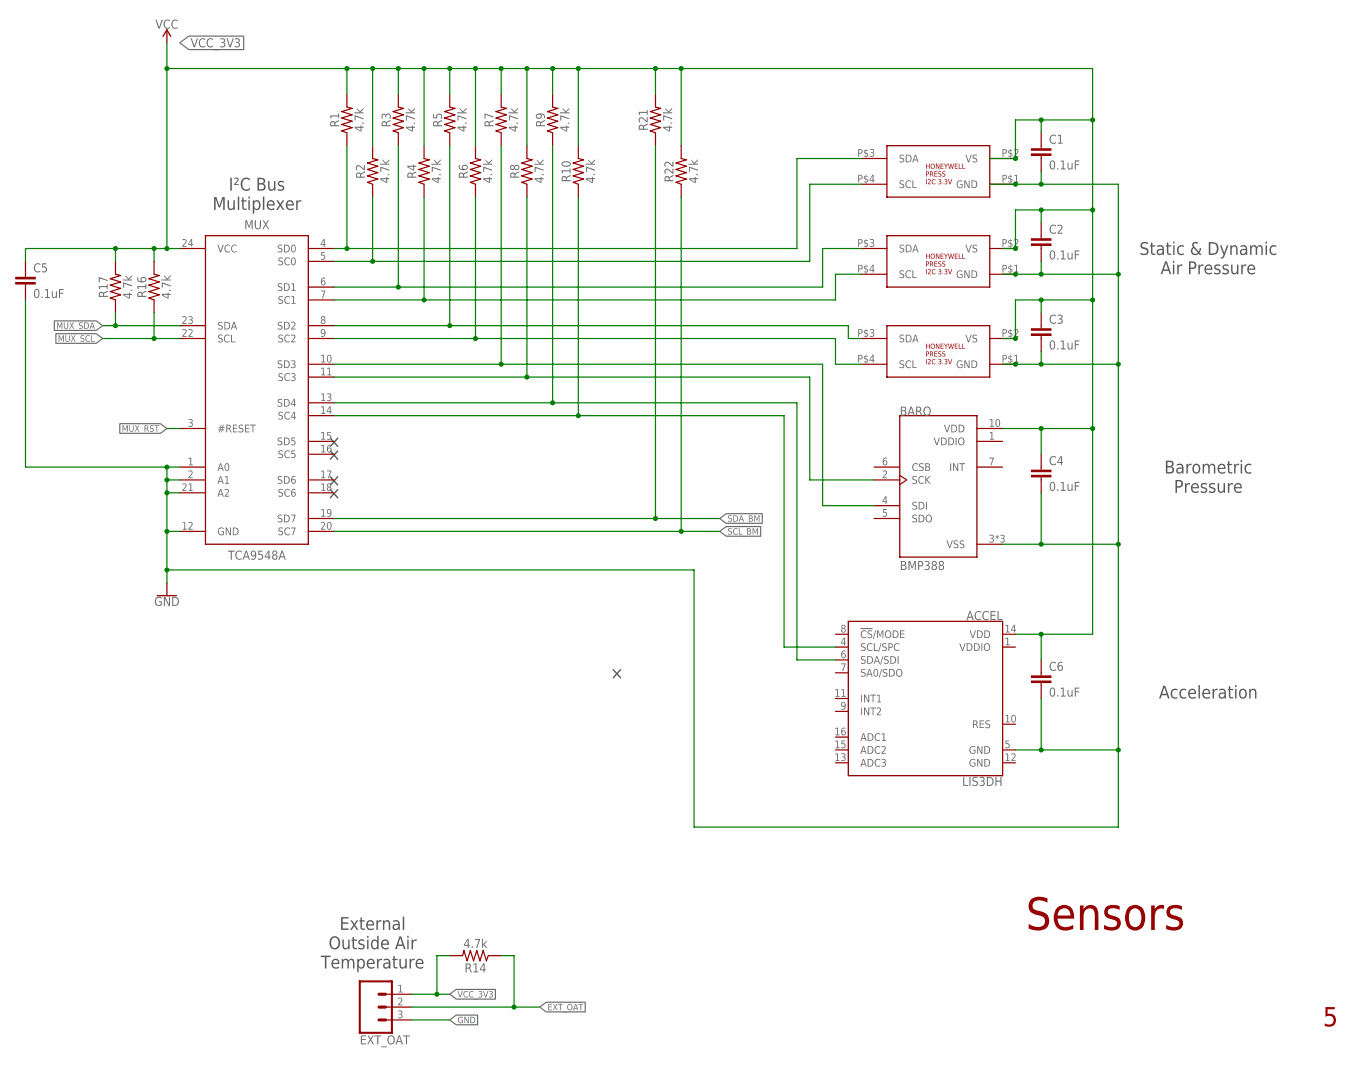
[picture p87: schematic airball_sensor_board_v6.sch, sheet 3]

Parts:
ACCEL: LIS3DH; LGA-16-3X3
BARO: BMP388; PQFN50P200X200X80-10N
C1, C2, C3, C4, C5, C6: 0.1uF; 0603
DP0: HONEYWELL_TRUSTABILITY_I2C_3.3V; HONEYWELL_TRUSTABILITY_DIP_RR
DPA: HONEYWELL_TRUSTABILITY_I2C_3.3V; HONEYWELL_TRUSTABILITY_DIP_RR
DPB: HONEYWELL_TRUSTABILITY_I2C_3.3V; HONEYWELL_TRUSTABILITY_DIP_RR
EXT_OAT: CONN_03; 1X03
MUX: TCA9548A; TSSOP24
R1, R2, R3, R4, R5, R6, R7, R8, R9, R10, R14, R16, R17, R21, R22: 4.7k; 0603

Connections:
EXT_OAT: EXT_OAT.2, R14.1; also elsewhere on the board
GND: ACCEL.5 (GND), BARO.3 (VSS), BARO.8 (VSS), BARO.9 (VSS), C1.2, C2.2, C3.2, C4.2, C5.2, C6.2, DP0.P$1 (GND), DPA.P$1 (GND), DPB.P$1 (GND), EXT_OAT.3, MUX.1 (A0), MUX.2 (A1), MUX.12 (GND), MUX.21 (A2); also elsewhere on the board
MUX_RST: MUX.3 (#RESET); also elsewhere on the board
MUX_SCL: MUX.22 (SCL), R16.1; also elsewhere on the board
MUX_SDA: MUX.23 (SDA), R17.1; also elsewhere on the board
SCL_ACCEL: ACCEL.4 (SCL/SPC), MUX.14 (SC4), R10.1
SCL_BM: MUX.20 (SC7), R22.1; also elsewhere on the board
SCL_BMP_BARO: BARO.2 (SCK), MUX.11 (SC3), R8.1
SCL_DP0: DP0.P$4 (SCL), MUX.5 (SC0), R2.1
SCL_DPA: DPA.P$4 (SCL), MUX.7 (SC1), R4.1
SCL_DPB: DPB.P$4 (SCL), MUX.9 (SC2), R6.1
SDA_ACCEL: ACCEL.6 (SDA/SDI), MUX.13 (SD4), R9.1
SDA_BM: MUX.19 (SD7), R21.1; also elsewhere on the board
SDA_BMP_BARO: BARO.4 (SDI), MUX.10 (SD3), R7.1
SDA_DP0: DP0.P$3 (SDA), MUX.4 (SD0), R1.1
SDA_DPA: DPA.P$3 (SDA), MUX.6 (SD1), R3.1
SDA_DPB: DPB.P$3 (SDA), MUX.8 (SD2), R5.1
VCC_3V3: ACCEL.14 (VDD), BARO.10 (VDD), C1.1, C2.1, C3.1, C4.1, C5.1, C6.1, DP0.P$2 (VS), DPA.P$2 (VS), DPB.P$2 (VS), EXT_OAT.1, MUX.24 (VCC), R1.2, R2.2, R3.2, R4.2, R5.2, R6.2, R7.2, R8.2, R9.2, R10.2, R14.2, R16.2, R17.2, R21.2, R22.2; also elsewhere on the board
VDDIO: BARO.1 (VDDIO)

Notes on the sheet:
Sensors
I²C Bus Multiplexer
Static & Dynamic Air Pressure
External Outside Air Temperature
Barometric Pressure
Acceleration

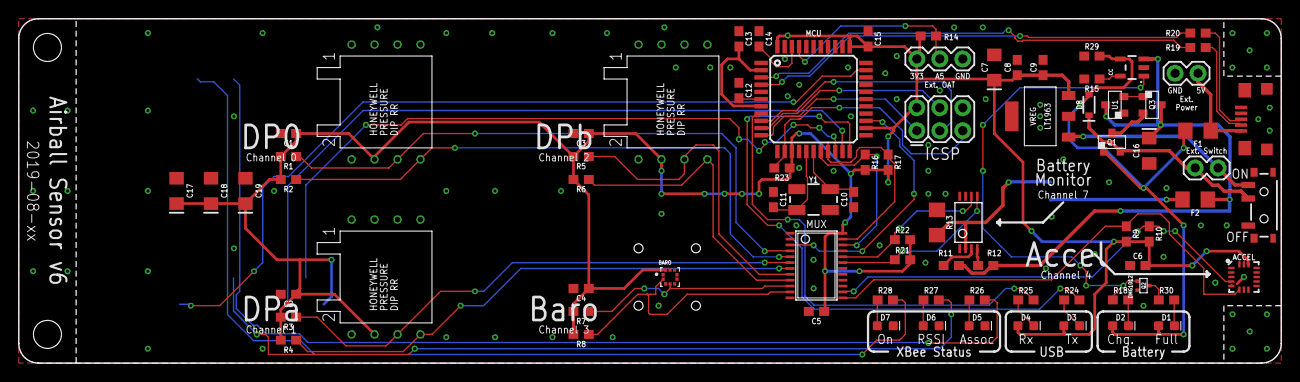
[picture p88: board airball_sensor_board_v6.brd from above]

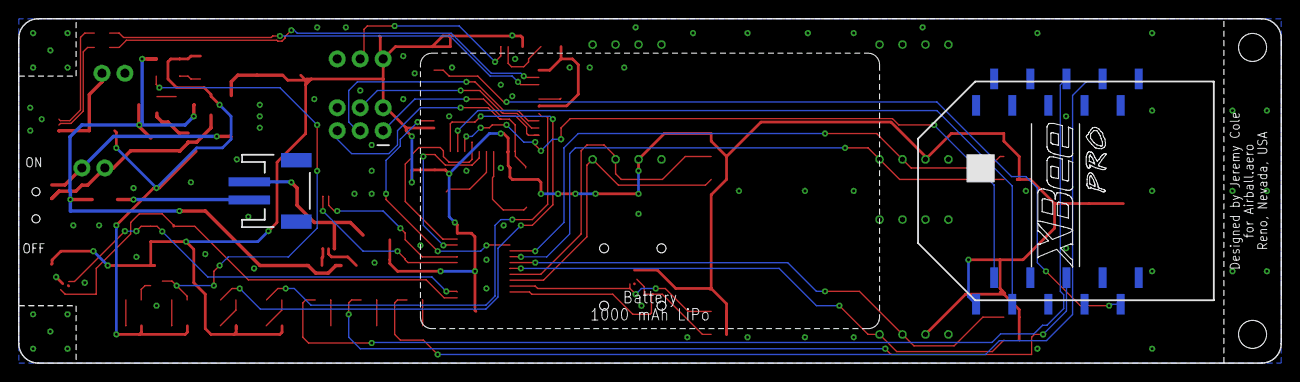
[picture p89: board airball_sensor_board_v6.brd from below]

Board: 2 copper layers, 139.7 x 38.1 mm, 83 parts (3 on the bottom side), 60 nets.
