airball-aero/airball-embedded/hardware/SensorBoard/airball_sensor_board_v2.brd

## EAGLE design hardware/SensorBoard/airball_sensor_board_v2.brd (2018-01-13, an earlier design)

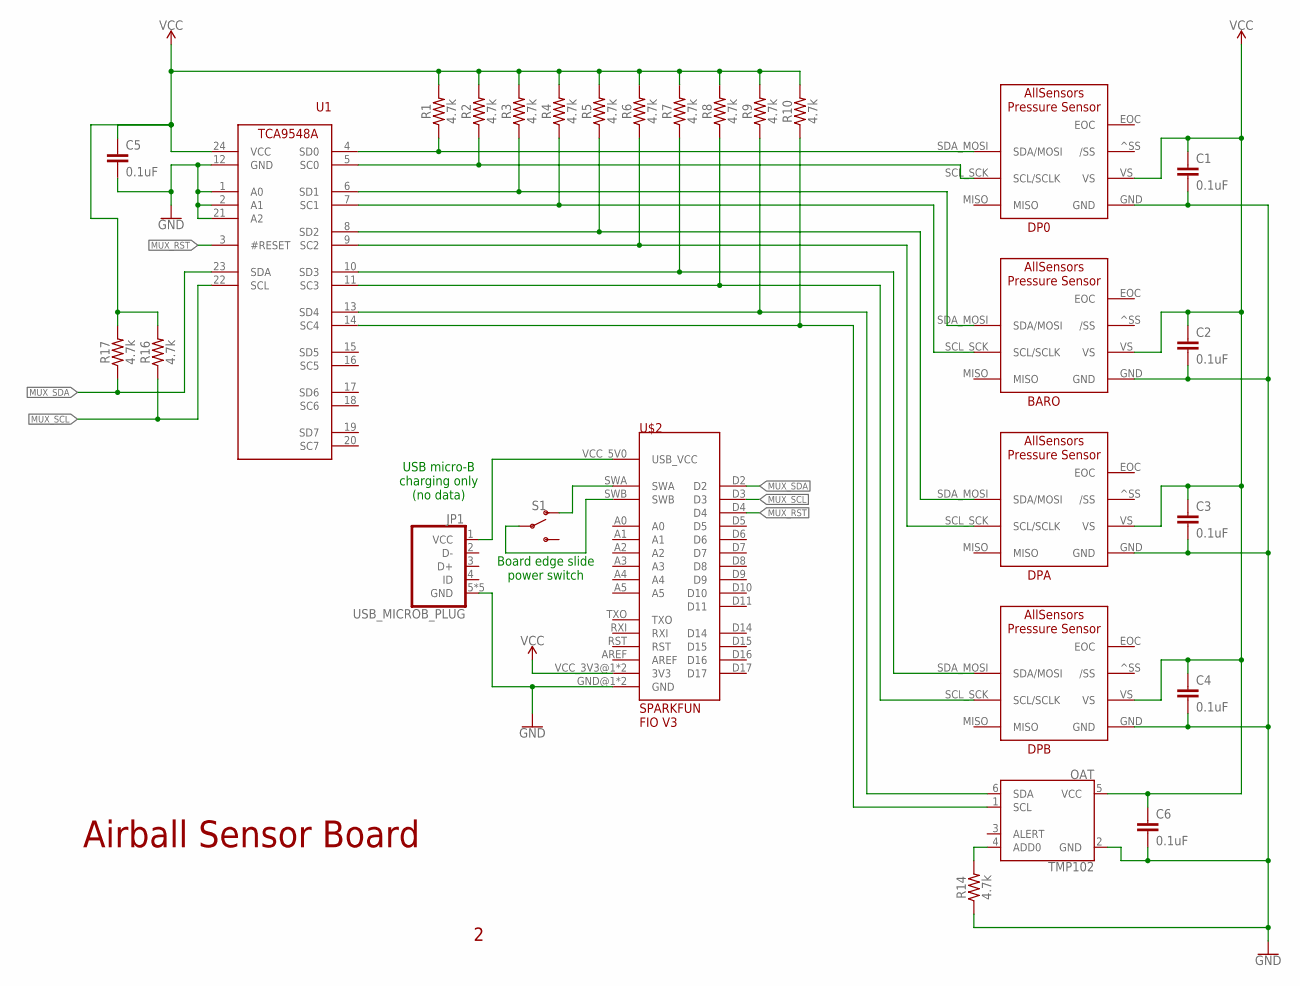
[picture p90: schematic airball_sensor_board_v2.sch]

Parts:
BARO: ALL_SENSORS_DLHR_E1ND; ALL_SENSORS_E1BD_8PIN_THRU
C1, C2, C3, C4, C5, C6: 0.1uF; 0603
DP0: ALL_SENSORS_DLHR_E1ND; ALL_SENSORS_E1BD_8PIN_THRU
DPA: ALL_SENSORS_DLHR_E1ND; ALL_SENSORS_E1BD_8PIN_THRU
DPB: ALL_SENSORS_DLHR_E1ND; ALL_SENSORS_E1BD_8PIN_THRU
JP1: USB_MICROB_PLUG; USB_MICRO_B_TYCO
OAT: TMP102; SOT563
R1, R2, R3, R4, R5, R6, R7, R8, R9, R10, R14, R16, R17: 4.7k; 0603
S1: SWITCH-SPDT-SMD-RIGHT-ANGLE; SWITCH_SPST_SMD_A
U1: TCA9548ATSSOP24; TSSOP24
U$2: SPARKFUN_FIO_V3

Connections:
GND: BARO.GND, C1.2, C2.2, C3.2, C4.2, C5.2, C6.2, DP0.GND, DPA.GND, DPB.GND, JP1.5 (GND), JP1.SH@1 (GND), JP1.SH@2 (GND), JP1.SH@3 (GND), JP1.SH@4 (GND), OAT.2 (GND), R14.1, U1.1 (A0), U1.2 (A1), U1.12 (GND), U1.21 (A2), U$2.GND@1 (GND), U$2.GND@2 (GND)
MUX_RST: U1.3 (#RESET), U$2.D4
MUX_SCL: R16.1, U1.22 (SCL), U$2.D3
MUX_SDA: R17.1, U1.23 (SDA), U$2.D2
OAT_ADD0: OAT.4 (ADD0), R14.2
SCL_BARO: BARO.SCL_SCK (SCL/SCLK), R4.1, U1.7 (SC1)
SCL_DP0: DP0.SCL_SCK (SCL/SCLK), R2.1, U1.5 (SC0)
SCL_DPA: DPA.SCL_SCK (SCL/SCLK), R6.1, U1.9 (SC2)
SCL_DPB: DPB.SCL_SCK (SCL/SCLK), R8.1, U1.11 (SC3)
SCL_OAT: OAT.1 (SCL), R10.1, U1.14 (SC4)
SDA_BARO: BARO.SDA_MOSI (SDA/MOSI), R3.1, U1.6 (SD1)
SDA_DP0: DP0.SDA_MOSI (SDA/MOSI), R1.1, U1.4 (SD0)
SDA_DPA: DPA.SDA_MOSI (SDA/MOSI), R5.1, U1.8 (SD2)
SDA_DPB: DPB.SDA_MOSI (SDA/MOSI), R7.1, U1.10 (SD3)
SDA_OAT: OAT.6 (SDA), R9.1, U1.13 (SD4)
SWA: S1.1 (O), U$2.SWA
SWB: S1.2, U$2.SWB
VCC_3V3: BARO.VS, C1.1, C2.1, C3.1, C4.1, C5.1, C6.1, DP0.VS, DPA.VS, DPB.VS, OAT.5 (VCC), R1.2, R2.2, R3.2, R4.2, R5.2, R6.2, R7.2, R8.2, R9.2, R10.2, R16.2, R17.2, U1.24 (VCC), U$2.VCC_3V3@1 (3V3), U$2.VCC_3V3@2 (3V3)
VCC_USB: JP1.1 (VCC), U$2.VCC_5V0 (USB_VCC)

Notes on the sheet:
USB micro-B charging only (no data)
Board edge slide power switch
Airball Sensor Board
