airball-aero/airball-embedded/hardware/SensorBoard/airball_sensor_board_v2.brd

## EAGLE design hardware/SensorBoard/airball_sensor_board_v2.brd (continued)

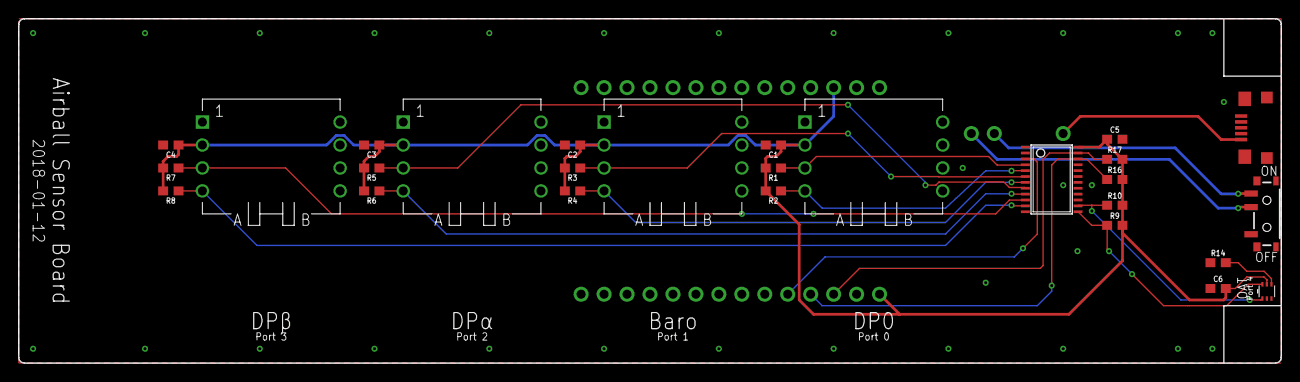
[picture p91: board airball_sensor_board_v2.brd from above]

Board: 2 copper layers, 139.7 x 38.1 mm, 28 parts (1 on the bottom side), 19 nets.
