airball-aero/airball-embedded/hardware/SensorBoard/airball_sensor_board_v1.brd

## EAGLE design hardware/SensorBoard/airball_sensor_board_v1.brd (2017-12-29, an earlier design)

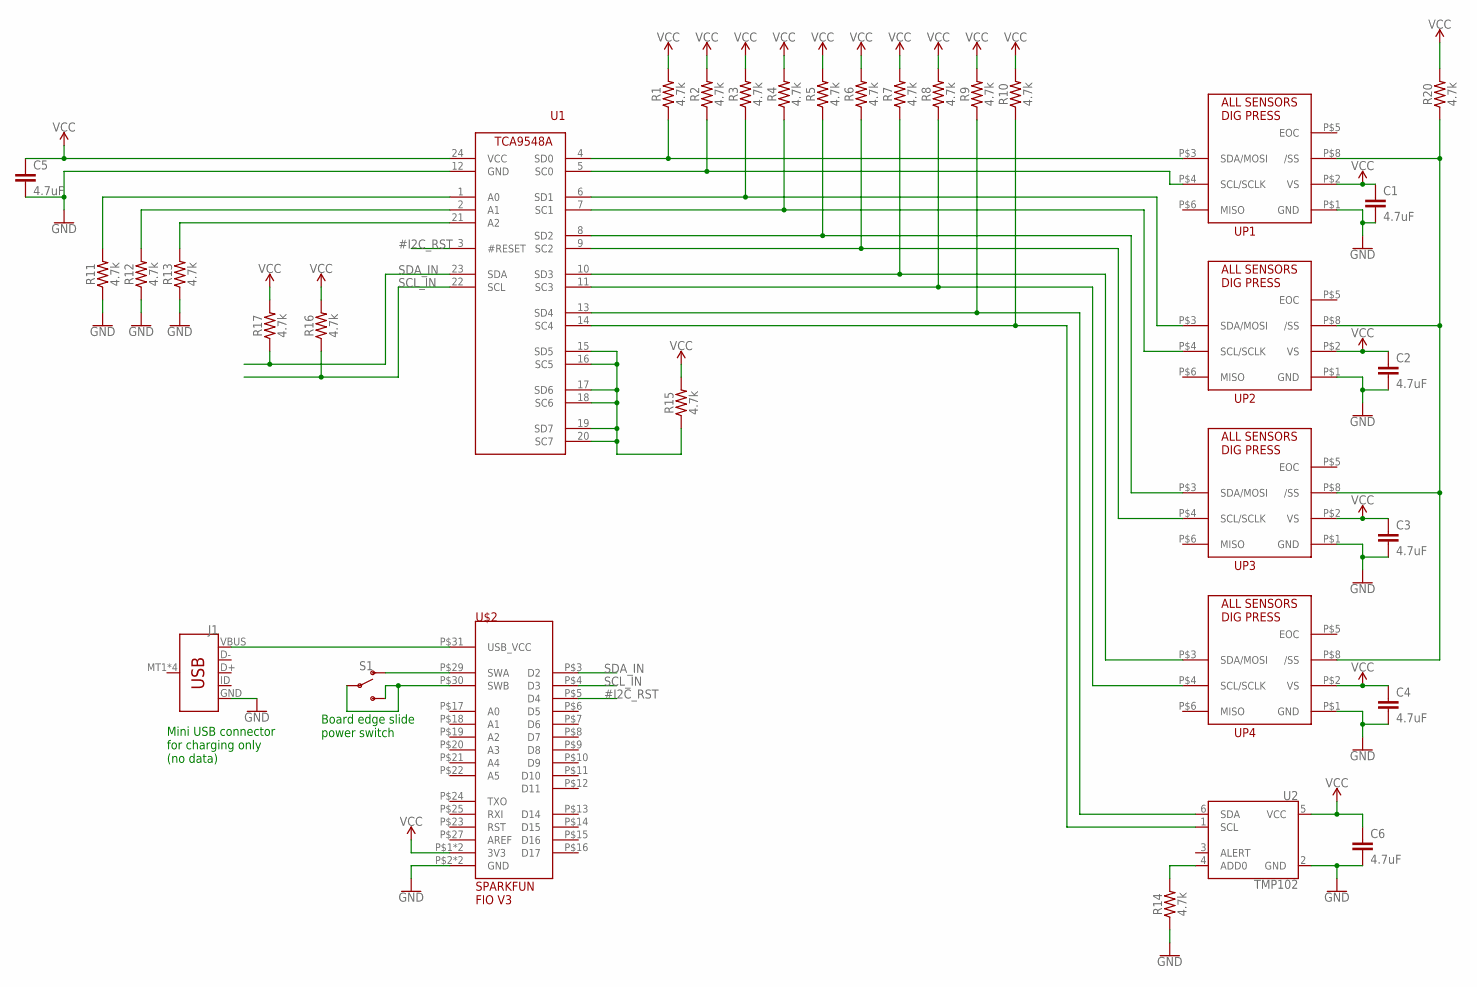
[picture p92: schematic airball_sensor_board_v1.sch]

Parts:
C1, C2, C3, C4, C5, C6: 4.7uF; 0603
J1: USB_MICRO-B_SMT; USB-MICROB
R1, R2, R3, R4, R5, R6, R7, R8, R9, R10, R11, R12, R13, R14, R15, R16, R17, R20: 4.7k; 0603
S1: SWITCH-SPDT-SMD-RIGHT-ANGLE; SWITCH_SPST_SMD_A
U1: TCA9548ATSSOP24; TSSOP24
U2: TMP102; SOT563
U$2: SPARKFUN_FIO_V3
UP1, UP2, UP3, UP4: ALL_SENSORS_DLHR_E1ND; ALL_SENSORS_E1BD_8PIN_THRU

Connections:
#I2C_RST: U1.3 (#RESET), U$2.P$5 (D4)
GND: C1.2, C2.2, C3.2, C4.2, C5.2, C6.2, J1.GND, R11.1, R12.1, R13.1, R14.1, U1.12 (GND), U2.2 (GND), U$2.P$2 (GND), U$2.P$28 (GND), UP1.P$1 (GND), UP2.P$1 (GND), UP3.P$1 (GND), UP4.P$1 (GND)
unnamed: R1.1, U1.4 (SD0), UP1.P$3 (SDA/MOSI)
unnamed: R2.1, U1.5 (SC0), UP1.P$4 (SCL/SCLK)
unnamed: R3.1, U1.6 (SD1), UP2.P$3 (SDA/MOSI)
unnamed: R4.1, U1.7 (SC1), UP2.P$4 (SCL/SCLK)
unnamed: R5.1, U1.8 (SD2), UP3.P$3 (SDA/MOSI)
unnamed: R6.1, U1.9 (SC2), UP3.P$4 (SCL/SCLK)
unnamed: R7.1, U1.10 (SD3), UP4.P$3 (SDA/MOSI)
unnamed: R8.1, U1.11 (SC3), UP4.P$4 (SCL/SCLK)
unnamed: S1.1 (O), U$2.P$29 (SWA)
unnamed: J1.VBUS, U$2.P$31 (USB_VCC)
unnamed: R13.2, U1.21 (A2)
unnamed: R12.2, U1.2 (A1)
unnamed: R11.2, U1.1 (A0)
unnamed: R20.1, UP1.P$8 (/SS), UP2.P$8 (/SS), UP3.P$8 (/SS), UP4.P$8 (/SS)
unnamed: R9.1, U1.13 (SD4), U2.6 (SDA)
unnamed: R10.1, U1.14 (SC4), U2.1 (SCL)
unnamed: S1.2, S1.3 (S), U$2.P$30 (SWB)
unnamed: R14.2, U2.4 (ADD0)
unnamed: R15.1, U1.15 (SD5), U1.16 (SC5), U1.17 (SD6), U1.18 (SC6), U1.19 (SD7), U1.20 (SC7)
SCL_IN: R16.1, U1.22 (SCL), U$2.P$4 (D3)
SDA_IN: R17.1, U1.23 (SDA), U$2.P$3 (D2)
VCC: C1.1, C2.1, C3.1, C4.1, C5.1, C6.1, R1.2, R2.2, R3.2, R4.2, R5.2, R6.2, R7.2, R8.2, R9.2, R10.2, R15.2, R16.2, R17.2, R20.2, U1.24 (VCC), U2.5 (VCC), U$2.P$1 (3V3), U$2.P$26 (3V3), UP1.P$2 (VS), UP2.P$2 (VS), UP3.P$2 (VS), UP4.P$2 (VS)

Notes on the sheet:
Mini USB connector for charging only (no data)
Board edge slide power switch

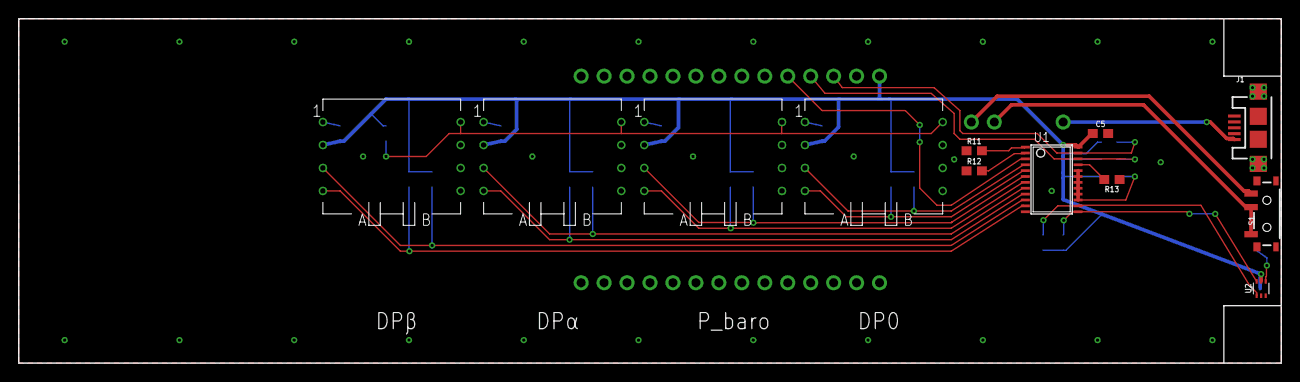
[picture p93: board airball_sensor_board_v1.brd from above]

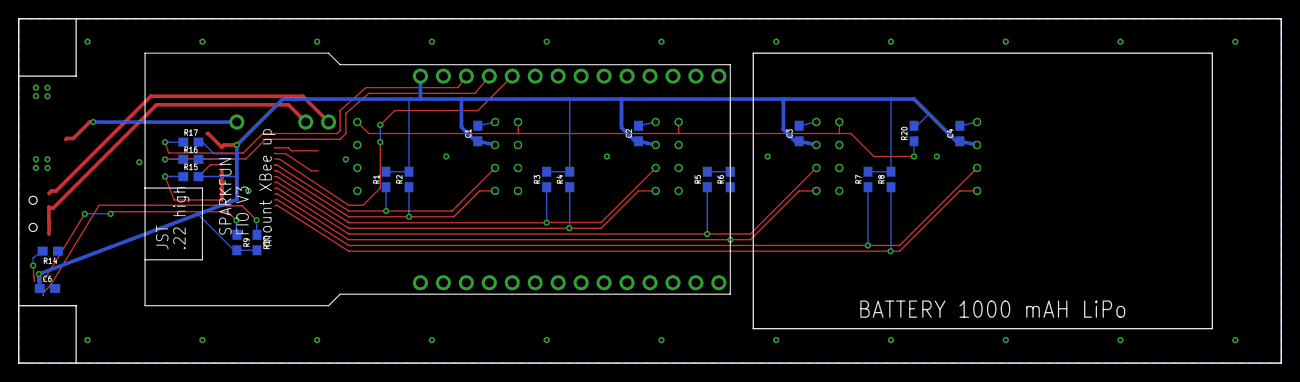
[picture p94: board airball_sensor_board_v1.brd from below]

Board: 2 copper layers, 139.7 x 38.1 mm, 33 parts (21 on the bottom side), 24 nets.
