airball-aero/airball-embedded/host/display/widgets.h

/**
 * The MIT License (MIT)
 *
 * Copyright (c) 2017-2018, Ihab A.B. Awad
 *
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
 * THE SOFTWARE IS PROVIDED "AS IS", WITHOUT WARRANTY OF ANY KIND, EXPRESS OR
 * IMPLIED, INCLUDING BUT NOT LIMITED TO THE WARRANTIES OF MERCHANTABILITY,
 * FITNESS FOR A PARTICULAR PURPOSE AND NONINFRINGEMENT. IN NO EVENT SHALL THE
 * AUTHORS OR COPYRIGHT HOLDERS BE LIABLE FOR ANY CLAIM, DAMAGES OR OTHER
 * LIABILITY, WHETHER IN AN ACTION OF CONTRACT, TORT OR OTHERWISE, ARISING FROM,
 * OUT OF OR IN CONNECTION WITH THE SOFTWARE OR THE USE OR OTHER DEALINGS IN
 * THE SOFTWARE.
 */

#ifndef AIRBALL_WIDGETS_H
#define AIRBALL_WIDGETS_H

#include <string>
#include <vector>
#include <cairo/cairo.h>

namespace airball {

// Basic classes

class Point {
public:
  constexpr Point() : Point(0, 0) {}
  constexpr Point(double x, double y) : x_(x), y_(y) {}
  double x() const {return x_;}
  double y() const {return y_;}
private:
  double x_, y_;
};

class Size {
public:
  constexpr Size() : Size(0, 0) {}
  constexpr Size(double w, double h) : w_(w), h_(h) {}
  double w() const {return w_;}
  double h() const {return h_;}
private:
  double w_, h_;
};

class Color {
public:
  constexpr Color() : Color(0, 0, 0) {}
  constexpr Color(double r, double g, double b) : r_(r), g_(g), b_(b), a_(1) {}
  constexpr Color(double r, double g, double b, double a) : r_(r), g_(g), b_(b), a_(a) {}
  constexpr Color(int r, int g, int b)
      : Color(hexToRatio(r), hexToRatio(g), hexToRatio(b)) {}
  constexpr Color with_alpha(double a) const {
    return Color(r_, g_, b_, a);
  }
  constexpr Color with_brightness(double bright) const {
    return Color(r_ * bright, g_ * bright, b_ * bright, a_);
  }
  double r() const {return r_;}
  double g() const {return g_;}
  double b() const {return b_;}
  double a() const {return a_;}
  void apply(cairo_t *cr) const;
private:
  static constexpr double hexToRatio(int hex) {
    return (double) hex / (double) 0xff;
  }
  double r_, g_, b_, a_;
};

class Stroke {
public:
  constexpr Stroke() : Stroke(Color(), 0) {}
  constexpr Stroke(Color color, double width) : color_(color), width_(width) {}
  Color color() const {return color_;}
  double width() const {return width_;}
  void apply(cairo_t *cr) const;
private:
  Color color_;
  double width_;
};

class Font {
public:
  constexpr Font() : Font(nullptr, 0) {}
  constexpr Font(
      const char* face,
      const double size)
  : face_(face), size_(size) {}
  const char* face() const { return face_; }
  double size() const { return size_; }
  void apply(cairo_t* cr) const;
private:
  const char* face_;
  double size_;
};

void line(
    cairo_t* cr,
    const Point& start,
    const Point& end,
    const Stroke& stroke);

void arc(
    cairo_t* cr,
    const Point& center,
    const double radius,
    const double start_angle,
    const double end_angle,
    const Stroke& stroke);

void disc(
    cairo_t* cr,
    const Point& center,
    const double radius,
    const Color& fill);

void rosette(
    cairo_t* cr,
    const Point& center,
    const double radius,
    const int num_petals,
    const double petal_angle,
    const double start_angle,
    const Stroke& stroke);

void rectangle(
    cairo_t* cr,
    const Point& top_left,
    const Size& size,
    const Color& fill);

void round_rectangle(
    cairo_t* cr,
    const Point& top_left,
    const Size& size,
    const double corner_radius,
    const Color& fill);

void box(
    cairo_t* cr,
    const Point& top_left,
    const Size& size,
    const Stroke& stroke);

void polygon(
    cairo_t* cr,
    const int numCorners,
    const Point corners[],
    const Stroke& stroke);

void shape(
    cairo_t* cr,
    const int numCorners,
    const Point corners[],
    const Color& fill);

enum TextReferencePoint {
  TOP_LEFT,
  TOP_RIGHT,
  CENTER_LEFT_UPPERCASE,
  CENTER_RIGHT_UPPERCASE,
  CENTER_MID_UPPERCASE,
};

Size text_size(
    cairo_t* cr,
    const std::string& str,
    const Font& font);

void text(
    cairo_t* cr,
    const std::string& str,
    const Point& point,
    const TextReferencePoint ref,
    const Font& font,
    const Color& color);

} // namespace airball

#endif // AIRBALL_WIDGETS_H
