airball-aero/airball-embedded/host/display/st7789vi_screen.h

#include <condition_variable>
#include <mutex>
#include <thread>

#include "screen.h"

#include "st7789vi_frame_writer_smi.h"

namespace airball {

class ST7789VIScreen : public Screen {
public:
  ST7789VIScreen();

  ~ST7789VIScreen() override;

  virtual void flush() override;

private:
  st7789vi_frame_writer_smi w_;
  unsigned char *data_;
  std::thread paint_;
  std::mutex paint_mu_;
  std::condition_variable paint_cond_;
};

}  // namespace airball
