airball-aero/airball-embedded/host/display/units.h

#ifndef AIRBALL_UNITS_H
#define AIRBALL_UNITS_H

#include <math.h>

constexpr double knots_to_meters_per_second(double v) {
  return v / 1.94384;
}

constexpr double meters_per_second_to_knots(double v) {
  return v * 1.94384;
}

constexpr double mph_to_meters_per_second(double v) {
  return v / 2.23694;
}

constexpr double meters_per_second_to_mph(double v) {
  return v * 2.23694;
}

constexpr double radians_to_degrees(double v) {
  return v * 180 / M_PI;
}

constexpr double degrees_to_radians(double v) {
  return v / 180 * M_PI;
}

constexpr double celsius_to_kelvin(double v) {
  return v + 273.15;
}

constexpr double kPascalsPerInHg = 3386.39;

constexpr double kMetersPerFoot = 0.3048;

constexpr double kSecondsPerMinute = 60;

#endif  // AIRBALL_UNITS_H
