airball-aero/airball-embedded/host/display/stallfence_scheme.h

#ifndef AIRBALL_DISPLAY_STALLFENCE_SCHEME_H
#define AIRBALL_DISPLAY_STALLFENCE_SCHEME_H

#include "sound_scheme.h"
#include "sine_layer.h"
#include "pwm_layer.h"
#include "balance_layer.h"

namespace airball {

class stallfence_scheme: public sound_scheme {
public:
  explicit stallfence_scheme(std::string device_name,
                             ISettings* settings,
                             IAirdata* airdata);
  ~stallfence_scheme() override = default;

protected:
  void update() override;

private:
  sine_layer tone_;
  pwm_layer pwm_;
  balance_layer balance_;
};

} // namespace airball

#endif //AIRBALL_DISPLAY_STALLFENCE_SCHEME_H
