airball-aero/airball-embedded/host/display/sound_layer.h

#ifndef AIRBALL_DISPLAY_SOUND_LAYER_H
#define AIRBALL_DISPLAY_SOUND_LAYER_H

#include <cstdint>
#define ALSA_PCM_NEW_HW_PARAMS_API
#include <alsa/asoundlib.h>

namespace airball {

class sound_layer {
public:
  explicit sound_layer() = default;
  virtual ~sound_layer() = default;

  // Apply this layer to a PCM buffer of a given number of frames. The buffer
  // contains interleaved left and right values, and so is (2 * frames) long.
  virtual void apply(int16_t* buf, snd_pcm_uframes_t frames) = 0;
};

} // namespace airball

#endif // AIRBALL_DISPLAY_SOUND_LAYER_H
