airball-aero/airball-embedded/firmware/airball_probe_esp32/probe_calibration.h

#include "calibration_surface.h"


  
  // Alpha as a function of (dpa/dp0, dpb/dp0)
  const calibration_surface probe_alpha = {
    .x = {
      .size = 81,
      .step = 0.1,
      .zero_offset = 4.0,
    },
    .y = {
      .size = 41,
      .step = 0.1,
      .zero_offset = 0.0,
    },
    .data = (float[]) {
      -47.37449933775762f, -47.17546195427274f, -46.985624097736086f, -46.80371566782151f, -46.62846656420286f, -46.458606686553985f, -46.29286593454875f, -46.129974207861f, -45.96866140616458f, -45.80765742913335f, -45.64569217644116f, -45.48149554776185f, -45.31379744276929f, -45.14132776113732f, -44.962816402539794f, -44.776993266650564f, -44.58258825314348f, -44.378331261692395f, -44.162952191971165f, -43.935180943653634f, -43.69374741641366f, -43.43738150992508f, -43.16481312386176f, -42.87477215789755f, -42.5659885117063f, -42.23719208496186f, -41.88711277733809f, -41.51448048850883f, -41.11802511814793f, -40.69647656592926f, -40.24856473152664f, -39.773019514613964f, -39.26857081486503f, -38.733948531953736f, -38.16788256555392f, -37.56910281533943f, -36.936339180984106f, -36.26832156216182f, -35.56377985854641f, -34.82144396981174f, -34.04004379563165f, -46.44363209297576f, -46.249570644078005f, -46.06447873395476f, -45.88711801478805f, -45.71625013875987f, -45.55063675805222f, -45.389039524847114f, -45.23022009132655f, -45.07294010967255f, -44.915961232067104f, -44.7580451106922f, -44.59795339772988f, -44.43444774536214f, -44.26628980577097f, -44.092241231138374f, -43.91106367364638f, -43.72151878547698f, -43.522368218812176f, -43.31237362583396f, -43.09029665872438f, -42.8548989696654f, -42.60494221083904f, -42.3391880344273f, -42.0563980926122f, -41.755334037575736f, -41.4347575214999f, -41.09343019656672f, -40.730113714958186f, -40.34356972885632f, -39.93255989044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
1635101836026f, 22.734950844180172f, 
    },
  };
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
