airball-aero/airball-embedded/(commit log)

2017-07-23 Rearranged Arduino libraries directory and README.
2017-07-23 Changed to read and support temperature in data sentences. Now switches to white circle as airball when the IAS is too small to reasonably display.
    [airdata.cpp, controller.cpp, display.cpp]
2017-07-23 Temperatures in Kelvin throughout.
2017-08-01 Improve probe math to match what was written in 2016 paper.
2017-12-11 Test run on freeway.
    [data.csv]
2017-12-16 Adds a test for the airdata module, and makes the indexing of the interpolated region overlap with "zero" so as to avoid out-of-range due to numerical precision.
    [airdata.cpp, airdata.h, airdata_test.cpp]
2017-12-26 Test run on the road.
    [plot.csv]
2017-12-29 Adding Eagle files to Airball repo.
    [board.brd, board.sch]
2017-12-31 Data from road test of "probe on a stick".
    [plot.csv]
2017-12-31 Analysis of road test data for filtering.
2018-01-10 Add new airball_probe Arduino codebase
    This is an initial re-implementation of the code in dlhrl10g_read, with
    the following major changes:
    * Moved all TI TCA9548A I2C mux handling code to a new TI_TCA9548A
    library published on GitHub as jeremycole/TI_TCA9548A.
    * Moved all AllSensors DLHR handling code to a new AllSensors_DLHR
    library published on GitHub as jeremycole/AllSensors_DLHR.
    * Use of a timer to produce data at a steady 20 Hz rate.
    * Performance improvements related to printing data.
    * Generally cleaner code.
    The new Arduino libraries have been submitted to Arduino for addition to
    the Library Manager in the Arduino IDE, which should happen shortly.
    [airball_probe.ino]
2018-01-13 Added airball sensor board v2; renames and cleanups of EAGLE files
    [airball_sensor_board_v1.brd, airball_sensor_board_v1.sch, airball_sensor_board_v2.brd, airball_sensor_board_v2.sch]
2018-01-15 Experimental code to demonstrate how to cross-compile for RasPi/ARM using a pre-packaged set of tools.
2018-01-19 Airball Sensor Board v3
    In v2, the Sparkfun Fio v3 was flipped relative to the Airball board,
    because of an error stemming from a cleanup of the package. This means
    it's not possible to mount the Fio and the pressure sensors at the same
    time. :(
    In v3, the following things are fixed/changed:
    * Flipped the Sparkfun Fio v3 headers.
    * Rounded the corners of the board a bit more.
    * Updated all silkscreen text to use "vector" font instead of "fixed",
    as that's what the fab actually uses, so it looks like the final
    result in EAGLE.
    * Increased the weight of the pressure sensor labels and a few others
    and done some minor cleanups based on seeing the board in person.
    Electrical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
    [airball_sensor_board_v3.brd, airball_sensor_board_v3.sch]
2018-01-26 Cleanup of EAGLE libraries
    Several parts were added to the unrelated library microbuilder.lbr;
    migrate those to a new airball.lbr library file, and delete
    microbuilder. Adjust airball_sensor_board_v3 to reference the new
    library and adjust schematic device placement for minor cleanups.
    [airball_sensor_board_v3.brd, airball_sensor_board_v3.sch]
2018-01-30 Remove old dlhrl10g_read Arduino sketch
2018-01-30 Update airball_probe Arduino sketch to use new library for TMP102
    Update the airball_probe sketch to use the newly-written library for the
    TI TMP102 temperature sensor, Temperature_LM75_Derived. This should be
    functionally the same. A major semantic bug was fixed in that the older
    library was reading the high 8 and low 4 bits of the temperature data in
    two separate I2C transactions, which could cause corruption.
    [airball_probe.ino]
2018-02-03 Road test data.
    [plot.csv]
2018-02-09 Initial add of sensor board v4, unrouted and half-done
    [airball_sensor_board_v4.brd, airball_sensor_board_v4.sch]
2018-02-11 Added plots for analyzing yaw signal.
    [plot.csv]
2018-02-15 Use AllSensors_DLV to retrieve actual baro pressure data in airball_probe
2018-02-26 Many new parts and fixes for sensor_board v4 and new display_board
2018-02-26 Add newest WIP for airball_sensor_board_v4 and STL
    [airball_sensor_board_v4.brd, airball_sensor_board_v4.sch, airball_sensor_board_v4_20180225_2200.stl]
2018-02-26 Add new WIP airball_display_board_v1
    [airball_display_board_v1.brd, airball_display_board_v1.sch]
2018-02-28 Updated airball_sensor_board_v4 and library; added as-ordered gerbers
    [airball_sensor_board_v4.brd, airball_sensor_board_v4.sch]
2018-03-03 Added license header to "arduino/" subdir.
2018-03-10 Added CHANGES document for SensorBoard
2018-03-14 Data from test flight.
    [plot.csv]
2018-03-15 Add missing includes for <cmath> to two tests
    [delay_timer_test.cpp, interpolation_table_test.cpp]
2018-03-18 Fix calculations to consistently use degrees C rather than degrees K. Previously we used degrees K, then switched to degrees C but failed to update the codebase throughout. Added more tets.
    [aerodynamics.cpp, aerodynamics_test.cpp, airdata_test.cpp, units.h]
2018-03-29 Several cleanups and new parts to support sensor v5 and display v1
2018-03-29 Minor cleanups to sensor v4
    [airball_sensor_board_v4.brd, airball_sensor_board_v4.sch]
2018-03-29 Another WIP commit for display v1
    [airball_display_board_v1.brd, airball_display_board_v1.sch]
2018-03-29 WIP for sensor v5
    [airball_sensor_board_v5.brd, airball_sensor_board_v5.sch]
2018-03-29 New firmware for sensor v4; sentences types; API mode
    The new data sent from the probe looks like the following examples:
    An airdata sentence:
    $A,3000,82817.88,27.50,-2.46,-7.29,-4.11
    The columns are: sentence type, sequence number, baro, oat, dp0, dpA,
    dpB.
    A battery management sentence:
    $B,75,4.07,-84.38,1545.60,0.11
    The columns are: sentence type, sequence number, battery voltage,
    battery charge/discharge rate (mA), battery capacity in mAh and
    fraction. While the voltage and rate will remain, the rest of the
    sentence is still subject to change.
    The sentence type is new in this version; previous versions of the probe
    software's output correspond to the airdata/$A sentence. The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
2018-04-02 Fixed a bug where the location of the "decorations" (alpha X, alpha Y, alpha Ref) was shown incorrectly because of inconsistent units (degrees versus radians). Added a "replay" capability to replay a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
    [ab_main.cpp, display.cpp, display.h, settings.cpp]
2018-04-10 Updated API of airball::TelemetryClient. Implemented a fake version and wired that into the "ab" desktop test executable. The actual "ab_device" on-device version remains TBD pending architecture of 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
2018-04-10 Created skeleton for a SystemStatus class that gets to "see" all the telemetry and keeps track of the general health of the system, for use in showing status to the user.
2018-04-11 Added a visual representation of probe battery status and wireless link status to the display.
2018-04-21 Refactored "telemetry_client.h" (interface TelemetryClient) so that it uses more of the existing "sample" class hierarchy. Since class "sample" is polymorphic, this required passing around pointers t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
2018-04-21 Created a concrete implementation of TelemetryClient, called XbeeTelemetryClient, that refactors into a reusable component the functionality of the existing airball_probe_telemetry.cpp. This componen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
    Wired up XbeeTelemetryClient into the display code, and removed the
    legacy logging functionality from the display code.
    This work has yet to be bench-tested. However, the risk of breaking
    airball_probe_telemetry.cpp with these refactorings is very low. The
    main display program ab_device.cpp has been broken anyway while this
    work has been going on so it's not a regression. The demo program
    ab.cpp is verified to be working properly with dummy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
    [ab_main.cpp, controller.cpp, controller.h]
2018-04-22 Add support for configurable 10 or 30 inH2O sensors
2018-04-22 Add support for OneWire OAT sensors, report OAT less frequently
2018-04-27 Added a run script for the Raspberry Pi.
2018-04-28 Improved calculation of "wireless link bars" from RSSI values.
2018-05-02 Added really primitive "bar chart" to airball_probe_telemetry showing the milliseconds since the last datum, and the RSSI value.
2018-07-20 Airball Display Board v1 as built
    [airball_display_board_v1.brd, airball_display_board_v1.sch]
2018-07-20 Use battery voltage for battery gauge
    The battery capacity reported by the probe is currently incorrect, so
    use the battery to show to the user instead. The gauge now shows the
    battery voltage where 100% is >= 4.2V and 0% is 3.3V.
2018-08-13 Adding a data directory.
    [partial.csv]
2018-08-19 Added Vr, Vfe, Vno, and Vne to the display, and settings for these. Changed the display code so that 480x272 is now the default resolution for everything, since that is the screen size that all our d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
2018-08-26 Refactored XBee interface to separate concerns and provide flexibility in anticipation of handling different kinds of XBee modules.
    Added tests to the airball_probe_telemetry/ dir and renamed the test
    executables so they don't conflict.
    Patched a couple of tests in the display/ dir that were failing; added
    TODOs to look into them later.
    [system_status_test.cpp]
2018-08-29 Refactored to move responsibility for reading and writing frames to the xbee_api_frame class, and added tests for this and the xbee_api_payload subclasses. Made the various utilities auto-sense the t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
2018-09-01 Added new frame types for sending and receiving AT commands in API mode.
    The problem this change was trying to solve is that, if you are hoping
    to configure the XBee based on data you *read* from it, and it's already
    in transparent mode and receiving data, then you may end up eating a lot
    of garbage data and it's hard to synchronize.
    My attempted solution was to try to *always* go into API mode, and then
    send everything, including AT commands, in API mode. That way we could
    read back various status bits (e.g. the hardware type of the XBee) and
    be assured of synchronizing properly in the various data streams.
    Pushing this through was not as successful as I had hoped. An XBee that
    was being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
2018-09-02 Updated the list of required Arduino libraries
2018-09-02 Add AllSensors_DLV to the list of required Arduino libraries
2018-09-02 Add TimerOne to the list of required Arduino libraries
2018-09-04 Allow setting of pressure measurement type by define
2018-09-04 Add measurement offset support
    Add support for storing measurement offsets in EEPROM and manually
    setting them via the serial console. The following commands were added:
    * MO? - Print the current measurement offsets.
    * MO! - Save the current measurement offsets to EEPROM.
    * MO.dp0=<value> – Set the dp0 offset.
    * MO.dpA=<value> – Set the dpA offset.
    * MO.dpB=<value> – Set the dpB offset.
2018-09-06 Rename arduino -> firmware, eagle -> hardware
    [airball_display_board_v1.brd, airball_display_board_v1.sch, airball_sensor_board_v1.brd, airball_sensor_board_v1.sch, airball_sensor_board_v2.brd, airball_sensor_board_v2.sch, airball_sensor_board_v3.brd, airball_sensor_board_v3.sch]
2018-09-10 Correctly report battery health instead of always 1.0
    [system_status.cpp]
2018-09-10 Draw properly sized battery bargraph
2018-09-10 Hide the battery and radio signal widgets when signal is lost
2018-09-10 Improve the battery status indicator
    A few improvements for the battery status indicator:
    * Show lightning bolts when the battery is charging.
    * Show the battery voltage and current when charging, or optionally all
    the time if a boolean is set.
    Some plumbing work was done to store the most recent battery sample in
    the SystemStatus class.
2018-09-30 Modified probe firmware to support 900 MHz XBee PRO S3B wireless modules, optionally enabled via a #define.
2018-10-07 Add command line arguments to the 'ab_device' binary, so the Raspberry Pi config is not hard coded. The most immediate need is to run it using different types of XBee, but eventually we might want to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
2018-10-08 Set 900MHz power level to maximum by default.
2018-10-08 Rename directories to make them more memorable and easier to type. :) Our dirs are now neatly divided into "firmware" (Arduino stuff) and "host" (Linux stuff).
2019-03-31 Add a device keyboard listener so that an operator can connect a USB keyboard to a running device and cause it to exit from its GUI for debugging.
2019-04-12 Add better filtering to climb rate, and add an autozero phase.
2019-04-12 Fix a bug in climb rate calculation.
    [airdata.cpp]
2019-04-18 Fix bugs in the altitude calculation.
    [aerodynamics.cpp, aerodynamics.h, airdata.cpp, airdata_test.cpp]
2019-04-28 ADXL 345 calibration and reading code, mostly from SparkFun, to use the SparkFun ADXL breakout board to get acceleration values.
2019-05-18 Added a program to read telemetry CSV files and run them through the airdata computation, producing a CSV of the raw pressures plus the computed values of alpha, beta, IAS, etc.
2019-08-05 Updated libraries and added one for the BMP388 pressure sensor.
2019-08-05 First cut of Airball V6 sensor board.
    [airball_sensor_board_v6.brd, airball_sensor_board_v6.sch]
2019-09-01 * Removed autozero from display code -- autozero is the responsibility of the sensor suite from now on. * Added a new data source for demo use, which reads from flight log files. * Changed the way we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
2019-09-01 Bug fixes to climb rate calculation.
    [airdata.cpp, airdata.h, airdata_test.cpp, display.cpp]
2019-09-01 Increase probe-display baud rate to 19200.
2019-09-01 * Add an internal pressure sensor autozero function to the probe. * Increase probe-display baud rate to 19200.
2019-09-01 Improved climb rate initialization and fixed a bug in the smoothing formula.
    [airdata.cpp, airdata.h]
2019-09-01 Fix a parameter name in a header.
    [display.h]
2019-09-02 Add guards on the input to the smoothing filter so that, if we get singularities due to flakey sensor inputs (as when we're sitting on the ground and the wind is blowing from every which way), and we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
2019-09-08 New sensor design that relies on an Arduino Pro Micro and a SparkFun Battery Babysitter as daughterboards to outsource some of the complexity.
    [airball_sensor_board_v7.brd, airball_sensor_board_v7.sch]
2019-09-08 Minor fix to remove an airwire.
    [airball_sensor_board_v7.brd, airball_sensor_board_v7.sch]
2019-09-08 Improved routing of UART traces - added a ground plane between them and moved them away from board edge.
    [airball_sensor_board_v7.brd]
2019-09-08 Improved silk screen.
    [airball_sensor_board_v7.brd]
2019-09-08 Changed use of Bosch BMP388 sensor so that we are using the Adafruit breakout board instead of soldering the sensor on directly. This saves us some finicky SMT work.
    [airball_sensor_board_v7.brd, airball_sensor_board_v7.sch]
2019-09-08 Increased BMP388 mounting hole diameter to 122 mils.
    [airball_sensor_board_v7.brd, airball_sensor_board_v7.sch]
2019-09-08 Moved BMP388 breakout to allow more space for plumbing.
    [airball_sensor_board_v7.brd]
2019-09-16 Simplified Airball probe sketch for Airball board V7.
2019-09-20 Added support for battery monitoring. Simplified the code in XBee.h to no longer use API mode.
    [XBee.h, airball_probe.ino]
2019-09-25 No longer using Dallas Temperature library, which made too many reads and writes on the 1Wire bus. Instead, using raw byte operations to the OAT sensor which save us precious milliseconds.
    [airball_probe.ino]
2019-10-13 Made some changes to be compatible with custom Airball display board.
2019-10-25 Fix some docs. Add a feature where a 10-second press of the adjust knob exits the program, to permit us to build a system that boots into the display but can be exited if need be for command line deb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
    [controller.cpp]
2019-12-29 Bug fix to match API change.
    [ab_main.cpp]
2020-01-04 Make log reading robust against invalid log lines that sometimes end up in the log files when the RasPi shuts down due to a hard power-off without a clean filesystem shutdown.
2020-02-26 Updated V7 board schematics
    [airball_sensor_board_v7.brd, airball_sensor_board_v7.sch]
2020-02-26 Exported data from Eagle for V4 board for easier study
    [airball_sensor_board_v4_partlist.csv]
2020-02-26 Updated V4 schematic - previous export was only 1 page
2020-02-27 Made more robust in case of inflight restart
    Added #define to enable or disable autozero, and clamped dp0 to never be
    negative.
2020-03-15 Initial entry for ESP32 powered probe, with built-in calibration curves.
2020-03-15 Added flashing LED to indicate progress.
2020-03-15 Added more tests, fixed some bugs, and improved the simple Arduino sketch.
    [airball_probe_esp32.ino, calibration_surface.cpp, calibration_surface_test_main.cpp, generate_calibrations.py]
2020-03-15 More improvements and bug fixes.
    [airball_probe_esp32.ino, calibration_surface.h, generate_calibrations.py, pressures_to_airdata.cpp, pressures_to_airdata.h]
2020-03-21 Completed first draft of ESP32 / WiFi probe firmware.
2020-04-12 Started work on V8 sensor board with ESP32-WROOM-32U
    [airball_sensor_board_v8_fwd.brd, airball_sensor_board_v8_fwd.sch]
2020-04-13 Finished initial design and routing.
    [airball_sensor_board_v8_fwd.brd, airball_sensor_board_v8_fwd.sch]
2020-04-13 Applied design rules and improved the board.
    [airball_sensor_board_v8_fwd.brd]
2020-04-19 More routing and design.
    [airball_sensor_board_v8_fwd.brd, airball_sensor_board_v8_fwd.sch]
2020-04-19 Finished routing board; ground planes still not done.
    [airball_sensor_board_v8_fwd.brd]
2020-04-19 Updated descriptions and documentation.
    [airball_sensor_board_v8_fwd.brd, airball_sensor_board_v8_fwd.sch]
2020-04-19 Renamed files for clarity.
    [airball_sensor_board_v8_main.brd, airball_sensor_board_v8_main.sch]
2020-04-20 More routing and documentation fixes.
    [airball_sensor_board_v8_main.brd, airball_sensor_board_v8_main.sch]
2020-04-20 More routing fixes.
    [airball_sensor_board_v8_main.brd]
2020-04-20 Added reference to previous prototype.
2020-06-29 New Sensor Board v8
    New sensor board V8, based on feedback about the previous v8 and
    using more specific components for the switch and USB connector.
    [airball_sensor_board_v8.brd, airball_sensor_board_v8.sch]
2020-06-29 Formatting
    Added titles and formatting to schematic and board.
    [airball_sensor_board_v8.brd, airball_sensor_board_v8.sch]
2020-06-29 Old versions removed
    Removed old copy of v8 sensor board.
    [airball_sensor_board_v8_main.brd, airball_sensor_board_v8_main.sch]
2020-07-02 Finishing touches to the board, sent to manufacturing.
    [airball_sensor_board_v8.brd, airball_sensor_board_v8.sch]
2020-07-03 Updated solder mask and pads for BMP388.
    [airball_sensor_board_v8.brd, airball_sensor_board_v8.sch]
2020-10-18 Added new client program for ESP32 probe, based on PyGame.
2020-11-07 Updated client software for ESP32 Wi-Fi probe and $AR (Airdata Reduced) data sentences.
2020-11-22 Next rev of sensor board v8
    Moved pressure sensors to more accessible location; added a pullup and
    capacitor for one of the ESP32 pins for USB access; changed pressure
    sensor to the newer BMP390; changed pressure sensor pads to support
    either SMD or thru-hole variants; cleaned up the locations of the
    barometer and its mounting holes.
    [airball_sensor_board_v8.brd, airball_sensor_board_v8.sch]
2020-11-27 Changed to Molex USB-C connector
    Switched to a more readily available Molex USB-C connector.
    [airball_sensor_board_v8.brd, airball_sensor_board_v8.sch]
2020-12-13 Initial checkin of Display Board v2 design
    [airball_display_board_v2.brd, airball_display_board_v2.sch]
2020-12-21 Cleaned up schematic
    [airball_display_board_v2.brd, airball_display_board_v2.sch]
2020-12-22 Minor improvements to display board.
    [airball_display_board_v2.brd, airball_display_board_v2.sch]
2020-12-22 Removed some stub wires prior to manufacture.
    [airball_display_board_v2.brd]
2021-01-03 Updated filtering for climb rate to use an actual digital filter.
2021-01-03 Fixed a little jagged trace. Should not have been a functional problem.
    [airball_display_board_v2.brd]
2021-01-04 Minor changes to "airball_probe_esp32.ino". Also updated calibration for v2 probe, as described in:
    http://www.airball.aero/2021/01/rough-calibration-using-car.html
2021-01-10 Working on instructions for probe construction.
2021-01-10 Further work on probe mechanical instructions.
2021-01-12 Next step of probe instructions.
2021-01-16 Deleting material that is now in the "airball-mechanical" repo.
2021-02-10 Added a missing unit conversion: "$AR" sentences have angles expressed in degrees for easy readability, but internal calculations in our code are all done in radians for math compatibility.
    [airdata.cpp]
2021-05-09 New calibration by Wichita State team.
    [10psf,smooth,fairing.csv, 15psf,smooth,fairing.csv, 20psf,smooth,fairing.csv, 5psf,smooth,fairing.csv]
2021-08-07 Update to calibration procedure with documentation.
2021-08-28 Change settings scheme considerably. JSON file now contains values in knots and degrees, and the executable has an inotify listener to watch for changes. This is in anticipation of having a Web serve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
2021-08-29 Fix bug in display of VSI tick marks.
    [display.cpp]
2021-10-02 Updated calibration for probe head with explicit static probe.
    [10psf,smooth,fairing.csv, 15psf,smooth,fairing.csv, 20psf,smooth,fairing.csv, 5psf,smooth,fairing.csv, staticprobehead_20psf.csv, staticprobehead_5psf.csv]
2021-11-13 Fixed a bug in absolute value calculation.
    [pressures_to_airdata.cpp]
2021-11-13 Modified calibration so that alpha/beta curves are constrained to go through the axis, to eliminate residuals at zero.
2021-11-20 Checkpoint checkin for work in progress on Sensor V8.
    [airball_sensor_board_v8.brd]
2021-11-20 Added QWIIC I2C connector and rearranged a bit.
    [airball_sensor_board_v8.brd, airball_sensor_board_v8.sch]
2021-11-20 Minor change to silkscreen.
    [airball_sensor_board_v8.brd]
2021-11-21 Changed location of barometer and mounting.
    [airball_sensor_board_v8.brd]
2021-11-21 Updated temperature sensor board with QWIIC connector.
    [airball_sensor_board_v8_temp.brd, airball_sensor_board_v8_temp.sch]
2021-11-21 Completed temperature sensor board.
    [airball_sensor_board_v8_temp.brd]
2021-12-17 Modified to use 16-bit signed PCM for a Raspberry Pi stereo output jack.
2021-12-17 Added a PWM layer class.
2021-12-19 Changed the sine-wave layers to compute the sine function just-in-time rather than trying to maintain a table of values. A process doing this on a Raspberry Pi uses only a few percent of CPU time, an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
2021-12-19 Refactored to properly handle changing sound parameters for each layer. Each layer now keeps track of its own phase position, and the mutable sine function layer now makes sure to switch frequencies 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
2021-12-25 More updates to add gradual transitions between parameters and avoid clicking and popping in the audio output.
    [balance_layer.cpp, balance_layer.h, pwm_layer.cpp, pwm_layer.h, sine_envelope_layer.h, sine_layer.cpp, sine_layer.h, sound_mixer_main.cpp]
2021-12-26 Changed pwm_layer logic to be smoother and revert to a partial sawtooth if there is not enough room to do a full fade-in and fade-out.
    [pwm_layer.cpp, sound_mixer_main.cpp]
2021-12-27 Created a mini-framework for sound schemes that map airdata to sounds. Moderate changes to pwm_layer. Added the first sound scheme.
2021-12-28 Added FlyONSPEED sound scheme. Updated test harness for better ease of use. Fixed some bugs.
    [balance_layer.cpp, balance_layer.h, flyonspeed_scheme.cpp, flyonspeed_scheme.h, sound_mixer.cpp, sound_mixer.h, sound_scheme_main.cpp, windrush_scheme.cpp]
2021-12-31 Added sound output to the basic Airball binary "ab". Renamed "windrush" to "stallfence" sound scheme. Added settings support for audio features. Removed unused "ab_device" binary.
    [ab_main.cpp, controller.cpp, controller.h, flyonspeed_scheme.cpp, isettings.h, settings.cpp, settings.h, sound_scheme_main.cpp]
2022-01-08 Climb rate filtering is now based on a cubic fit to the past <N> data points, rather than a low-pass filter (which had too much phase lag).
    [airdata.cpp, airdata.h, cubic_rate_filter.cpp, cubic_rate_filter.h, polyfit.cpp, polyfit.h]
2022-01-08 Improved battery status display.
2022-01-09 Removed fancy characters for battery display since default fonts were not supporting them.
2022-01-09 Put framebuffer into graphics mode, preventing console messages from polluting the display.
2022-01-09 File descriptor to switch to graphics mode should be the current console, not the framebuffer file descriptor!
2022-01-16 Changed Wi-Fi network parameters. Using red LED to signal system status.
2022-01-16 Send battery status messages by default.
2022-01-16 Guarded periods to be at least 1, so we don't get divide by zero errors.
    [pwm_layer.cpp, sine_envelope_layer.cpp, sine_layer.cpp]
2022-01-16 Change to correct hardware sound device.
2022-01-17 Modified Wi-Fi configuration so that the Raspberry Pi is the base station, while the probe claims a static IP address on the network.
2022-01-17 Adding /var/www/ for the display device.
2022-03-05 Fixed bugs in climb rate filter and improved startup.
    [cubic_rate_filter.cpp, cubic_rate_filter.h, display.cpp]
2022-03-06 Increased the maximum period of the climb rate filter.
2022-06-06 Added a setting to change speed units between knots and mph.
2022-09-04 Added a program to help estimate framebuffer fps.
2022-10-25 Preliminary version of ST7789VI display that uses the Raspberry Pi Secondary Memory Interface.
2022-11-23 Updated threading model of the ST7789VI screen class.
2022-12-10 Improved reconnection logic of the probe.
2023-05-12 Broke out Wi-Fi options into their own classes.
    [airball_probe_esp32.ino, wifi_access_point.cpp, wifi_access_point.h, wifi_client.cpp, wifi_client.h, wifi_interface.h]
